foukouda/OPEN_WEIGHT/kibot_resources/templates/readme.txt

<p align="center" width="100%">
  
</p>

<h1 align="center">${PROJECT_NAME} – ${BOARD_NAME}</h1>

<p align="center">
  High-precision load-cell / force measurement PCB based on the AD7190
</p>

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

<p align="center">
  3D Top Angled
&nbsp; &nbsp; &nbsp; &nbsp;
  3D Bottom Angled
</p>

<p align="center">
  OPEN_WEIGHT 3D spin
  <br><sub>Full-resolution video: <a href="Images/OPEN_WEIGHT.mp4">Images/OPEN_WEIGHT.mp4</a> (rendered with SpinRender)</sub>
</p>

***

## OVERVIEW

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

***

## PROJECT CONTEXT

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

***

## DESIGN GOALS

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

***

## SPECIFICATIONS

### Electrical specifications

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

### Power budget

Power chain: **+3.3 V (host) → TPS61086 → +6 V → LT3042 → +5VA → AD7190**

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

> **Note:** Load cell excitation current depends on bridge resistance. The estimate above assumes a 350 Ω full bridge at 5 V excitation (~14 mA). A 1000 Ω bridge draws ~5 mA instead, reducing total board consumption significantly. TPS61086 efficiency is estimated from the datasheet curve at Vin=3.3 V, Vout=6 V. Always measure at your specific operating point using the **+3.3V_IN** test point on Page 6.

### Physical specifications

| Parameter | Value |
| --- | --- |
| Project name | OPEN_WEIGHT |
| Board name | AD7190 |
| Parent project | OPEN THRUST LAB |
| CAD tool | KiCad 10 |
| Automation tooling | KiBot + GitHub Actions |
| Dimensions | ${bb_w_mm} × ${bb_h_mm} mm |
| Mounting holes | 4× M3, connected to GND |
| Fiducials | Not fitted on this revision (FID1–FID6 excluded from board) |
| Fabrication target | JLCPCB 4-layer, JLC04161H-7628, 1.6 mm (rules in `OPEN_WEIGHT.kicad_dru`) |
| Repository status | In active development |
| Hardware licence | CERN-OHL-P v2 |

***

## SCHEMATIC ARCHITECTURE

The project is organized into five functional hierarchical sheets (under `Project Architecture`), plus the documentation sheets (Revision History, Block Diagram, Power - Sequencing):

| Page | Sheet (file) | Description |
| --- | --- | --- |
| 4 | `AD7190_Weight_Sensor` (`AD7190 - Weight Sensor.kicad_sch`) | AD7190 24-bit sigma-delta ADC front-end for Wheatstone bridge acquisition. Differential inputs on SENSE± and OUT± lines with RC input filtering. SPI interface (CS, DIN, DOUT, SCLK, SYNC). 4.9152 MHz ceramic resonator (Y2). Ratiometric reference REFIN1 = SENSE± (bridge excitation). Dual-supply decoupling (+5VA analog / +3.3V digital). Q1 P-MOS excitation switch driven by AD7190 P3. Test points on all critical analog and digital nodes. |
| 5 | `LT3042_6V_to_5VA` (`LT3042 - LDO 6V to 5VA.kicad_sch`) | Low-noise 5 V analog supply for ADC front-end (AVDD). LT3042 ultralow-noise LDO (PSRR > 75 dB). Input: +6V from boost stage. Output: +5VA regulated via RSET = 50 kΩ (ISET = 100 µA). Solid tantalum capacitor on SET pin (C14 = 2.2 µF) for noise suppression — soft-start time constant RSET·CSET = 110 ms. Power-Good monitoring via PGFB divider. Test points: VIN, VOUT, SET, PGFB, PG. |
| 6 | `TPS61086_3.3V_to_6V` (`TPS61086 - Boost 3V3 to 6V.kicad_sch`) | 3.3 V to 6.04 V boost converter (external Schottky D3) supplying the LT3042 stage. TPS61086 switching at 1.2 MHz fixed frequency (PWM/PFM selectable via MODE pin). Integrated 2.0 A / 0.13 Ω power switch. Output voltage set via FB divider R17/R15 (1.238 V × (1 + 69.8k/18k) = 6.04 V). Input/output decoupling, soft-start, and loop compensation network. Test points: +3.3V_IN, +6V_OUT, FB, COMP. |
| 7 | `Holes, Fiducials` (`Holes - Fiducials.kicad_sch`) | Mechanical references for PCB fabrication and assembly. Four GND-connected mounting holes (H1–H4, M3). Fiducial symbols FID1–FID6 are kept in the schematic but excluded from the board on this revision. |
| 8 | `Connectors` (`Connectors.kicad_sch`) | External interface connectors for load cell and host communication. Two 5-pin load-cell connectors J2/J4 (21033213501: OUT, OUT, EXC+, EXC−, GND). 7-pin JST-XH host header J1 (+3.3V, CS, DIN, DOUT/RDY, SYNC, SCLK, GND). WE-SHC shielding frame H5 over the analog front-end. |

***

## SIMULATION (LTspice)

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

**Models**

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

**Results**

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

**Re-run the simulations** (Windows, LTspice installed in the default location):

```bash
cd Simulation/LTspice
python run_simulations.py              # runs LTspice in batch mode, redraws Images/Simulation/*.png and results.md
python run_simulations.py --only 03 04 # runs only these simulations, then redraws
python run_simulations.py --no-run     # only redraw from the existing .raw files
```

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

***

## LAYOUT COUPLING (openEMS)

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

**Results**

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

The complete tables are in [`Simulation/openEMS/results.md`](Simulation/openEMS/results.md).

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

**Re-run the simulation** (Windows, openEMS and its Python 3.11 environment installed in `C:\openEMS`):

```bash
cd Simulation/openEMS
"C:\Program Files\KiCad\10.0\bin\python.exe" export_kicad_geometry.py   # copper of the board -> geometry.json
C:\openEMS\venv\Scripts\python.exe sw_coupling.py --check               # mesh the board and verify the nets
C:\openEMS\venv\Scripts\python.exe sw_coupling.py --case open           # the four drives on the bare board
C:\openEMS\venv\Scripts\python.exe sw_coupling.py --case shield         # the same with the cover
C:\openEMS\venv\Scripts\python.exe measurement_quality.py               # results.md and the figure
```

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

***

## LOAD CELL CONNECTION

The board accepts any standard **4-wire Wheatstone bridge** load cell.

### Load-cell connectors J2 / J4 (21033213501, 5 pins)

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

### Compatible load cell characteristics

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

### Host header J1 (JST-XH B7B-XH-AM, 7 pins)

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

***

## STARTUP SEQUENCE

After 3.3 V is applied, allow the following stages to complete before issuing any SPI command
(see schematic page 9, *Power - Sequencing*; values from the [LTspice simulations](#simulation-ltspice)):

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

After the delay, the recommended initialization sequence is:

```
1. Issue AD7190 serial reset: assert CS̄, write 40+ bytes of 0xFF on DIN
2. Write CONF register (gain, reference, chop settings)
3. Write MODE register (filter, ODR)
4. Run internal zero-scale calibration — wait for DRDȲ
5. Run internal full-scale calibration — wait for DRDȲ
6. Enable load cell excitation: GPOCON GP32EN=1, P3DAT=0 (Q1 on)
7. Run system calibration with known reference weight
8. Enter continuous conversion mode
```

***

## CALIBRATION

Two levels of calibration are required. Both must be repeated after every power cycle.

### 1. Internal calibration

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

```
Write MODE register: MD[2:0] = 0b001  (internal zero-scale)
→ Wait for DRDȲ to go low

Write MODE register: MD[2:0] = 0b010  (internal full-scale)
→ Wait for DRDȲ to go low

Results are saved in the ZERO and FULLSCALE registers.
Read them back to cache for faster subsequent startups.
```

### 2. System calibration

Maps ADC output codes to physical units. Repeat any time the mechanical setup changes.

```
1. Remove all load → average ≥16 samples → raw_zero
2. Apply known weight W_ref → average ≥16 samples → raw_full
3. scale_factor = W_ref / (raw_full − raw_zero)
4. weight = (raw_code − raw_zero) × scale_factor
```

### Recommended register configuration

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

***

## HOW TO USE

### Prerequisites

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

### Generate outputs locally

```bash
# Default configuration
./kibot_launch.sh

# Specific variant
./kibot_launch.sh -v CHECKED
```

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

### Use a manufactured board

```c
// --- After >= 600 ms from 3.3V power-on (LT3042 soft-start, see page 9) ---

// 1. Reset
ad7190_reset();                            // 40× 0xFF on DIN

// 2. Configure
ad7190_write_reg(REG_CONF,
    CONF_GAIN_128 | CONF_CHOP | CONF_REFSEL_REFIN1);
ad7190_write_reg(REG_MODE,
    MODE_SINC4 | MODE_FS_10HZ);

// 3. Internal calibration
ad7190_write_reg(REG_MODE, MODE_INT_ZERO_CAL);
while (drdy_is_high());
ad7190_write_reg(REG_MODE, MODE_INT_FULL_CAL);
while (drdy_is_high());

// 4. Enable load cell excitation
ad7190_write_reg(REG_GPOCON, GPOCON_GP32EN); // P3 = 0 -> Q1 on

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

// 6. Continuous measurement
ad7190_write_reg(REG_MODE, MODE_CONTINUOUS);
while (1) {
    while (drdy_is_high());
    uint32_t raw = ad7190_read_data();
    float weight = (raw - raw_zero) * scale;
}
```

***

## REPOSITORY CONTENT

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

***

## DIRECTORY STRUCTURE

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

***

## DEVELOPMENT WORKFLOW

This project uses a reproducible hardware workflow based on **KiCad 10**, **KiBot**, and **GitHub Actions**.

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

**Release a new hardware revision:**

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

***

## TROUBLESHOOTING

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

***

## CONTRIBUTING

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

### Requirements

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

### Workflow

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

### Reporting issues

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

***

## CHANGELOG

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

***

## LICENSE

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

See [LICENSE](LICENSE) for the full licence text.

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

> For more on CERN-OHL licences: [ohwr.org/cern_ohl](https://ohwr.org/cern_ohl)
