foukouda/OPEN_WEIGHT/Schematic/OPEN_WEIGHT-schematic-5.pdf

1 | 2 | 3 | 4 | 5 | 6 | 7 | 8

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
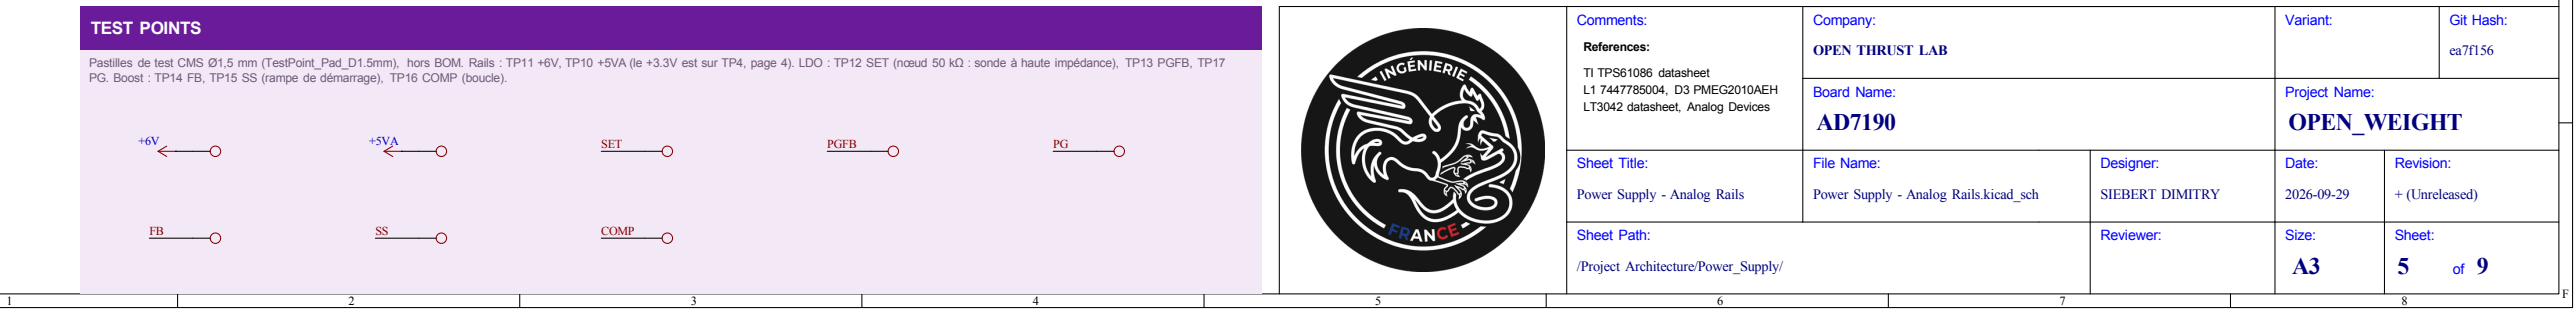
[picture p14: figure]
Sheet: of 9; Size: A3; Sheet Title:; File Name:; COMP; SET; PGFB; TEST POINTS; L1 7447785004, D3 PMEG2010AEH

Revision: + (Unreleased) Date: Project Name: 2026-09-29 Reviewer: Designer: Power Supply - Analog Rails.kicad_sch | SIEBERT DIMITRY
Board Name: Company: | Variant: OPEN THRUST LAB AD7190 | OPEN_WEIGHT
/Project Architecture/Power_Supply/ Sheet Path: Power Supply - Analog Rails Comments: | Git Hash: ea7f156 D¹ LED

D3 PMEG2010AEH

+6V R¹⁴ ²⁰⁰kΩ | C17 | 2.2nF R¹⁸ ³⁷.4kΩ C18 | 0.1uF | R¹⁵¹⁸kΩ | C1910µF R¹⁷ ⁶⁹.8kΩ C221µF
PWR_FLAG R³¹⁰⁰Ω | C2110µF | R¹⁶ 620Ω C134.7µF | C1510µF | D⁴ LED R¹³ ⁵⁰kΩ
IN 1 EN/UV 3 | PG 4
ILIM 5 | PGFB 6 SET 7 | GND

8 OUTS 9 OUT 10 U2 LT3042IMSE

+5VA

GND

+3.3V

+6V | R⁹⁵⁰kΩ
1 | 2 L1
7447785004 R¹² 715kΩ | C2010µF

1 2 C14

TAJA225K016RNJ C164.7µF | COMP | 1 FB
EN | 2
3 | AGND 4 | PGND 5 | SW_1 | 6
IN 8 | MODE 9 | SS 10 EP 11

IC2 TPS61086DRCR

GND

+6V

SET

SS

PG

PGFB

COMP

FB | DESCRIPTION

# [5] Power Supply - Analog Rails

- EN = +3.3V : démarre avec l'hôte. MODE = GND : Power Save à faible charge, raies sous 1.2 MHz quand les ponts sont coupés ; MODE à IN forcerait le PWM à fréquence fixe. • COMP : R18 37.4 kΩ + C17 2.2 nF vers AGND. SS : C18 0.1 µF chargé par 10 µA, limite le courant d'appel. • L1 Würth 7447785004 : 4.7 µH, blindée, Isat 2.5 A. D3 PMEG2010AEH : Schottky 20 V / 1 A. • Entrée C21 10 µF + C22 1 µF, sortie C19 + C20 10 µF. D1 par R3 100 Ω : ≈ 15 mA, presque un quart du courant pris à l'hôte. Boost VOUT = 1.238 V × (1 + 69.8 kΩ / 18 kΩ) = 6.04 V (sim 01 : 6.037 V) D = (6.04 + 0.35 − 3.3) / 6.39 = 0.48 ; Iout ≈ 23 mA → conduction discontinue, Ipk ≈ 0.16 A (sim 03 : 0.17 A)

Démarrage : 90 % en 1.1 ms, dépassement 6.35 V, appel 1.13 A < Isat 2.5 A
LDO
VOUT = 100 µA × 50 kΩ = 5.00 V ; VPG = 0.3 V × (1 + 715 kΩ / 50 kΩ) = 4.59 V
τ = RSET × CSET = 110 ms : 99 % en 241 ms, 99.9 % en 494 ms Marge 1.04 V × ≈ 23 mA ≈ 24 mW (+ 12 mW de courant de repos) Bruit et consommation +6V : 0.7 mV crête-crête (bande 20 MHz) ; PSRR 92 dB à 1.2 MHz ; +5VA < 1 µV crête-crête +3.3V pris à l'hôte : 66.5 mA, dont D1 ≈ 15 mA et D4 ≈ 5 mA

Chaîne : +3.3V (hôte, J1) → IC2 TPS61086, boost 1.2 MHz → +6V → U2 LT3042, LDO très bas bruit → +5VA. Le boost laisse ≈ 1 V de marge au LDO ; le +5VA alimente AVDD de l'AD7190 et l'excitation des ponts (page 4).

IC2 : interrupteur intégré 2.0 A / 0.13 Ω, L1 4.7 µH, D3 Schottky, régulation par R17 / R15 sur FB. U2 : source de courant 100 µA dans R9 (SET), suiveur de gain unitaire, 0.8 µV rms de 10 Hz à 100 kHz. Témoins : D1 sur +3.3V, D4 sur +5VA. Simulé dans Simulation/LTspice (modèle comportemental du TPS61086).

## DESIGN NOTE · BOOST

- IN et EN/UV sur +6V, ILIM à GND (limite interne). C16 4.7 µF en entrée, C13 4.7 µF + C15 10 µF en sortie (4.7 µF minimum pour la stabilité). • SET : R9 50 kΩ + C14 2.2 µF tantale solide KYOCERA AVX TAJA225K016RNJ (16 V, boîtier A, ESR 6.5 Ω) : pas d'effet piézo comme une céramique, important avec les vibrations du banc (datasheet p.16). • PGFB : R12 715 kΩ / R13 50 kΩ. PG (drain ouvert) tiré à +6V par R14 200 kΩ, sur TP17 seulement. D4 par R16 620 Ω. LAYOUT NOTE
- Boucle SW → D3 → C19 / C20 → PGND la plus courte : source principale du couplage magnétique vers les entrées de l'AD7190 (openEMS). Boucle d'entrée C21 / C22 → L1 → IC2 compacte, L1 loin des voies AIN. • Nœud SW minimal, réseau COMP / FB / SS sur AGND à l'écart de SW ; pads exposés de IC2 et U2 au plan GND par vias. • C14 et R9 au ras de SET (nœud 50 kΩ), OUTS en Kelvin sur les condensateurs de sortie, U2 loin de SW. CALCULS & BUDGET

Pastilles de test CMS Ø1,5 mm (TestPoint_Pad_D1.5mm), hors BOM. Rails : TP11 +6V, TP10 +5VA (le +3.3V est sur TP4, page 4). LDO : TP12 SET (nœud 50 kΩ : sonde à haute impédance), TP13 PGFB, TP17 PG. Boost : TP14 FB, TP15 SS (rampe de démarrage), TP16 COMP (boucle).

## DESIGN NOTE · LDO

## BOOST · IC2 TPS61086, +3.3V → +6V, 1.2 MHz

## LDO TRÈS BAS BRUIT · U2 LT3042, +6V → +5VA

FB : R17 69.8 kΩ / R15 18 kΩ → 6.04 V · COMP : R18 37.4 kΩ + C17 2.2 nF · SS : C18 0.1 µF · MODE = GND (Power Save)

TI TPS61086 datasheet References: LT3042 datasheet, Analog Devices Typical Applications de la datasheet LT3042 : topologie seulement

Figure 26 de la datasheet TPS61086 : placement recommandé RSET = R9 50 kΩ, CSET = C14 2.2 µF tantale, PG à 4.59 V (R12 / R13)

IC2 TPS61086DRCR

COMP | 1 FB
EN | 2
3 | AGND 4 | PGND 5 | SW_1 | 6
IN 8 | MODE 9 | SS 10 EP 11 | R¹² 715kΩ | D3 PMEG2010AEH
C17 | 2.2nF R¹⁸ ³⁷.4kΩ C18 | 0.1uF | R¹⁵¹⁸kΩ | C1910µF R¹⁷ ⁶⁹.8kΩ C134.7µF | C1510µFR¹³ ⁵⁰kΩ R¹⁴ ²⁰⁰kΩ

+6V

C2010µF | +6V

PWR_FLAG
