foukouda/OPEN_WEIGHT/Schematic/OPEN_WEIGHT-schematic-6.pdf

1 | 2 | 3 | 4 | 5 | 6 | 7 | 8
1 | 2 | 3 | 4 | 5 | 6 | 7 | 8

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
### Sheet: of 9 Size: A3

Revision: + (Unreleased) Date: Project Name: 2026-09-29 Reviewer: Designer: Holes - Fiducials.kicad_sch | SIEBERT DIMITRY
Board Name: Company: | Variant: OPEN THRUST LAB AD7190 | OPEN_WEIGHT
Sheet Title: | File Name:
/Project Architecture/Holes, Fiducials/ Sheet Path: Holes, Fiducials Comments: | Git Hash: ea7f156
H3 | H4 GND
H1 | H2 | FID5 Fiducial FID6 Fiducial FID3 Fiducial FID1 Fiducial FID2 Fiducial | FID4 Fiducial | CALCULS & BUDGET
[6] Holes,

# Fiducials

TROUS DE FIXATION · H1 À H4, M3, RELIÉS AU GND | FIDUCIALS · FID1 À FID6, NON MONTÉS
- Empreinte MountingHole_3.2mm_M3_Pad_Via : perçage 3.2 mm, pastille Ø6.4 mm, 8 vias Ø0.5 mm autour pour relier toutes les couches. • Reliés au GND : la vis met la masse de la carte au potentiel du support (banc moteur). Pour garder une masse flottante, utiliser des entretoises isolantes. • Fiducials Fiducial_1.5mm_Mask3mm (cuivre Ø1.5 mm, ouverture de vernis Ø3 mm) : à remettre sur le PCB si l'assembleur en demande (3 par face, en coin).

## DESIGN NOTE · FIXATION

Vis M3 Tête bombée ISO 7380 : Ø5.7 mm ; tête cylindrique ISO 4762 : Ø5.5 mm

Rondelle M3 (ISO 7089) : Ø7 mm → anneau libre de Ø7 mm autour de chaque trou Pastille Ø6.4 mm : la rondelle appuie sur le cuivre GND Quatre trous de fixation M3 (H1 à H4), métallisés et reliés au GND : ils tiennent la carte et ramènent sa masse au support

quand celui-ci est conducteur. Six fiducials (FID1 à FID3 face avant, FID4 à FID6 face arrière) restent au schéma mais sont exclus du PCB sur cette révision. DESCRIPTION

- Garder libre l'appui de la tête de vis et de la rondelle autour de chaque trou. • Pas de composant sensible aux contraintes mécaniques près des trous (résonateur Y2, condensateurs céramiques des

filtres, page 4).

## TEST POINTS

Pas de test point sur cette page. Les pastilles GND des trous H1 à H4 servent de point de masse pour la pince de la sonde.

## LAYOUT NOTE

Face avant (TOP) | Face arrière (BOT)

FID1-FID6 not fitted on this revision (https://jpieper.com/2022/06/28/flexible-i-o-source-configuration/)

4 x M3 (3.2 mm) plated holes to GND (https://jpieper.com/2022/06/30/flexible-i-o-worked-examples/)

References:

Exclus du PCB sur cette révision H1 | H2 | H3 | H4
