foukouda/OPEN_WEIGHT/Schematic/OPEN_WEIGHT-schematic-7.pdf

1 | 2 | 3 | 4 | 5 | 6 | 7 | 8

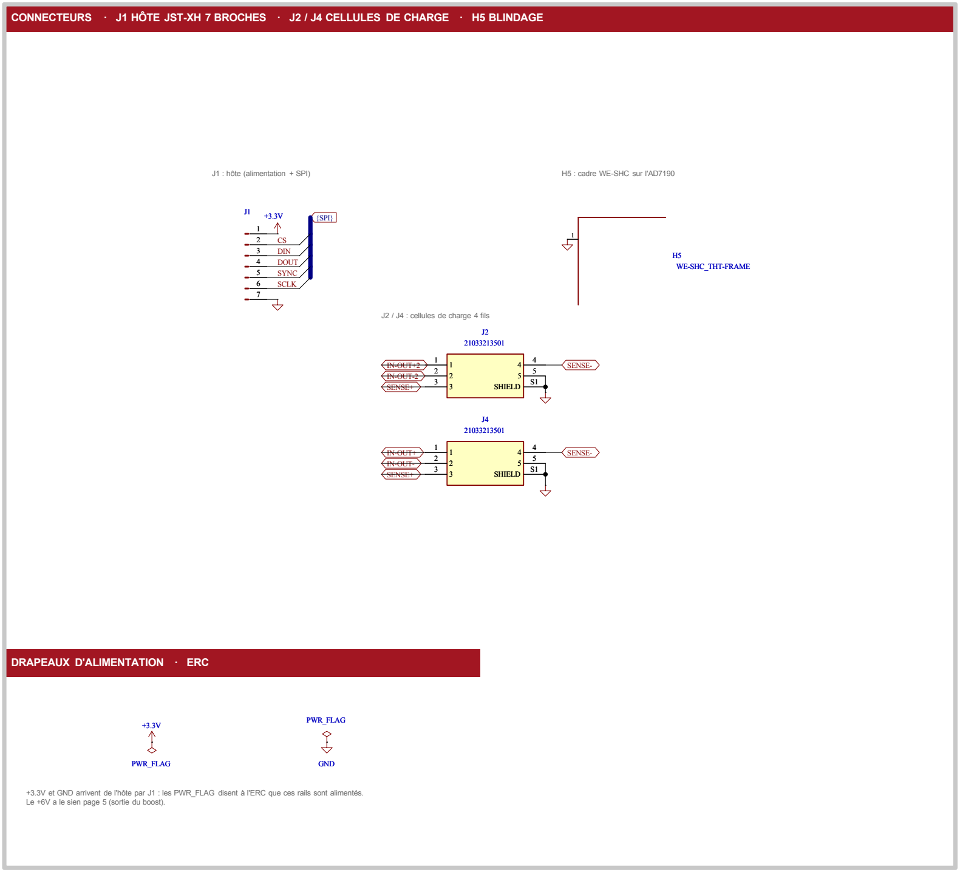
[picture p15: figure]
PWR_FLAG; 5 SHIELD; H5WE-SHC_THT-FRAME; GND; SENSE- SENSE+; IN-OUT+ IN-OUT-; {SPI}; IN-OUT-2; IN-OUT+2 CSDIN; SYNC SCLK; DRAPEAUX D'ALIMENTATION · ERC

1 | 2 | 3 | 4 | 5 | 6 | 7 | 8

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
### Sheet: of 9 Size: A3

### Revision: + (Unreleased) Date: Project Name: 2026-09-29 Reviewer: Designer:

Connectors.kicad_sch | SIEBERT DIMITRY
Board Name: Company: | Variant: OPEN THRUST LAB AD7190 | OPEN_WEIGHT
Sheet Title: | File Name:
/Project Architecture/Connectors/ Sheet Path: Connectors Comments: | Git Hash: ea7f156

## DOUT CONNECTEURS · J1 HÔTE JST-XH 7 BROCHES · J2 / J4 CELLULES DE CHARGE · H5 BLINDAGE

# [7] Connectors

Pas de test point sur cette page. Signaux des connecteurs : TP4 +3.3V, TP3 GND, TP9 / TP8 SENSE±, TP7 / TP6 voie 1 après filtre (page 4).

## TEST POINTS

## LAYOUT NOTE

## CALCULS & BUDGET

Courant pris sur J1 (+3.3V, sim 03) : 66.5 mA avec un pont 350 Ω alimenté Excitation : 5 V / 350 Ω = 14.3 mA par cellule (deux cellules : 28.6 mA)

Signal : cellule 2 mV/V sous 5 V → 10 mV à pleine charge, pour ±39 mV de pleine échelle (gain 128) Câble 4 fils : la chute dans les fils d'excitation n'est pas vue par la référence (prise au connecteur) → erreur de gain fixe, corrigée par l'étalonnage système.

## DESCRIPTION

- H5 couvre U1, les filtres RC et Y2 ; le monter avec son couvercle (openEMS, voie 2 : 15 nV au lieu de 38 nV). • Blindage (S1) et broche 5 de J2 / J4 au GND, au plus court. • Paire signal de chaque voie routée ensemble jusqu'aux résistances 100 Ω du filtre (page 4). J1 : embase JST-XH 7 broches (B7B-XH-AM) vers l'hôte : alimentation +3.3V et bus SPI de l'AD7190. J2 / J4 : embases circulaires HARTING 21033213501 (5 broches + blindage) pour deux cellules de charge 4 fils : J4 = voie 1

(AIN1/AIN2), J2 = voie 2 (AIN3/AIN4). Les deux embases partagent l'excitation SENSE± (commutée par Q1 et BPDSW, page 4) ; seuls les fils signal sont séparés. H5 : cadre de blindage Würth WE-SHC 36503205 (20 × 20 × 3 mm, fer blanc) relié au GND, au-dessus du front-end. J1 (hôte) : 1 +3.3V · 2 CS · 3 DIN · 4 DOUT/RDY · 5 SYNC · 6 SCLK · 7 GND

J2 / J4 (cellule) : 1 signal (IN-OUT+), 2 signal (IN-OUT−), 3 EXC+ (SENSE+), 4 EXC− (SENSE− / BPDSW), 5 et blindage : GND

- Les deux voies lisent V(broche 2) − V(broche 1) : charge lue négative → inverser les fils signal ou le signe dans le firmware. • SPI mode 3 uniquement (CPOL = 1, CPHA = 1), SCLK ≤ 5 MHz. Pas de broche DRDY séparée : lire DOUT/RDY avec CS bas. • Les couleurs de câble varient selon le fabricant : vérifier EXC± et SIG± au multimètre avant la mise sous tension. DESIGN NOTE · BROCHAGE
J1 : hôte (alimentation + SPI) | J2 / J4 : cellules de charge 4 fils | H5 : cadre WE-SHC sur l'AD7190

J2/J4 21033213501, H5 WE-SHC (https://jpieper.com/2022/06/28/flexible-i-o-source-configuration/)

JST XH B7B-XH-AM (J1) (https://jpieper.com/2022/06/30/flexible-i-o-worked-examples/) +3.3V et GND arrivent de l'hôte par J1 : les PWR_FLAG disent à l'ERC que ces rails sont alimentés. Le +6V a le sien page 5 (sortie du boost). | References:
