foukouda/OPEN_WEIGHT/Schematic/OPEN_WEIGHT-schematic-8.pdf

1 | 2 | 3 | 4 | 5 | 6 | 7 | 8

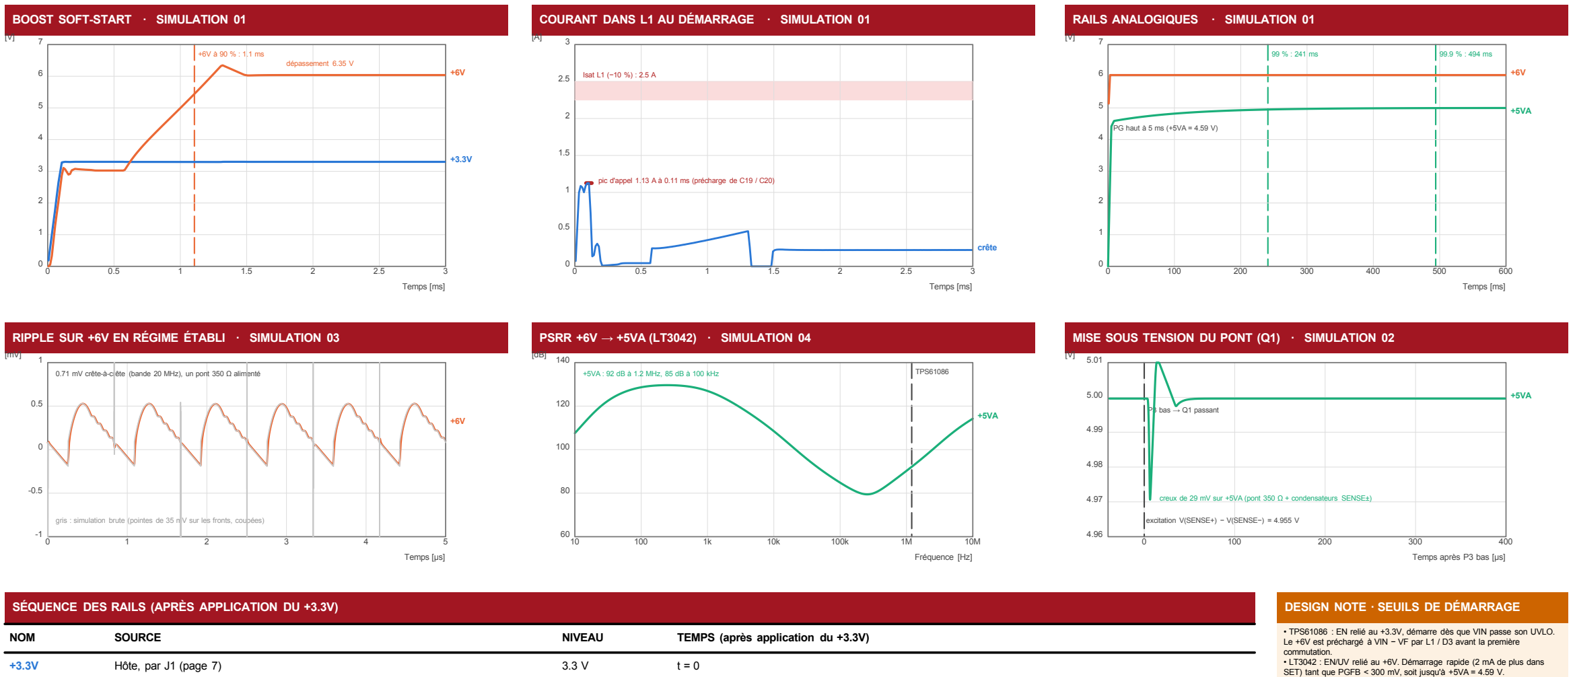
[picture p16: figure]
BOOST SOFT-START · SIMULATION 01; RAILS ANALOGIQUES · SIMULATION 01; 400 Temps après P3 bas [µs] 120; Isat L1 (−10 %) : 2.5 A; crête; P3 bas → Q1 passant; Hôte, par J1 (page 7); Temps [µs] 3; dépassement 6.35 V NOM; Fréquence [Hz]; TPS61086; 5.00 Temps [ms] 100; NIVEAU; 4.97 TEMPS (après application du +3.3V)

1 | 2 | 3 | 4 | 5 | 6 | 7 | 8

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
### Sheet: of 9 Size: A3

Revision: + (Unreleased) Date: Project Name: 2026-09-29 Reviewer: Designer: Power - Sequencing.kicad_sch | SIEBERT DIMITRY
Board Name: Company: | Variant: OPEN THRUST LAB AD7190 | OPEN_WEIGHT
Sheet Title: | File Name:
/Power - Sequencing/ Sheet Path: Power - Sequencing Comments: | Git Hash: ea7f156 DESCRIPTION

# [8] Power - Sequencing

## DESIGN NOTE · DÉMARRAGE PLUS RAPIDE

Ordre et temps d'établissement des rails après l'arrivée du +3.3V (simulations LTspice 01 à 03, modèle comportemental du TPS61086). Le boost monte en premier, le LT3042 suit le +6V puis finit de monter avec la constante RSET × CSET = 110 ms. Aucun Power-Good n'est transmis à l'hôte : c'est l'hôte qui attend.

## COURANT DANS L1 AU DÉMARRAGE · SIMULATION 01

- TPS61086 : EN relié au +3.3V, démarre dès que VIN passe son UVLO. Le +6V est préchargé à VIN − VF par L1 / D3 avant la première

commutation. • LT3042 : EN/UV relié au +6V. Démarrage rapide (2 mA de plus dans SET) tant que PGFB < 300 mV, soit jusqu'à +5VA = 4.59 V. • PG ne signale que la fin du démarrage rapide, pas un +5VA établi ; il n'est pas relié à l'hôte. τ = RSET × CSET = 50 kΩ × 2.2 µF = 110 ms +5VA(t) = 5 V − 0.41 V × e^(−(t − 5 ms) / τ) après PG

99.9 % : t = 5 ms + τ × ln(0.41 V / 5 mV) = 5 + 110 × 4.41 = 490 ms (sim : 494 ms) Appel : 1.13 A dans L1 à 0.11 ms, < Isat 2.5 A CHRONOLOGIE DU DÉMARRAGE (ÉCHELLE LOG)

## DESIGN NOTE · ATTENTE ≥ 600 MS

+5VA à 99.9 % après 494 ms. L'hôte attend au moins 600 ms après la mise sous tension avant le reset et l'étalonnage de l'AD7190. PG passe à 1 dès 5 ms : ne pas s'en servir comme signal de départ.

## SÉQUENCE CÔTÉ HÔTE (RECOMMANDÉE)

RIPPLE SUR +6V EN RÉGIME ÉTABLI · SIMULATION 03 | PSRR +6V → +5VA (LT3042) · SIMULATION 04

## CALCULS & BUDGET

SÉQUENCE DES RAILS (APRÈS APPLICATION DU +3.3V) | DESIGN NOTE · SEUILS DE DÉMARRAGE
1. Appliquer le +3.3V : le boost démarre seul (EN = VIN). 2. Attendre ≥ 600 ms : +5VA à 99.9 %. 3. Reset série de l'AD7190 : CS bas, ≥ 40 bits à 1 sur DIN. 4. CONF : gain 128, REFIN1, chop. MODE : SINC4, FS = 480. 5. Excitation : GPOCON BPDSW = 1, GP32EN = 1, P3DAT = 0. REFIN1 = SENSE± n'existe que pont alimenté. 6. Étalonnages internes zéro puis pleine échelle (attendre RDY). 7. Étalonnage système (masse connue), puis conversion continue.

## MISE SOUS TENSION DU PONT (Q1) · SIMULATION 02

C14 fixe à la fois le démarrage et le filtrage du bruit de la référence du LT3042. Avec 0.47 µF : τ = 50 kΩ × 0.47 µF = 23.5 ms, +5VA à 99.9 % vers 110 ms, au prix d'un peu plus de bruit basse fréquence.

Temps [ms] PG haut à 5 ms (+5VA = 4.59 V) | 99 % : 241 | ms | +5VA

## 99 % après 241 ms, 99.9 % après 494 ms (τ = 110 ms)

+5VA : 92 dB à 1.2 MHz, 85 dB à 100 | kHz | +5VA

pic d'appel 1.13 A à 0.11 ms (précharge de C19 / C20)

excitation V(SENSE+) − V(SENSE−) = 4.955 V creux de 29 mV sur +5VA (pont 350 Ω + condensateurs SENSE±) SOURCE

2 | 2.5 | Temps [ms]3 U2 LT3042, RSET = R9 50 kΩ, CSET = C14 2.2 µF

## U2 LT3042, PGFB = R12 / R13, drain ouvert tiré à +6V

## IC2 TPS61086, boost 1.2 MHz, soft-start C18

gris : simulation brute | (pointes de 35 mV sur les fronts, coupées)

+6V

PG

0.1 ms | 1 ms | 10 ms | 100 ms | 1 s | README : Startup sequence References: Simulation/LTspice : 01, 02, 03, 04 +5VA
10 µs | après l'attente de l'hôte (≥ 600 ms)

4.955 V

4.59 V

6.04 V

5.00 V

0.71 mV crête-à-crête (bande 20 MHz), un pont 350 Ω alimenté

90 % à 1.1 ms attente ≥ 600 ms PG

+5VA

+6V

Hôte SENSE± | Q1 (grille sur P3) + BPDSW, commande du firmware

RESET + étalonnage AD7190

99 % : 241 ms, 99.9 % : 494 ms haut à 5 ms | 90 % après 1.1 ms, dépassement 6.35 V
1k | 10k | 100k haut après 5 ms : fin du démarrage rapide
