foukouda/OPEN_WEIGHT/Schematic/OPEN_WEIGHT-schematic-9.pdf

1 | 2 | 3 | 4 | 5 | 6 | 7 | 8
1 | 2 | 3 | 4 | 5 | 6 | 7 | 8

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
Sheet: of 9
Size: A3
Revision: + (Unreleased) Date: Project Name: 2026-09-29 Reviewer: Designer: Revision History.kicad_sch | SIEBERT DIMITRY
Board Name: Company: | Variant: OPEN THRUST LAB AD7190 | OPEN_WEIGHT
Sheet Title: | File Name:
/Revision History/ Sheet Path: Revision History Comments: | Git Hash: ea7f156

___________________________________ Added

- AD7190 front-end, 2 load-cell inputs
- +3.3V -> TPS61086 6 V -> LT3042 +5VA
- Self-contained libs and 3D models (lib/)
- JLCPCB 4-layer rules and stackup
- LTspice simulations (Simulation/LTspice)
- openEMS layout coupling (Simulation/openEMS) ___________________________________ Changed
- Renamed to OPEN_WEIGHT, KiCad 10
- Schematic restyled like OPEN_PHASE: A3 sheets, note panels, logo in title block
- Boost and LDO sheets merged into Power Supply - Analog Rails (page 5)
- Bottom silkscreen: test point tags, J1 pinout, load-cell wiring panel - 3D animation re-rendered with kicad-cli, OPEN_PHASE

style

___________________________________ Fixed

- Connectors not linked to ADC in schematic
- AD7190 solder-mask bridges

# [9] Revision History

Version Unreleased
