foukouda/OPEN_WEIGHT/Schematic/OPEN_WEIGHT-schematic-10.pdf

1 | 2 | 3 | 4 | 5 | 6
1 | 2 | 3 | 4 | 5 | 6

A

B

CD

A

B

CD 10

Sheet: of 10
Size: A4
Revision: + (Unreleased) Date: Project Name: 2026-09-29 Reviewer: Designer: Revision History.kicad_sch | SIEBERT DIMITRY
Board Name: Company: | Variant: OPEN THRUST LAB AD7190 | OPEN_WEIGHT
Sheet Title: | File Name:
/Revision History/ Sheet Path: Revision History Comments: | Git Hash: 349b121

Version Unreleased
___________________________________ Added
- AD7190 front-end, 2 load-cell inputs
- +3.3V -> TPS61086 6 V -> LT3042 +5VA
- Self-contained libs and 3D models (lib/)
- JLCPCB 4-layer rules and stackup
- LTspice simulations (Simulation/LTspice)
- openEMS layout coupling
(Simulation/openEMS) ___________________________________ Changed
- Renamed to OPEN_WEIGHT, KiCad 10

___________________________________ Fixed

- Connectors not linked to ADC in schematic
- AD7190 solder-mask bridges

# [10] Revision History
