foukouda/OPEN_WEIGHT/HTML/images/cat_pdf_drill_map_OPEN_WEIGHT-front-in2_drill_map.png

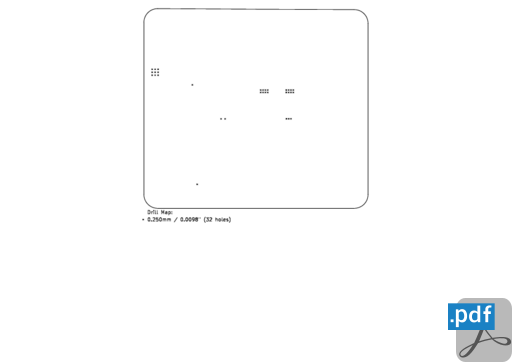
HTML/images/cat_pdf_drill_map_OPEN_WEIGHT-front-in2_drill_map.png
