foukouda/OPEN_WEIGHT/HTML/images/cat_pdf_drill_map_OPEN_WEIGHT-NPTH_drill_map.png

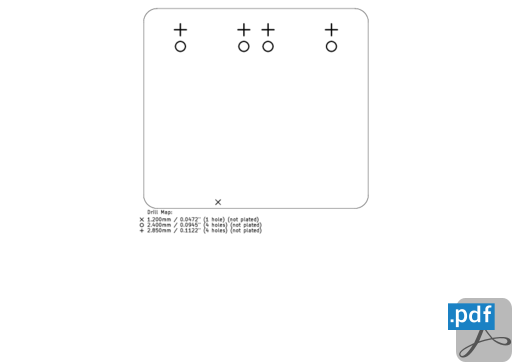
HTML/images/cat_pdf_drill_map_OPEN_WEIGHT-NPTH_drill_map.png
