foukouda/OPEN_WEIGHT/HTML/images/cat_pdf_drill_map_OPEN_WEIGHT-PTH_drill_map.png

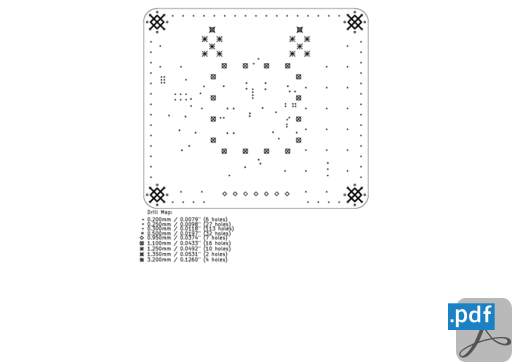
HTML/images/cat_pdf_drill_map_OPEN_WEIGHT-PTH_drill_map.png
