foukouda/OPEN_WEIGHT/HTML/images/cat_pdf_schematic_OPEN_WEIGHT-schematic.png

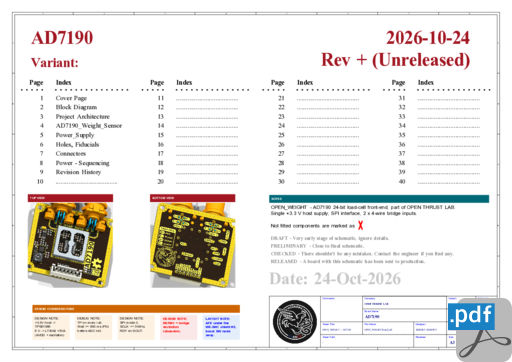
HTML/images/cat_pdf_schematic_OPEN_WEIGHT-schematic.png
