foukouda/OPEN_WEIGHT/HTML/images/cat_png_3d_viewer_bottom_OPEN_WEIGHT-bottom.png

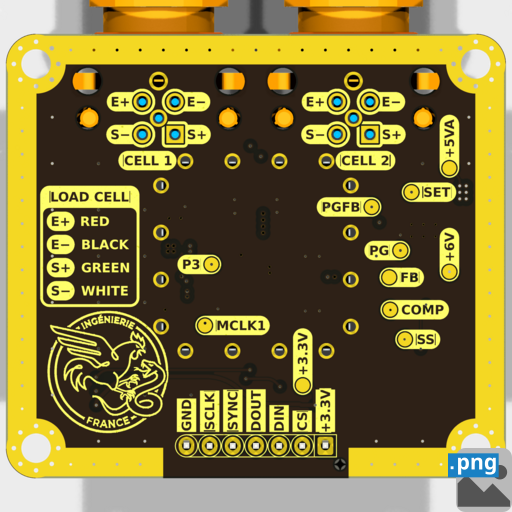
HTML/images/cat_png_3d_viewer_bottom_OPEN_WEIGHT-bottom.png
