foukouda/OPEN_WEIGHT/HTML/images/cat_png_3d_viewer_top_OPEN_WEIGHT-top.png

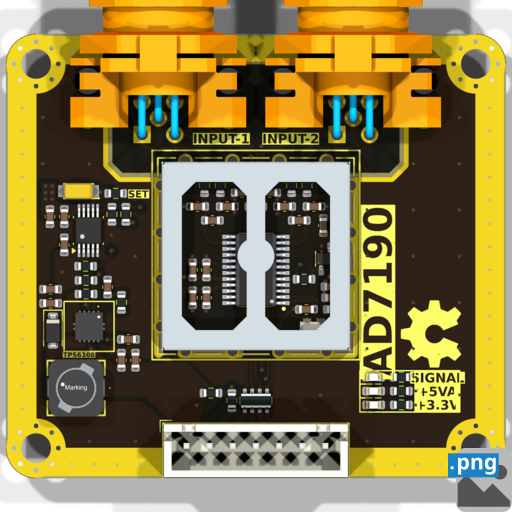
HTML/images/cat_png_3d_viewer_top_OPEN_WEIGHT-top.png
