foukouda/OPEN_WEIGHT/Testing/Testpoints/OPEN_WEIGHT-testpoints-bottom.csv

Ref. | Net | X [mm] | Y [mm]
TP2 | MCLK1 | 89.50 | 8.50
TP4 | +3.3V | 78.94 | 2.05
TP5 | +5VA | 63.10 | 25.50
TP11 | +6V | 63.10 | 14.30
TP12 | SET | 67.20 | 22.90
TP13 | PGFB | 71.50 | 21.30
TP14 | FB | 69.60 | 13.70
TP15 | SS | 67.90 | 7.00
TP16 | COMP | 69.50 | 10.20
TP17 | PG | 68.40 | 16.60
TP18 | P3 | 88.80 | 15.10
