foukouda/OPEN_WEIGHT/3D/OPEN_WEIGHT.step

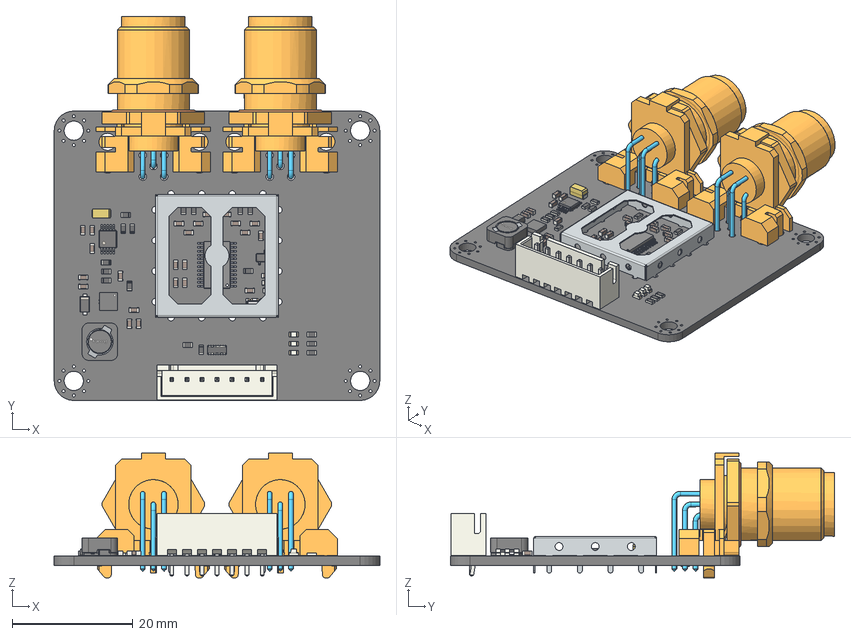
[picture p23: CAD file, 2026-10-24]
3D/OPEN_WEIGHT.step
54.0 x 63.7 x 20.7 mm
R_0603_1608Metric x 17
C_0603_1608Metric x 28
Base
Pin x 2
glue
Core
Shielding
TPS16412DRCR
SOT-23-3
AD7366BRUZ
JST_B7B_XH_A
LED_0603_1608Metric x 3
D_SOD_123F
R_Array_Concave_4x0603
1021531A
FilletPin1
FilletPin2
MSOP-10-1EP_3x3mm_P0.5mm_EP1.68x1.88mm
CSTCR4M00G55B-R0
kibot_cx0ehsvx_PCB
