foukouda/OPEN_WEIGHT/Mechanical/ad7190.step

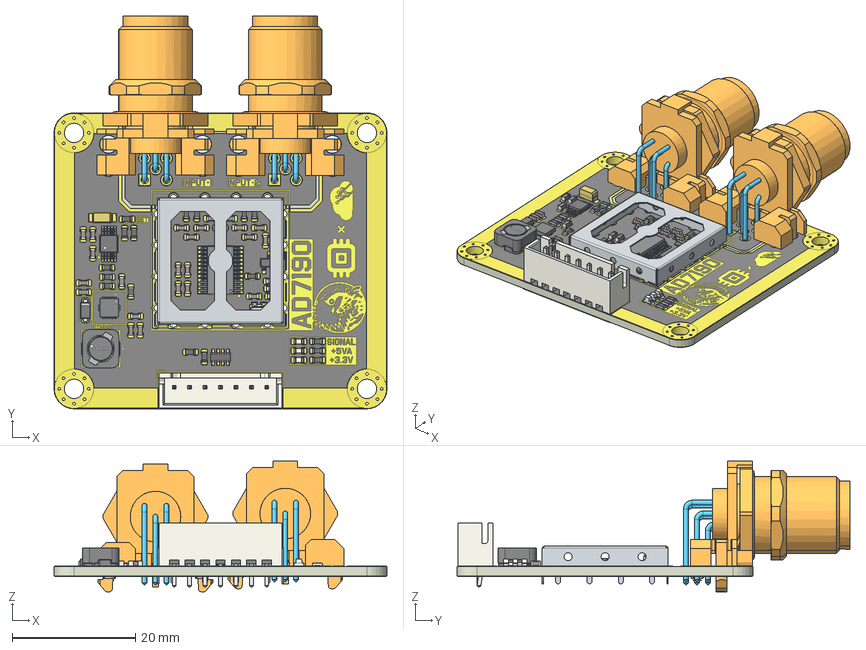
[picture p24: CAD file, 2026-09-29]
Mechanical/ad7190.step
54.0 x 63.7 x 21.2 mm
R_0603_1608Metric x 17
C_0603_1608Metric x 28
Base
Pin x 2
glue
Core
Shielding
TPS61086DRCR
SOT-23-3
AD7190WBRUZ
JST_XH_B7B-XH-A_1x07_P2.50mm_Vertical
LED_0603_1608Metric x 3
D_SOD-123F
R_Array_Concave_4x0603
Download_STP_WE-SHC-36503205S+%28rev1%29
FilletPin1
FilletPin2
MSOP-10-1EP_3x3mm_P0.5mm_EP1.68x1.88mm
CSTCR4M91G53-R0
Cellule_de_force_V2_copper
Cellule_de_force_V2_silkscreen x 2
Cellule_de_force_V2_soldermask x 2
Cellule_de_force_V2_PCB
