foukouda/OPEN_WEIGHT/Manufacturing/Assembly/OPEN_WEIGHT-assembly_notes.txt

ASSEMBLY NOTES (UNLESS OTHERWISE SPECIFIED)

1)	DO NOT POPULATE PARTS ARE MARKED WITH A RED CROSS.

2)	DO NOT POPULATE PARTS ARE NOT PRESENT IN THE BOM.

3)	IF CONFLICTING INFORMATION IS FOUND BETWEEN THE ASSEMBLY
	FILE AND BOM, BOM SHOULD BE USED AS THE MAIN SOURCE.

4)	CONFORMAL COATING IS NOT REQUIRED.

5)	DOT IDENTIFIES PIN #1 LOCATION AND DEVICE ORIENTATION
	WHEN VIEWED FROM THE TOP.
