foukouda/OPEN_WEIGHT/Manufacturing/Fabrication/OPEN_WEIGHT-fabrication.pdf

# Top Fabrication (Scale 1:1)

# AD7190 Fabrication Document

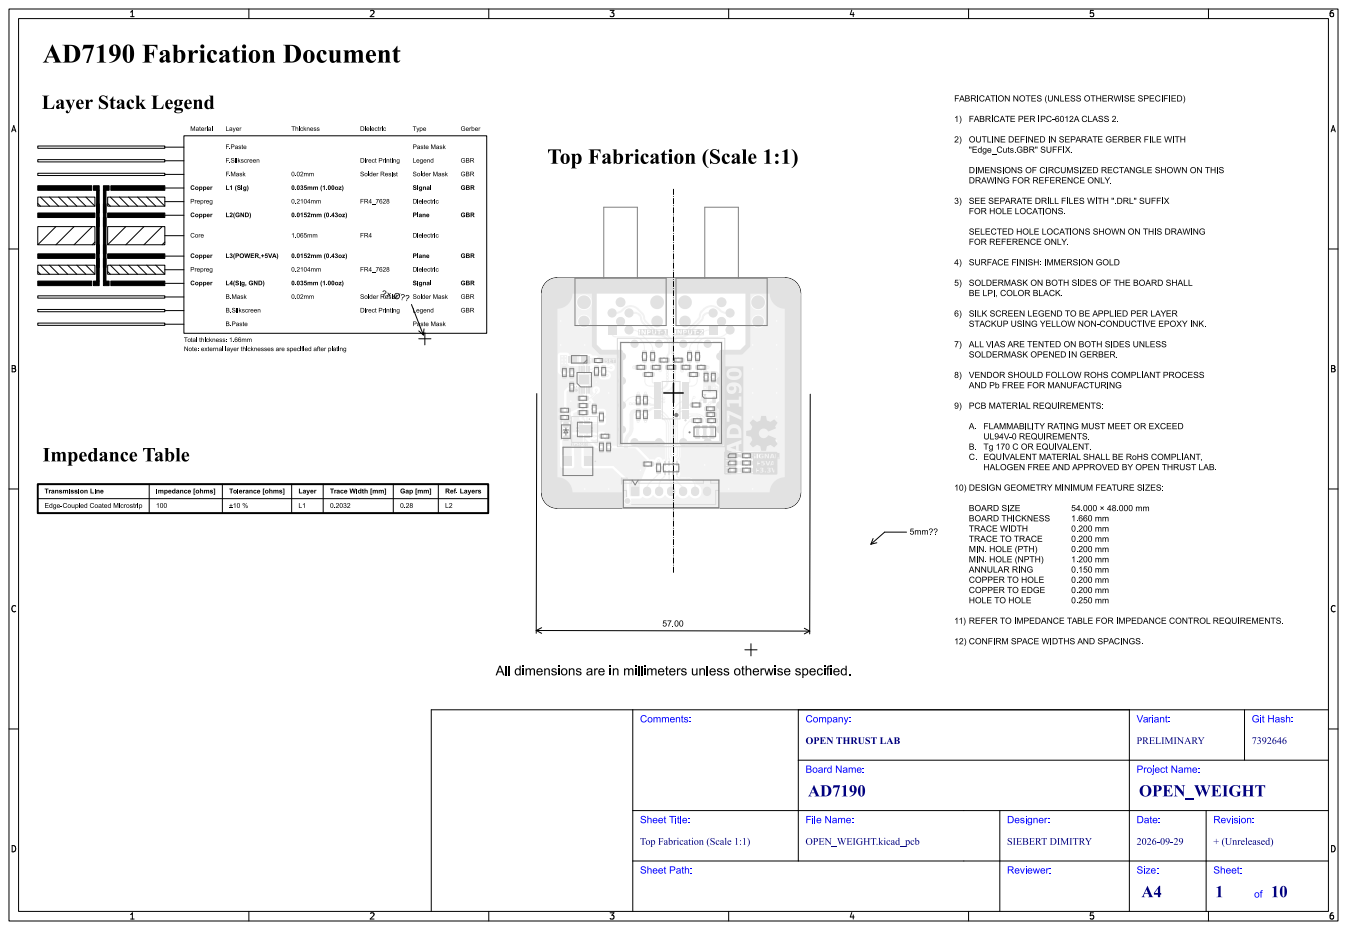
[picture p25: page 1]
Git Hash:; Comments:; Sheet Path:; Sheet Title:; File Name:; OPEN_WEIGHT; Company:; PRELIMINARY; Variant:; Board Name:; OPEN_WEIGHT.kicad_pcb; SIEBERT DIMITRY; Designer:; Reviewer:; Project Name:; Date:; + (Unreleased); Revision:; Size:; Sheet:

OPEN THRUST LAB

Top Fabrication (Scale 1:1)

# Bottom Fabrication (Scale 1:1)

# AD7190 Fabrication Document

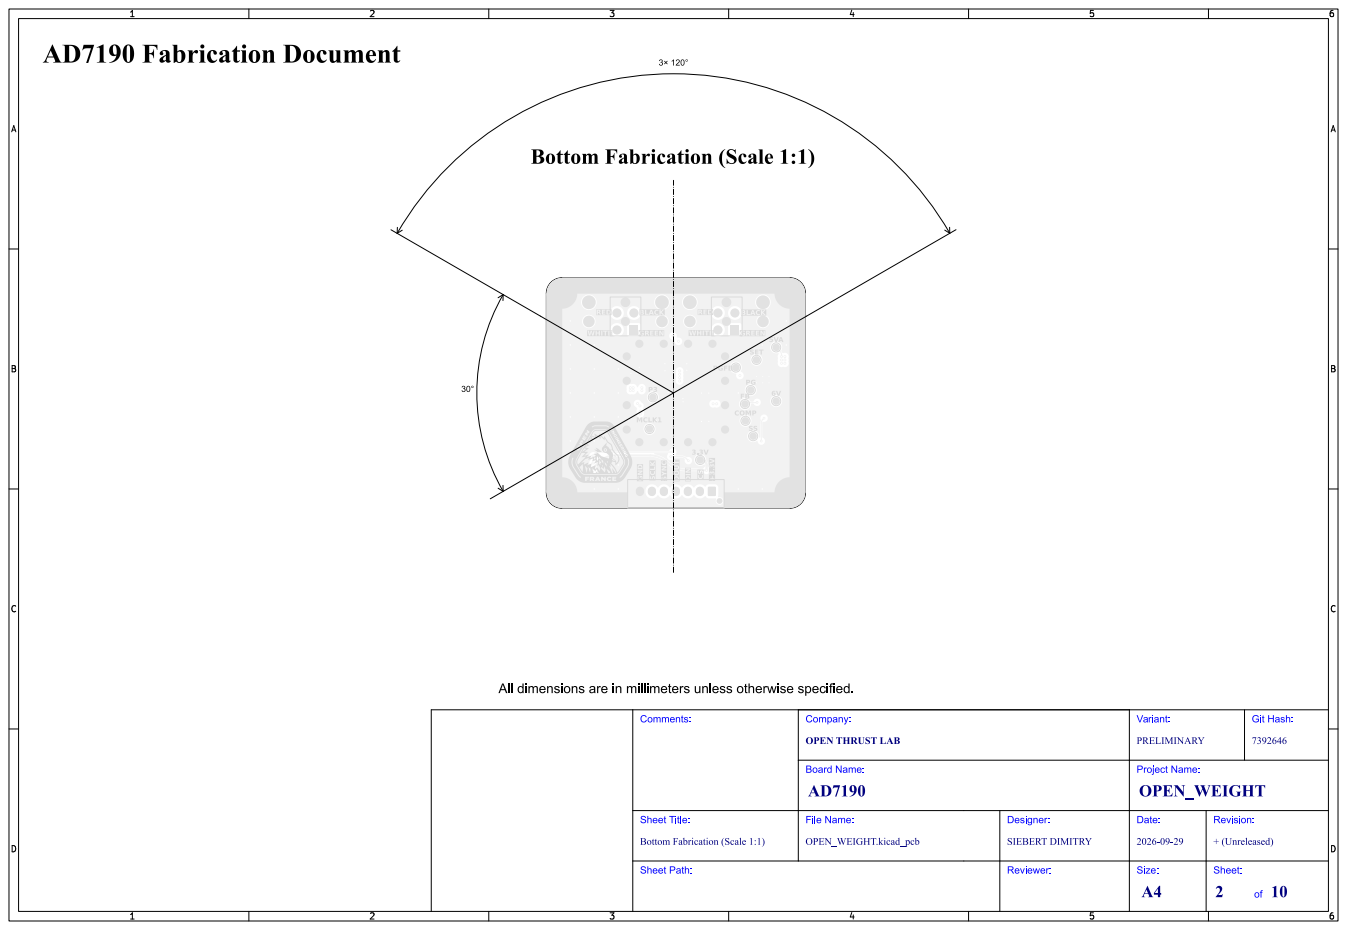
[picture p26: page 2]
Git; Hash:; Comments:; Sheet Path:; Sheet Title:; File Name:; OPEN_WEIGHT; Company:; PRELIMINARY; Variant:; Board Name:; OPEN_WEIGHT.kicad_pcb; SIEBERT DIMITRY; Designer:; Reviewer:; Project Name:; Date:; + (Unreleased); Revision:; Size:; Sheet:

OPEN THRUST LAB

Bottom Fabrication (Scale 1:1)

# Drill Drawing L1 - L4 (Scale 1:1)

# AD7190 Fabrication Document

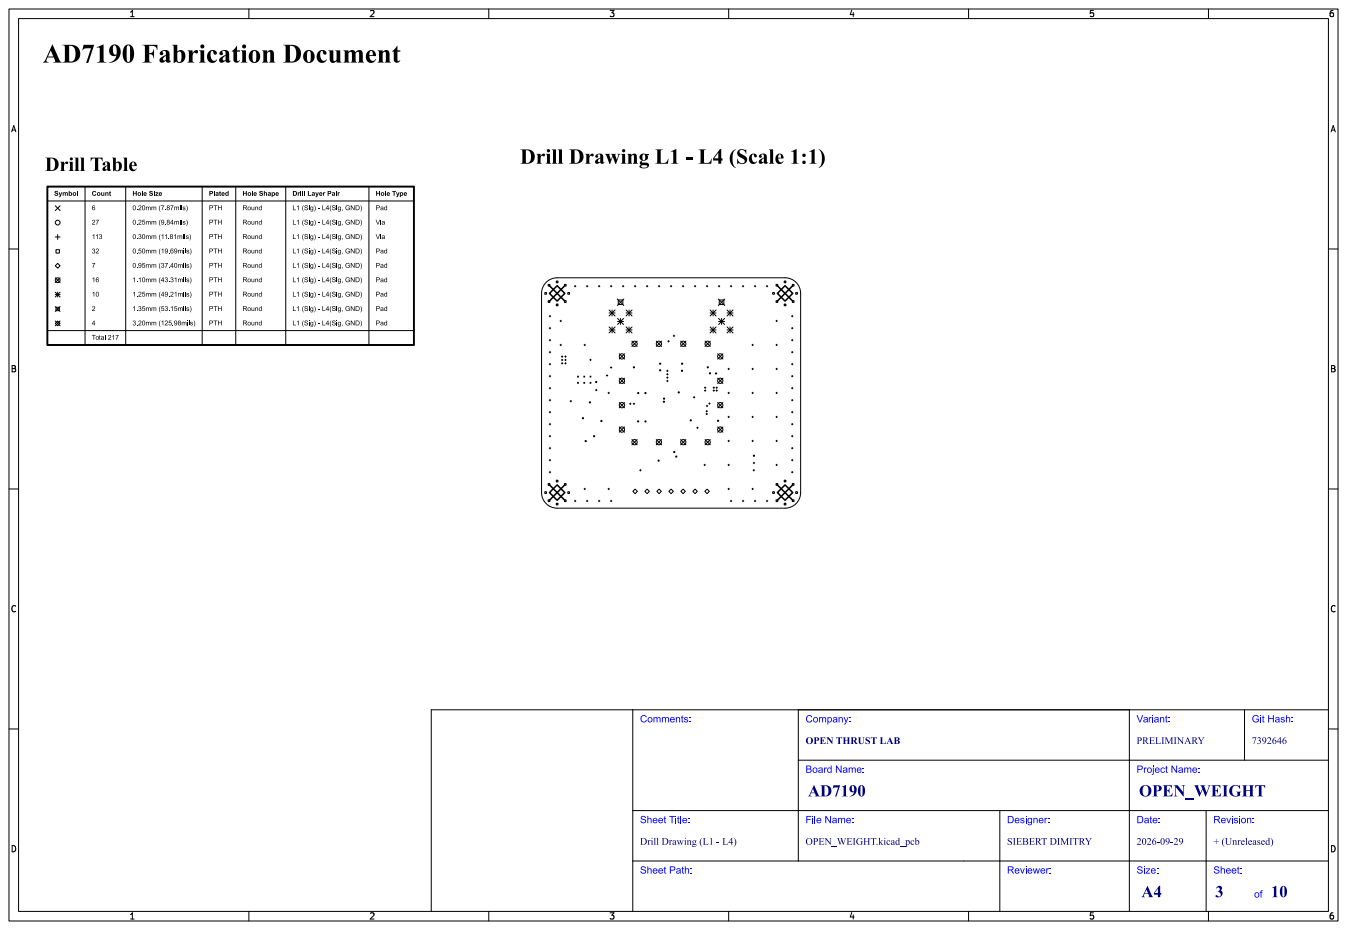
[picture p27: page 3]
Git; Hash:; Comments:; Drill Drawing (L1 - L4); Sheet Path:; Sheet Title:; File Name:; OPEN_WEIGHT; Company:; PRELIMINARY; Variant:; Board Name:; OPEN_WEIGHT.kicad_pcb; SIEBERT DIMITRY; Designer:; Reviewer:; Project Name:; Date:; + (Unreleased); Revision:; Size:; Sheet:

OPEN THRUST LAB

# Drill Drawing L1 - L4 (Scale 1:1)

# AD7190 Fabrication Document

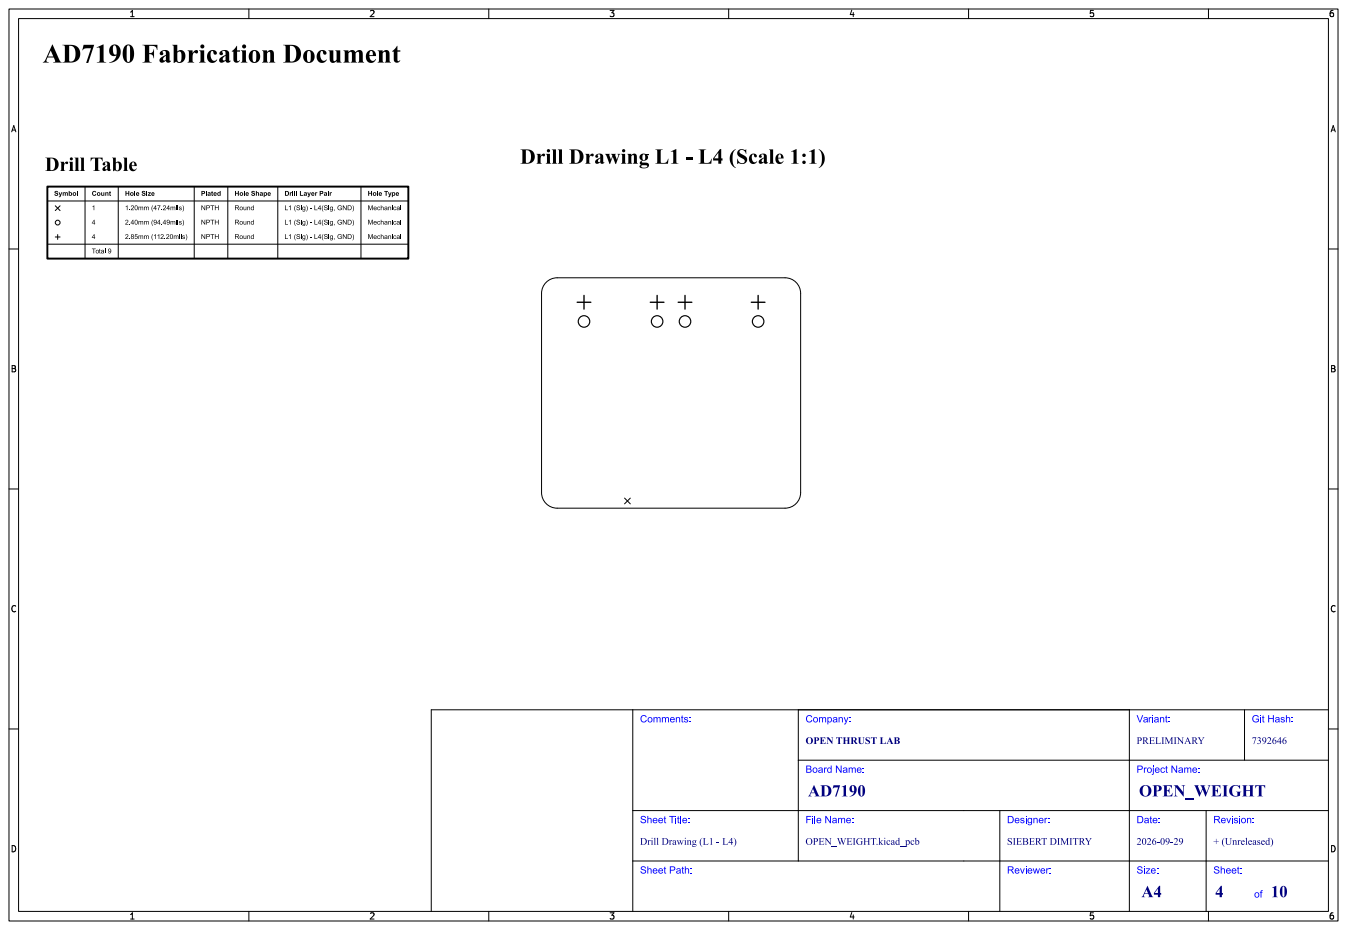
[picture p28: page 4]
Git; Hash:; Comments:; Drill Drawing (L1 - L4); Sheet Path:; Sheet Title:; File Name:; OPEN_WEIGHT; Company:; PRELIMINARY; Variant:; Board Name:; OPEN_WEIGHT.kicad_pcb; SIEBERT DIMITRY; Designer:; Reviewer:; Project Name:; Date:; + (Unreleased); Revision:; Size:; Sheet:

OPEN THRUST LAB

# Top Test Points (Scale 1:1)

# AD7190 Fabrication Document

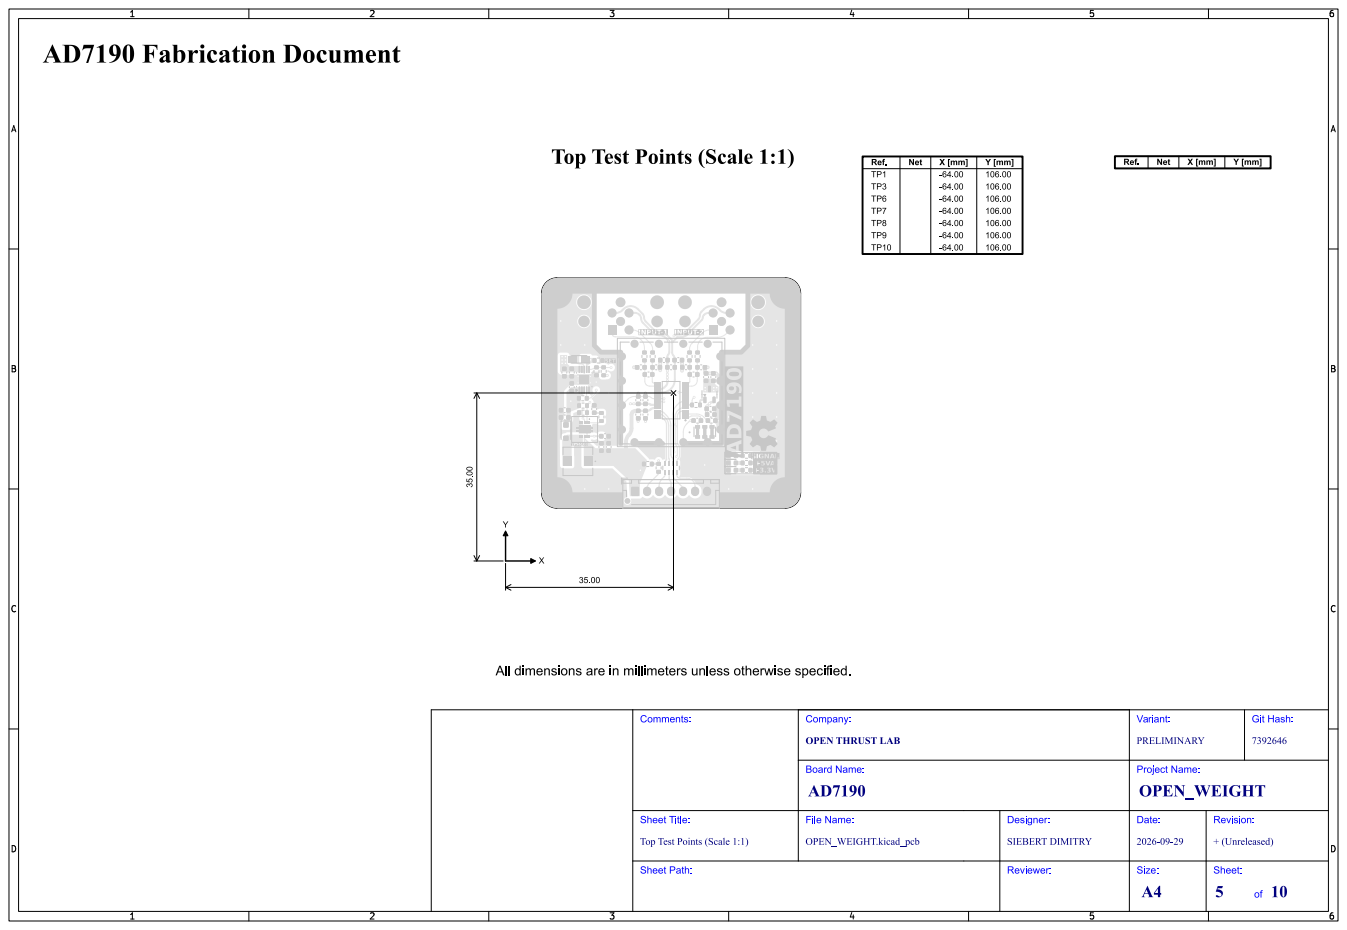
[picture p29: page 5]
Git; Hash:; Comments:; Sheet Path:; Sheet Title:; File Name:; OPEN_WEIGHT; Company:; PRELIMINARY; Variant:; Board Name:; OPEN_WEIGHT.kicad_pcb; SIEBERT DIMITRY; Designer:; Reviewer:; Project Name:; Date:; + (Unreleased); Revision:; Size:; Sheet:

OPEN THRUST LAB

Top Test Points (Scale 1:1)

# Bottom Test Points (Scale 1:1)

# AD7190 Fabrication Document

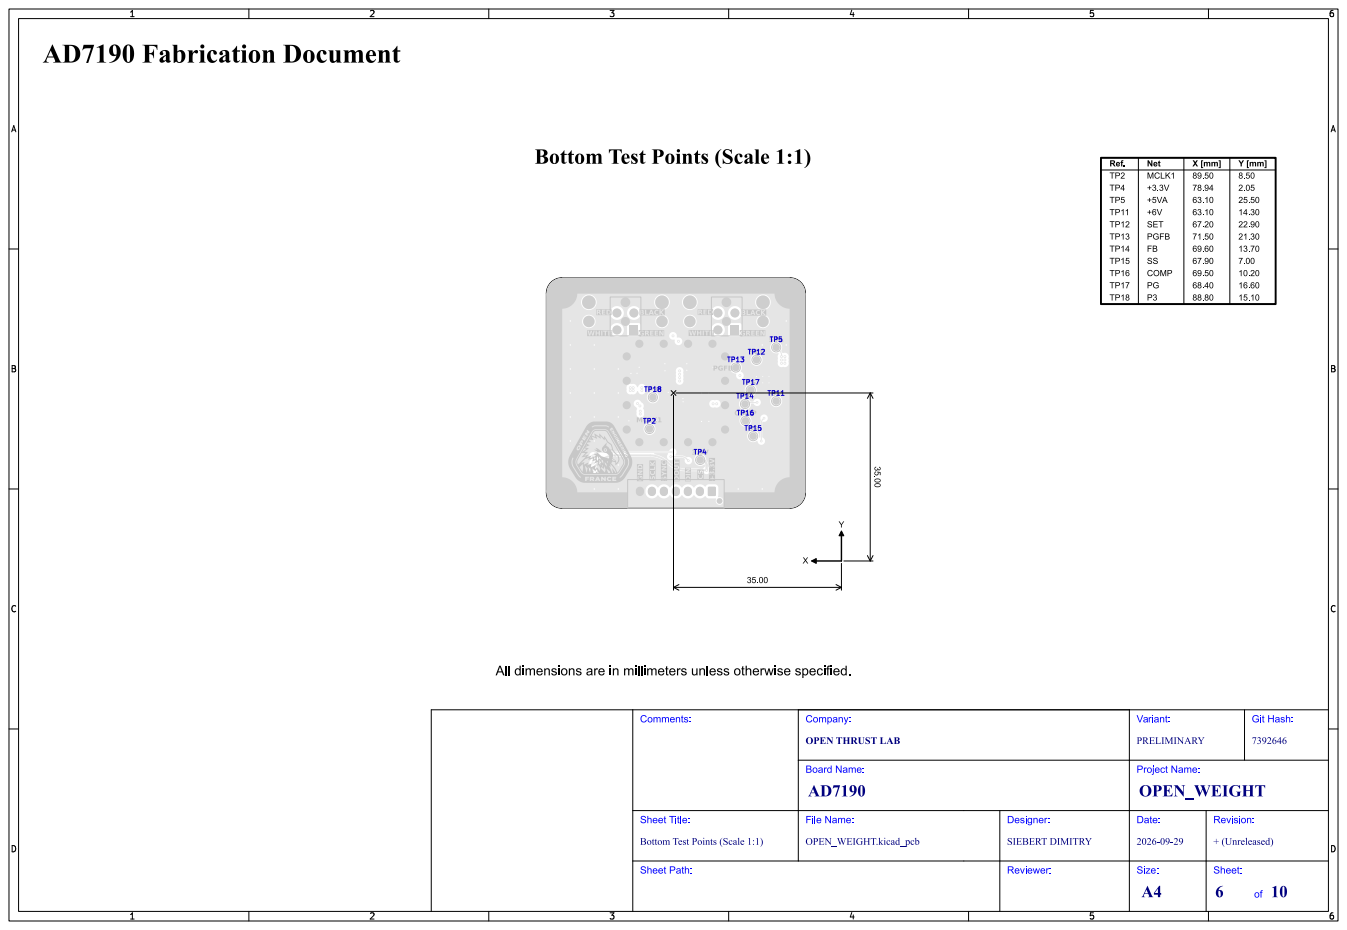
[picture p30: page 6]

Bottom Test Points (Scale 1:1)

# L1 (Sig) (Scale 1:1)

# AD7190 Fabrication Document

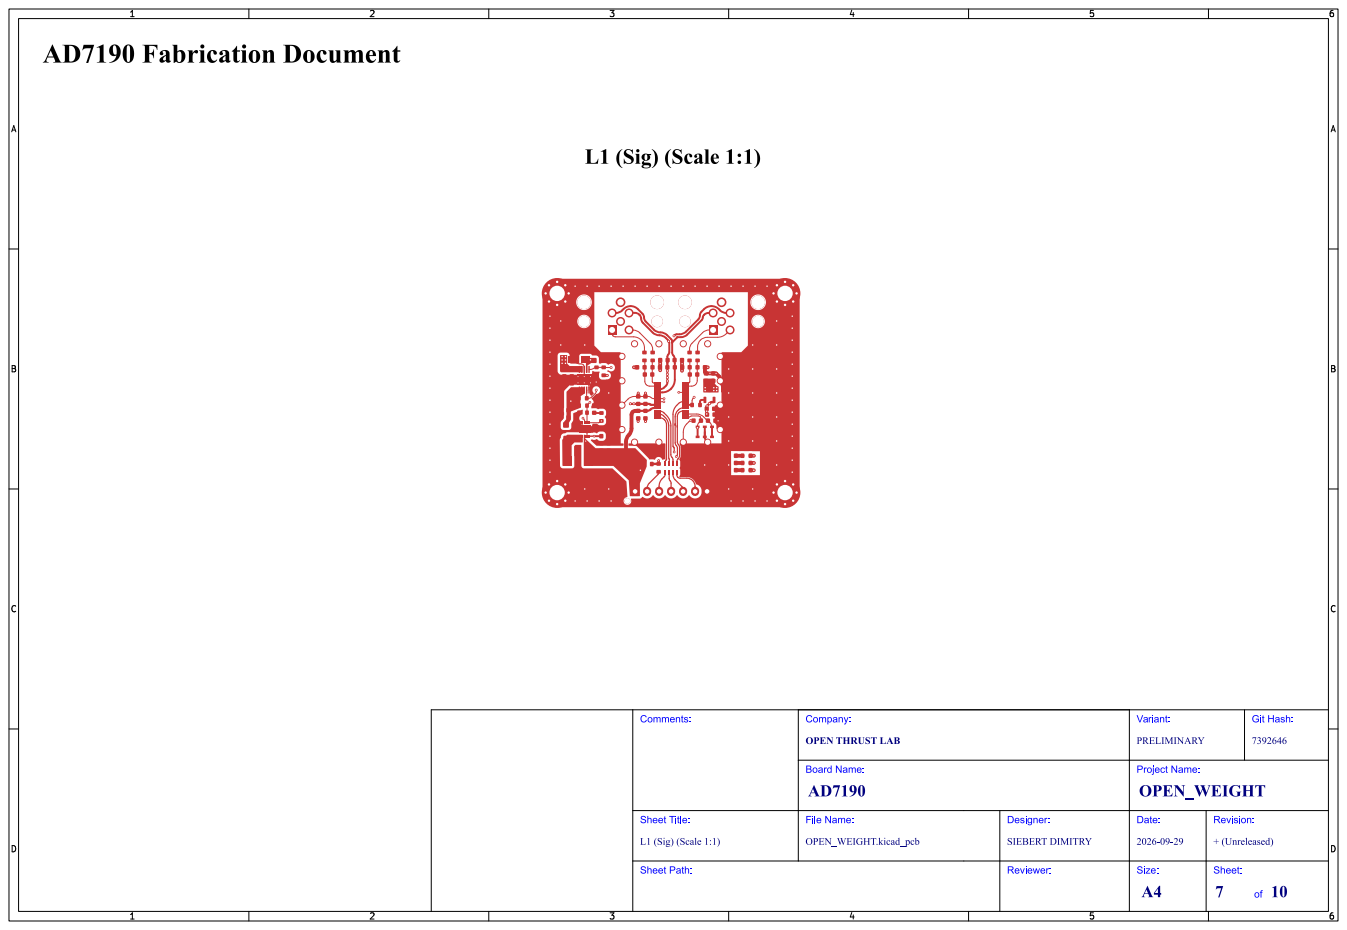
[picture p31: page 7]
Git; Hash:; Comments:; L1 (Sig) (Scale 1:1); Sheet Path:; Sheet Title:; File Name:; OPEN_WEIGHT; Company:; PRELIMINARY; Variant:; Board Name:; OPEN_WEIGHT.kicad_pcb; SIEBERT DIMITRY; Designer:; Reviewer:; Project Name:; Date:; + (Unreleased); Revision:; Size:; Sheet:

OPEN THRUST LAB

# L2(GND) (Scale 1:1)

# AD7190 Fabrication Document

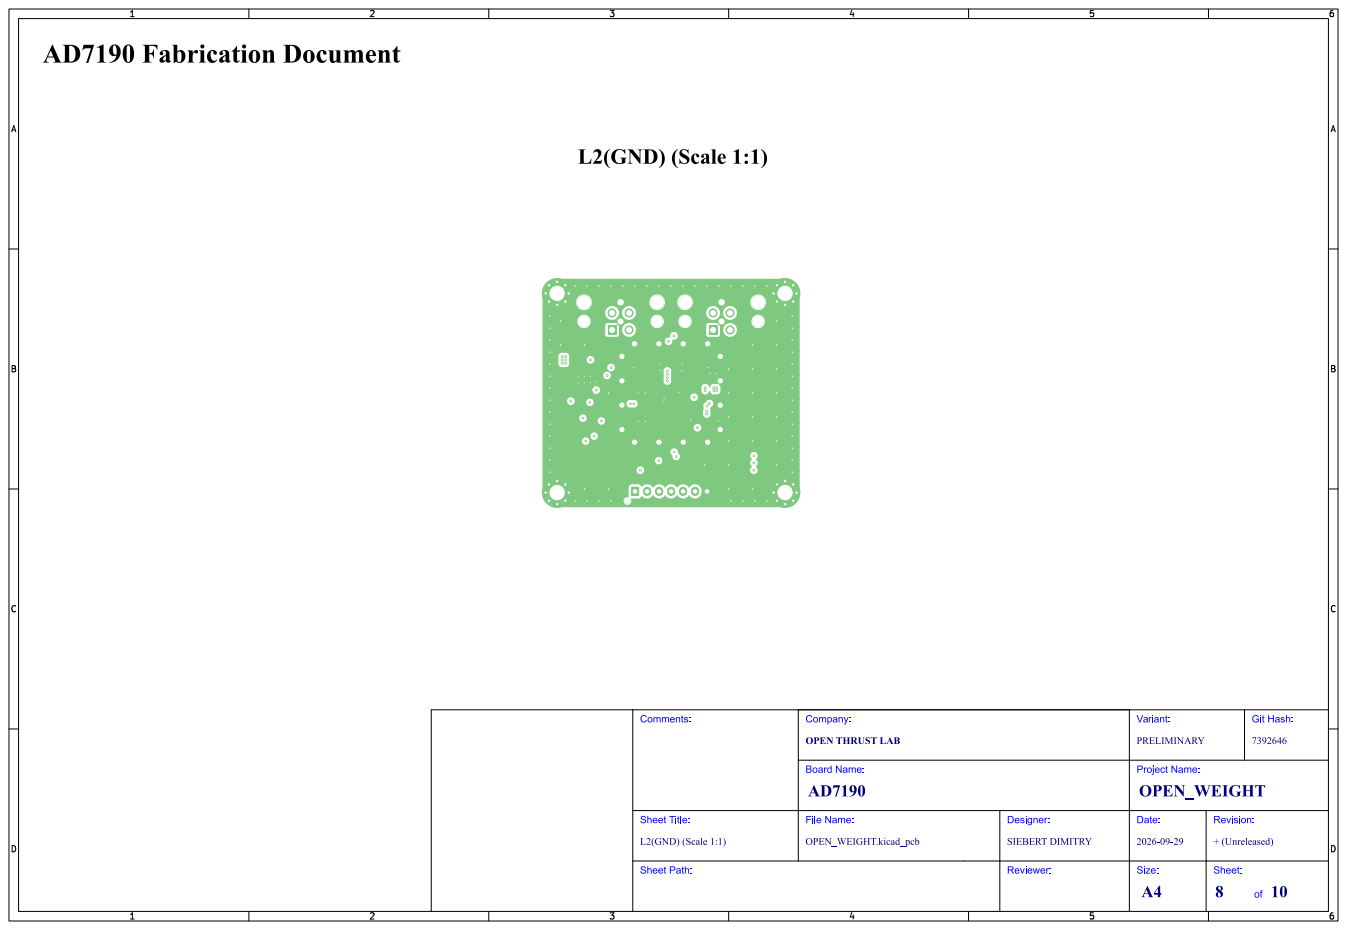
[picture p32: page 8]
Git; Hash:; Comments:; L2(GND) (Scale 1:1); Sheet Path:; Sheet Title:; File Name:; OPEN_WEIGHT; Company:; PRELIMINARY; Variant:; Board Name:; OPEN_WEIGHT.kicad_pcb; SIEBERT DIMITRY; Designer:; Reviewer:; Project Name:; Date:; + (Unreleased); Revision:; Size:; Sheet:

OPEN THRUST LAB

# L3(POWER,+5VA) (Scale 1:1)

# AD7190 Fabrication Document

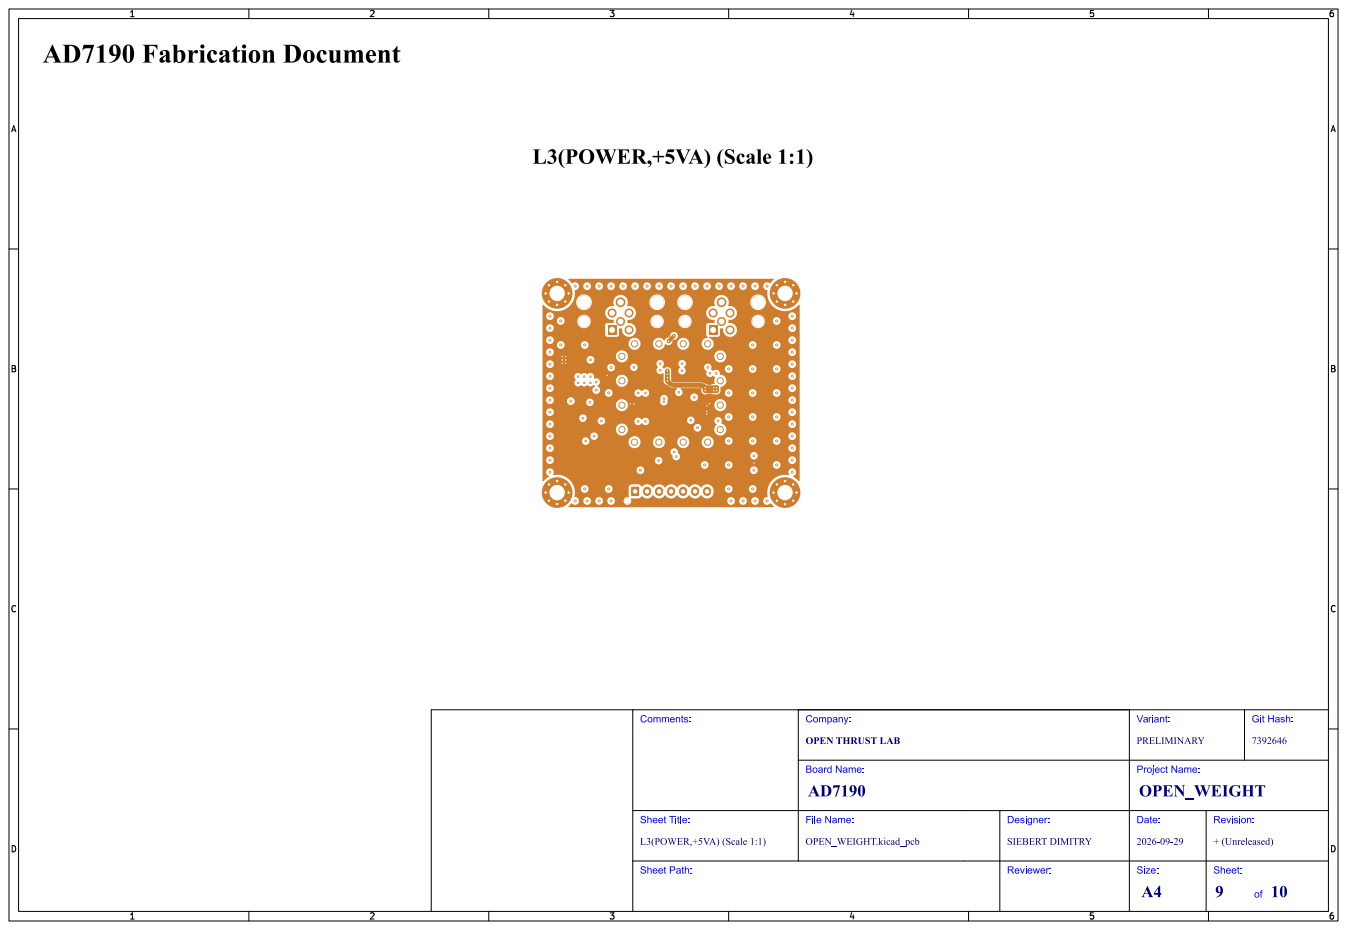
[picture p33: page 9]
Git; Hash:; Comments:; L3(POWER,+5VA) (Scale 1:1); Sheet Path:; Sheet Title:; File Name:; OPEN_WEIGHT; Company:; PRELIMINARY; Variant:; Board Name:; OPEN_WEIGHT.kicad_pcb; SIEBERT DIMITRY; Designer:; Reviewer:; Project Name:; Date:; + (Unreleased); Revision:; Size:; Sheet:

OPEN THRUST LAB

# L4(Sig, GND) (Scale 1:1)

# AD7190 Fabrication Document

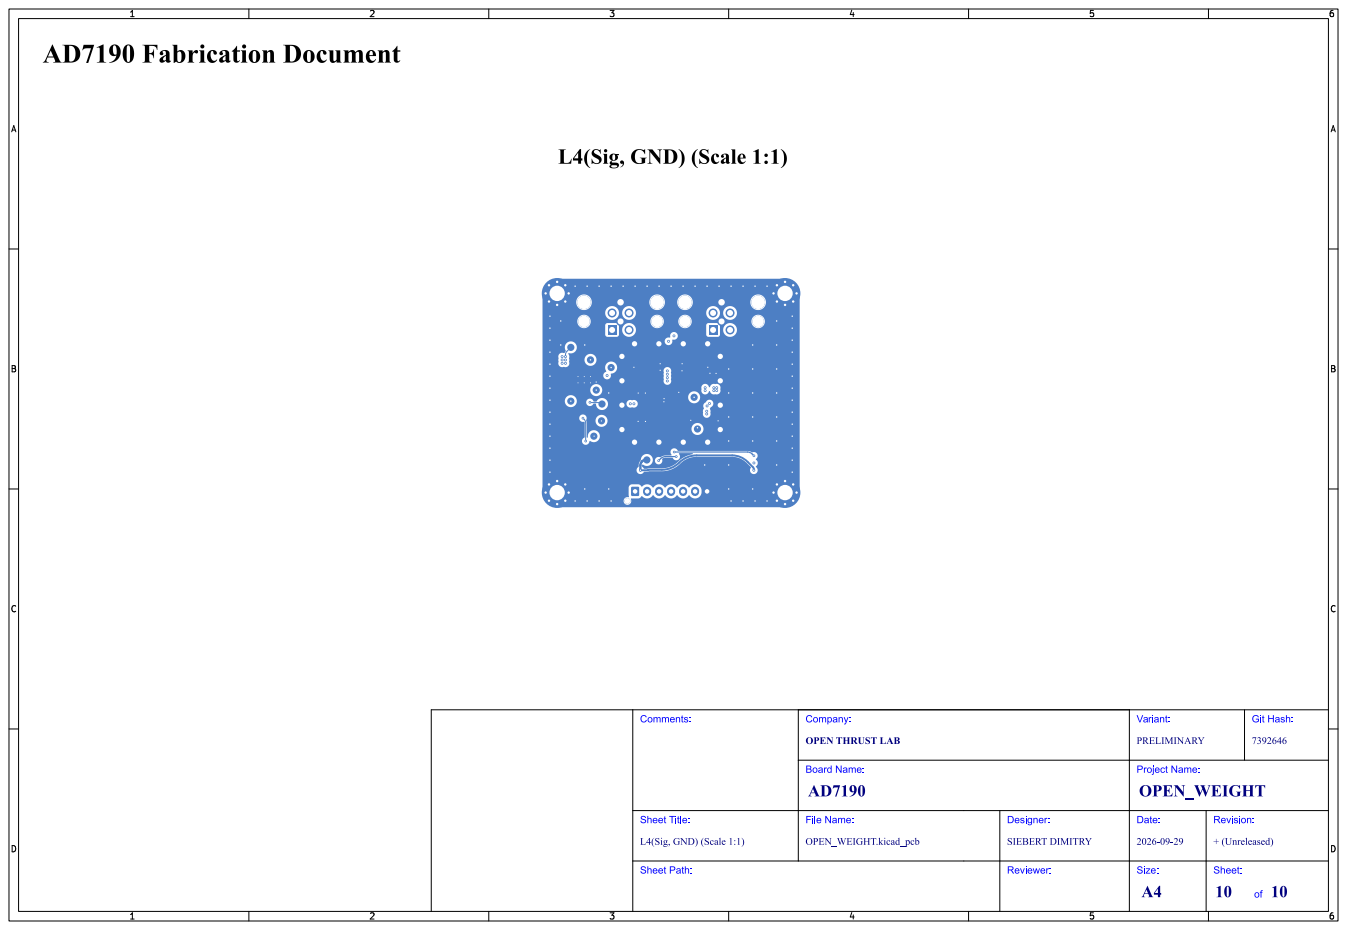
[picture p34: page 10]
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

OPEN THRUST LAB

L4(Sig, GND) (Scale 1:1)
