foukouda/OPEN_WEIGHT/HTML/images/cat_pdf_fabrication_OPEN_WEIGHT-fabrication.png

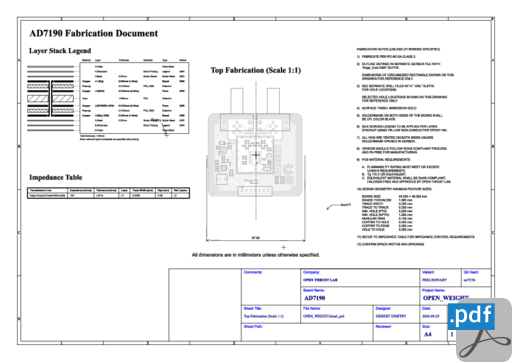
HTML/images/cat_pdf_fabrication_OPEN_WEIGHT-fabrication.png
