foukouda/OPEN_WEIGHT/Simulation/openEMS/results.md

# openEMS results (generated by measurement_quality.py)

Worst-case voltage left by the boost stage between the two pins of each AD7190 input, in nV rms, with nothing credited to the digital filter (assumptions at the top of measurement_quality.py).

Yardstick: the AD7190 itself has 8.5 nV rms of noise at its quietest setting (4.7 Hz, gain 128). A 2 mV/V load cell under 5 V gives 10 mV at full load, so 1 nV is 0.1 ppm of full scale.

The stray field of L1 is kept apart: the part is shielded and what it leaks is not published, so it only has an upper bound, all of its stored energy taken as stray field. The bound goes with the square root of the share that really leaks.

## CH1 (J4, AIN1/AIN2)

| At the switching frequency alone (1.2 MHz) | Bare board | Shield H5 with its cover |
| --- | --- | --- |
| Switch node voltage | 0.037 | 0.0041 |
| Boost current loops | 3.7 | 15 |
| Voltage and loops together | 3.8 | 15 |
| Voltage and loops together, times the noise of the AD7190 | 0.45 | 1.8 |
| Inductor stray field, upper bound | 8.8e+02 | 18 |
| The same if 1 % of the energy of L1 is stray field | 88 | 1.8 |

| Every harmonic up to 250 MHz together: a ceiling | Bare board | Shield H5 with its cover |
| --- | --- | --- |
| Switch node voltage | 0.13 | 0.015 |
| Boost current loops | 1.4e+02 | 26 |
| Voltage and loops together | 1.4e+02 | 26 |
| Voltage and loops together, times the noise of the AD7190 | 16 | 3.1 |
| Inductor stray field, upper bound | 1.5e+03 | 28 |
| The same if 1 % of the energy of L1 is stray field | 1.5e+02 | 2.8 |

Voltage and loops together, largest single harmonic: 36 nV rms at 48.0 MHz (bare board), 15 nV rms at 1.2 MHz (shield h5 with its cover).

## CH2 (J2, AIN3/AIN4)

| At the switching frequency alone (1.2 MHz) | Bare board | Shield H5 with its cover |
| --- | --- | --- |
| Switch node voltage | 0.21 | 0.063 |
| Boost current loops | 38 | 15 |
| Voltage and loops together | 38 | 15 |
| Voltage and loops together, times the noise of the AD7190 | 4.4 | 1.7 |
| Inductor stray field, upper bound | 2.7e+03 | 2.2e+02 |
| The same if 1 % of the energy of L1 is stray field | 2.7e+02 | 22 |

| Every harmonic up to 250 MHz together: a ceiling | Bare board | Shield H5 with its cover |
| --- | --- | --- |
| Switch node voltage | 0.83 | 0.27 |
| Boost current loops | 7.3e+02 | 72 |
| Voltage and loops together | 7.3e+02 | 72 |
| Voltage and loops together, times the noise of the AD7190 | 86 | 8.5 |
| Inductor stray field, upper bound | 4.7e+03 | 3.6e+02 |
| The same if 1 % of the energy of L1 is stray field | 4.7e+02 | 36 |

Voltage and loops together, largest single harmonic: 1.9e+02 nV rms at 48.0 MHz (bare board), 18 nV rms at 48.0 MHz (shield h5 with its cover).

## Reference input (REFIN1, the bridge excitation)

The reading is a ratio to this voltage: 1 nV on 5 V moves it by 0.2 ppb.

| At the switching frequency alone (1.2 MHz) | Bare board | Shield H5 with its cover |
| --- | --- | --- |
| Switch node voltage | 0.93 | 0.27 |
| Boost current loops | 94 | 28 |
| Voltage and loops together | 95 | 29 |
| Inductor stray field, upper bound | 5.5e+03 | 2.8e+02 |
| The same if 1 % of the energy of L1 is stray field | 5.5e+02 | 28 |

| Every harmonic up to 250 MHz together: a ceiling | Bare board | Shield H5 with its cover |
| --- | --- | --- |
| Switch node voltage | 3.7 | 1.1 |
| Boost current loops | 5.1e+02 | 57 |
| Voltage and loops together | 5.1e+02 | 58 |
| Inductor stray field, upper bound | 8.6e+03 | 4.4e+02 |
| The same if 1 % of the energy of L1 is stray field | 8.6e+02 | 44 |

Voltage and loops together, largest single harmonic: 95 nV rms at 1.2 MHz (bare board), 29 nV rms at 1.2 MHz (shield h5 with its cover).

## Couplings found by the field solver

Per input and per place (connector tracks, loop of the two filter capacitors to ground, pins): difference between the two legs, then their common part where both legs were probed. "<" marks a coupling lost in the solver noise, given as an upper bound.

**Mutual capacitance to the switch node (fF)**

| Nets | Bare board | Shield H5 with its cover |
| --- | --- | --- |
| CH1 connector (IN-OUT+ / IN-OUT-), difference | 0.0016 | 0.00035 |
| CH1 connector (IN-OUT+ / IN-OUT-), common | 0.0067 | < 0.0017 |
| CH1 pin (OUT+ / OUT-), difference | 0.00026 | < 2.6e-06 |
| CH1 pin (OUT+ / OUT-), common | 0.0097 | < 3e-06 |
| CH2 connector (IN-OUT-2 / IN-OUT+2), difference | 0.011 | 0.0086 |
| CH2 connector (IN-OUT-2 / IN-OUT+2), common | 0.026 | 0.011 |
| CH2 pin (OUT+2 / OUT-2), difference | 0.0077 | < 2e-05 |
| CH2 pin (OUT+2 / OUT-2), common | 0.024 | < 1.3e-05 |
| REF pin (SENSE+ / SENSE-), difference | < 0.0087 | 0.0051 |
| REF pin (SENSE+ / SENSE-), common | 0.061 | 0.016 |

**Mutual inductance to the commutation loop IC2 - D3 - C19/C20 (pH)**

| Nets | Bare board | Shield H5 with its cover |
| --- | --- | --- |
| CH1 connector (IN-OUT+ / IN-OUT-), difference | 0.015 | 0.0071 |
| CH1 connector (IN-OUT+ / IN-OUT-), common | 0.011 | 0.0062 |
| CH1 pin (OUT+ / OUT-), difference | 0.0052 | < 3.1e-05 |
| CH1 filter (C27 / C29), difference | 0.051 | 0.001 |
| CH1 filter (C27 / C29), common | < 0.0012 | < 3.9e-05 |
| CH2 connector (IN-OUT-2 / IN-OUT+2), difference | 0.13 | 0.13 |
| CH2 connector (IN-OUT-2 / IN-OUT+2), common | 0.18 | 0.13 |
| CH2 pin (OUT+2 / OUT-2), difference | 0.031 | 0.0034 |
| CH2 filter (C10 / C8), difference | 0.26 | 0.022 |
| CH2 filter (C10 / C8), common | < 0.0007 | < 0.00029 |
| REF pin (SENSE+ / SENSE-), difference | 0.11 | 0.0067 |
| REF pin (SENSE+ / SENSE-), common | 0.11 | 0.0059 |

**Mutual inductance to the input loop C21/C22 - L1 - IC2 (pH)**

| Nets | Bare board | Shield H5 with its cover |
| --- | --- | --- |
| CH1 connector (IN-OUT+ / IN-OUT-), difference | 0.016 | 0.0064 |
| CH1 connector (IN-OUT+ / IN-OUT-), common | 0.019 | 0.0053 |
| CH1 pin (OUT+ / OUT-), difference | 0.0029 | 0.032 |
| CH1 filter (C27 / C29), difference | 0.031 | 0.12 |
| CH1 filter (C27 / C29), common | < 0.006 | < 0.00037 |
| CH2 connector (IN-OUT-2 / IN-OUT+2), difference | 0.15 | 0.17 |
| CH2 connector (IN-OUT-2 / IN-OUT+2), common | 0.22 | 0.15 |
| CH2 pin (OUT+2 / OUT-2), difference | 0.046 | 0.029 |
| CH2 filter (C10 / C8), difference | 0.39 | 0.089 |
| CH2 filter (C10 / C8), common | < 0.017 | < 0.00083 |
| REF pin (SENSE+ / SENSE-), difference | 0.16 | 0.066 |
| REF pin (SENSE+ / SENSE-), common | 0.14 | 0.22 |

**Mutual inductance to a loop of the size of L1, at its place (pH)**

| Nets | Bare board | Shield H5 with its cover |
| --- | --- | --- |
| CH1 connector (IN-OUT+ / IN-OUT-), difference | 0.02 | 0.008 |
| CH1 connector (IN-OUT+ / IN-OUT-), common | < 0.00079 | 0.0034 |
| CH1 pin (OUT+ / OUT-), difference | 0.024 | 0.00055 |
| CH1 filter (C27 / C29), difference | 0.14 | 0.00099 |
| CH1 filter (C27 / C29), common | < 0.00018 | < 4.7e-05 |
| CH2 connector (IN-OUT-2 / IN-OUT+2), difference | 0.1 | 0.084 |
| CH2 connector (IN-OUT-2 / IN-OUT+2), common | 0.15 | 0.091 |
| CH2 pin (OUT+2 / OUT-2), difference | 0.071 | 0.006 |
| CH2 filter (C10 / C8), difference | 0.42 | 0.026 |
| CH2 filter (C10 / C8), common | < 0.0019 | < 0.00025 |
| REF pin (SENSE+ / SENSE-), difference | 0.19 | 0.0097 |
| REF pin (SENSE+ / SENSE-), common | 0.063 | 0.0083 |

The loop driven for L1 has 35.9 mm2. L1 is given at most 2.6 mA.m2 of dipole moment per ampere, 73 times that loop.

## Boost stage, from LTspice 03 (bridge powered)

| Harmonic | V(SW) | Diode branch current | I(L1) |
| --- | --- | --- | --- |
| 1 (1.2 MHz) | 2.67 V | 47.8 mA | 75.4 mA |
| 2 (2.4 MHz) | 1.81 V | 34.3 mA | 25.5 mA |
| 3 (3.6 MHz) | 0.172 V | 19.1 mA | 1.62 mA |
| 5 (6.0 MHz) | 0.848 V | 11.9 mA | 4.79 mA |
| 10 (12.0 MHz) | 1.07 V | 2.63 mA | 2.97 mA |
| 20 (24.0 MHz) | 0.206 V | 3.04 mA | 0.282 mA |
| 50 (60.0 MHz) | 0.0577 V | 1.11 mA | 0.0327 mA |
| 100 (120.0 MHz) | 0.0353 V | 0.52 mA | 0.00994 mA |
| 200 (240.0 MHz) | 0.00293 V | 0.272 mA | 0.0018 mA |

Amplitudes.

## Mesh sensitivity, bare board

Same chain with another step of the fine mesh, for the drives simulated again: nV rms at 1.2 MHz alone / every harmonic.

| Input, mechanism | 0.2 mm | 0.15 mm |
| --- | --- | --- |
| CH1, commutation loop | 2 / 1.3e+02 | 1.9 / 1.3e+02 |
| CH2, commutation loop | 11 / 7e+02 | 14 / 7.6e+02 |
| REF, commutation loop | 28 / 4.6e+02 | 30 / 4.9e+02 |
