foukouda/OPEN_WEIGHT/Schematic/OPEN_WEIGHT-schematic-1.pdf

# Rev + (Unreleased)

# Variant:

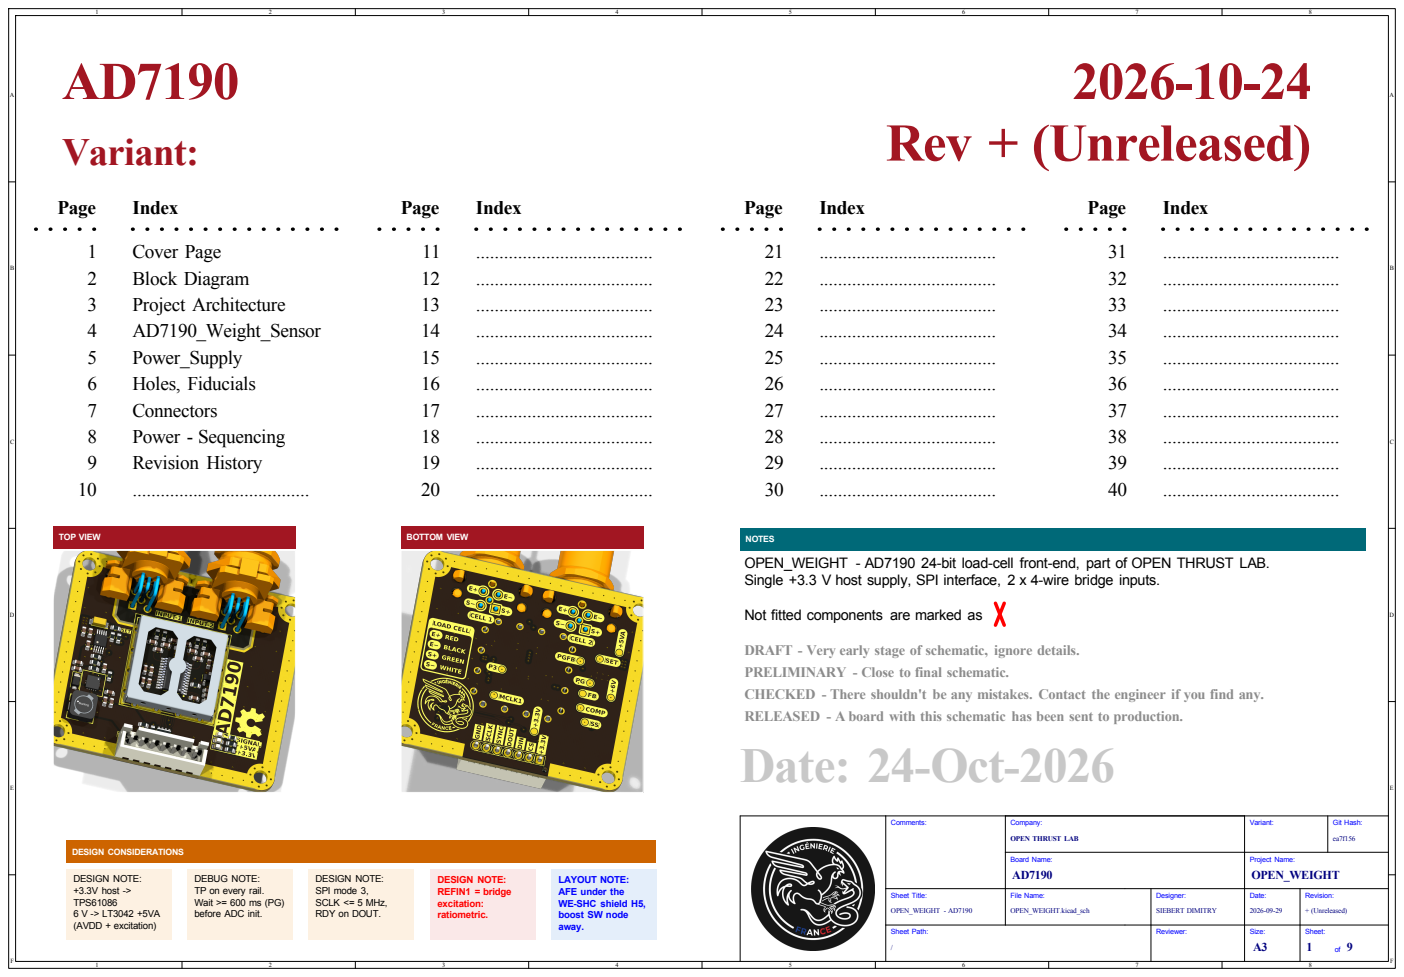
[picture p36: page 1]
Sheet: of 9; Size: A3; OPEN_WEIGHT.kicad_sch; SIEBERT DIMITRY; Board Name: Company:; Variant: OPEN THRUST LAB AD7190; OPEN_WEIGHT; Sheet Title:; File Name:; /Sheet Path: OPEN_WEIGHT - AD7190 Comments:; Git Hash: ea7f156 Block Diagram; kibot_image_png_3d_viewer_angled_topTOP VIEW; DESIGN CONSIDERATIONS; DESIGN NOTE: +3.3V host -> TPS61086; 6 V -> LT3042 +5VA (AVDD + excitation); BOTTOM VIEW; DESIGN NOTE: REFIN1 = bridge excitation: ratiometric.; kibot_image_png_3d_viewer_angled_bottom; Page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

NOTES
OPEN_WEIGHT - AD7190 24-bit load-cell front-end, part of OPEN THRUST LAB.
Single +3.3 V host supply, SPI interface, 2 x 4-wire bridge inputs.

Not fitted components are marked as

PRELIMINARY - Close to final schematic.
CHECKED - There shouldn't be any mistakes. Contact the engineer if you find any.
RELEASED - A board with this schematic has been sent to production.
Date: 24-Oct-2026

Revision: + (Unreleased) Date: Project Name: 2026-09-29 Reviewer: Designer:

DEBUG NOTE:
TP on every rail.
Wait >= 600 ms (PG)
before ADC init.

DESIGN NOTE:
SPI mode 3,
SCLK <= 5 MHz,
RDY on DOUT.

LAYOUT NOTE:
AFE under the
WE-SHC shield H5,
boost SW node
away.
