foukouda/OPEN_WEIGHT/Schematic/OPEN_WEIGHT-schematic-2.pdf

# [2] Block Diagram

## TPS61086 BOOST

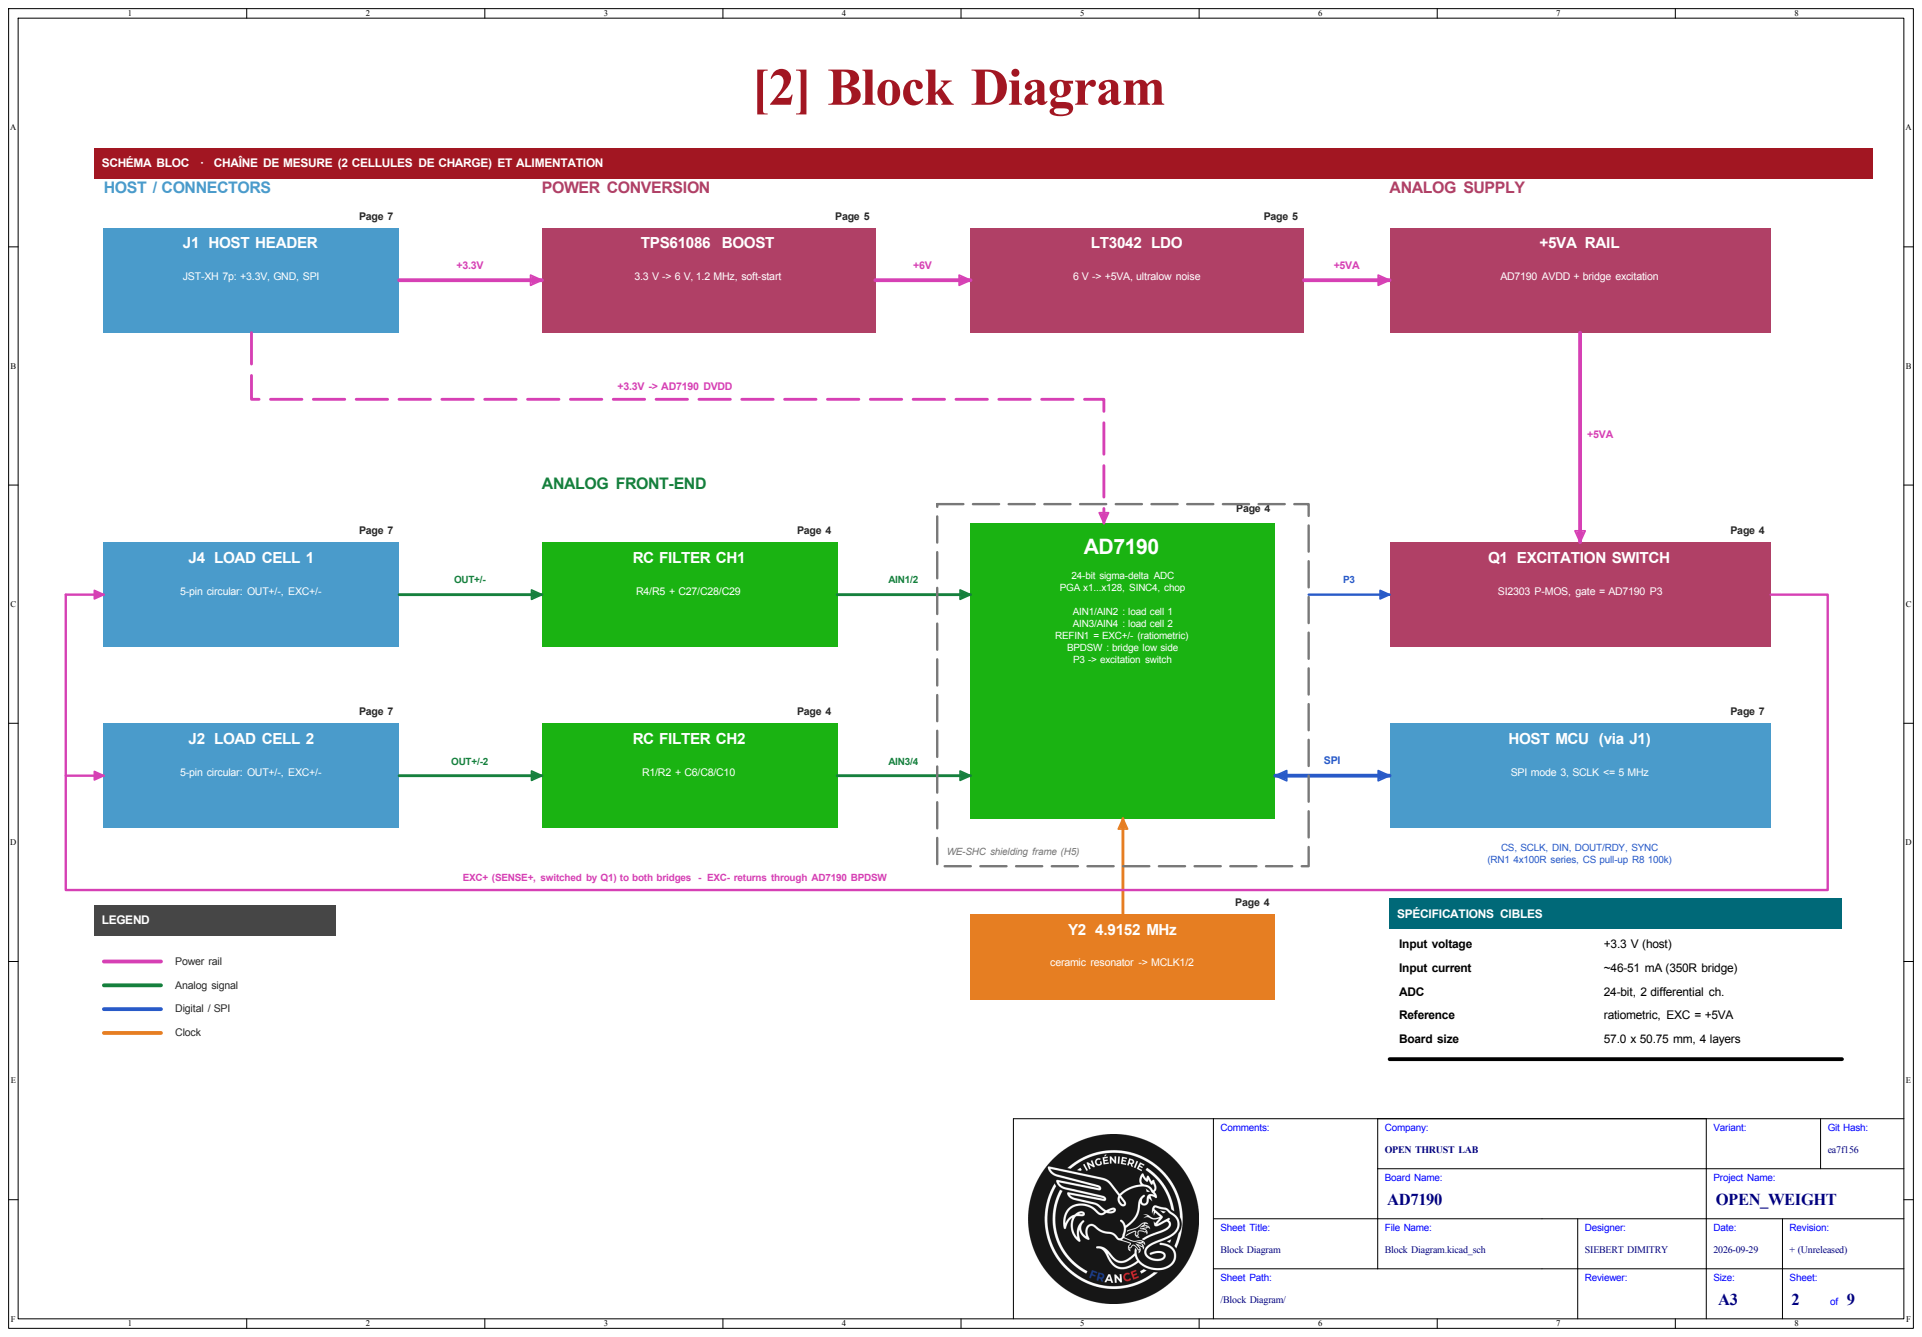
[picture p37: page 1]
Sheet: of 9; Size: A3; Revision: + (Unreleased) Date: Project Name: 2026-09-29 Reviewer: Designer: Block Diagram.kicad_sch; SIEBERT DIMITRY; Board Name: Company:; Variant: OPEN THRUST LAB AD7190; OPEN_WEIGHT; Sheet Title:; File Name:; Comments:; Git Hash: ea7f156 SPÉCIFICATIONS CIBLES LEGEND; Page 5; LT3042 LDO; 6 V -> +5VA, ultralow noise; J4 LOAD CELL 1; J2 LOAD CELL 2; OUT+/-2; ANALOG SUPPLY; +5VA RAIL; Page 7; SPI; Page 4; RC FILTER CH2; J1 HOST HEADER; POWER CONVERSION; RC FILTER CH1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

SCHÉMA BLOC · CHAÎNE DE MESURE (2 CELLULES DE CHARGE) ET ALIMENTATION
HOST / CONNECTORS

JST-XH 7p: +3.3V, GND, SPI

3.3 V -> 6 V, 1.2 MHz, soft-start

AD7190 AVDD + bridge excitation

ANALOG FRONT-END

Page 4 EXC+ (SENSE+, switched by Q1) to both bridges - EXC- returns through AD7190 BPDSW

PGA x1...x128, SINC4, chop AIN1/AIN2 : load cell 1 AIN3/AIN4 : load cell 2 REFIN1 = EXC+/- (ratiometric) BPDSW : bridge low side P3 -> excitation switch AD7190

24-bit sigma-delta ADC

5-pin circular: OUT+/-, EXC+/-

HOST MCU (via J1)

SPI mode 3, SCLK <= 5 MHz

CS, SCLK, DIN, DOUT/RDY, SYNC
(RN1 4x100R series, CS pull-up R8 100k)

+3.3 V (host)
~46-51 mA (350R bridge)
24-bit, 2 differential ch.
ratiometric, EXC = +5VA
57.0 x 50.75 mm, 4 layers

/Block Diagram/ Sheet Path: Block Diagram
