foukouda/OPEN_WEIGHT/Schematic/OPEN_WEIGHT-schematic-3.pdf

# [3] Project Architecture

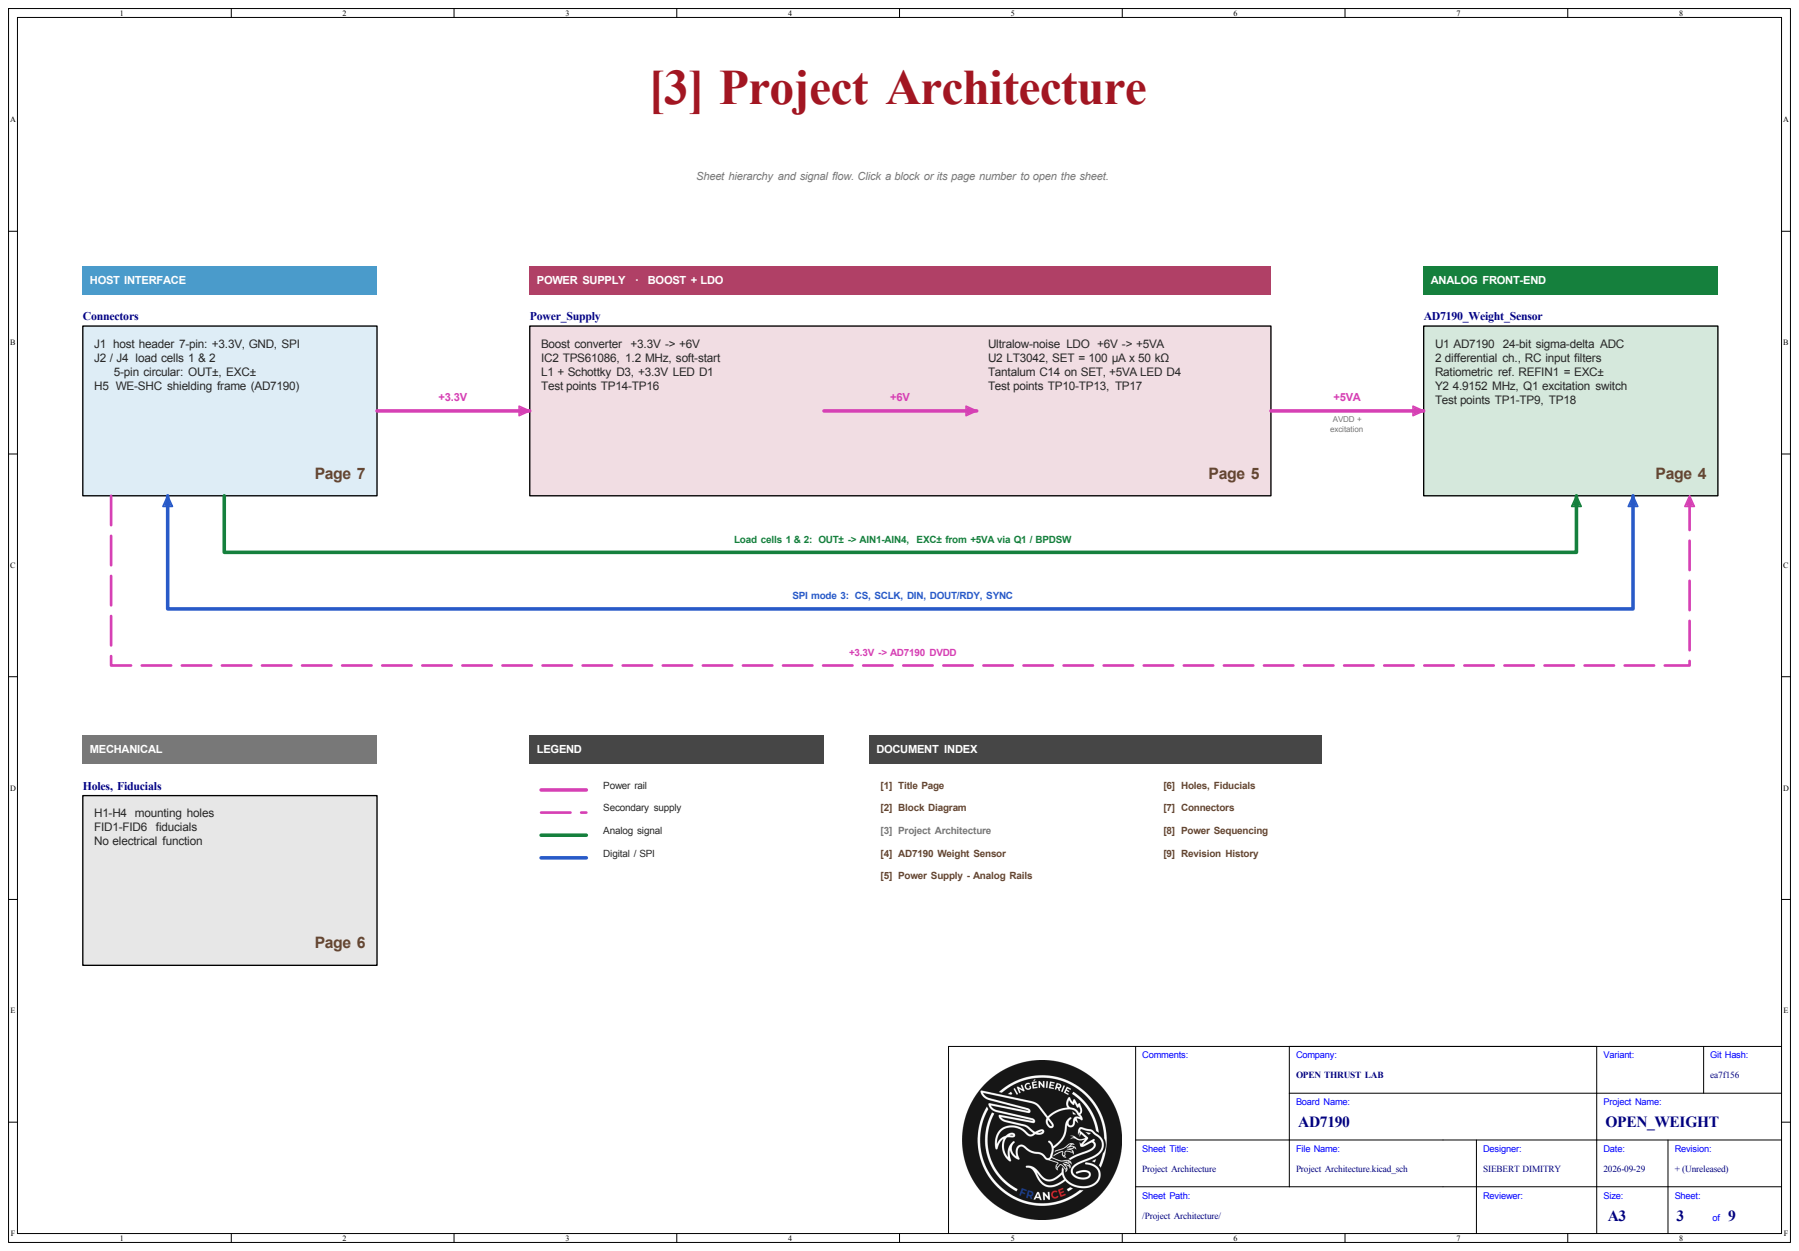
[picture p38: page 1]

Sheet hierarchy and signal flow. Click a block or its page number to open the sheet.

J1 host header 7-pin: +3.3V, GND, SPI
J2 / J4 load cells 1 & 2
5-pin circular: OUT±, EXC±
H5 WE-SHC shielding frame (AD7190)

excitation Ultralow-noise LDO +6V -> +5VA
U2 LT3042, SET = 100 µA x 50 kΩ
Tantalum C14 on SET, +5VA LED D4
Test points TP10-TP13, TP17

U1 AD7190 24-bit sigma-delta ADC
2 differential ch., RC input filters
Ratiometric ref. REFIN1 = EXC±
Y2 4.9152 MHz, Q1 excitation switch

Load cells 1 & 2: OUT± -> AIN1-AIN4, EXC± from +5VA via Q1 / BPDSW

SPI mode 3: CS, SCLK, DIN, DOUT/RDY, SYNC

[5] Power Supply - Analog Rails

Revision: + (Unreleased) Date: Project Name: 2026-09-29 Reviewer: Designer:
