foukouda/OPEN_WEIGHT/Manufacturing/Assembly/OPEN_WEIGHT-assembly-2.pdf

# Top Assembly (Scale 1:1)

# AD7190 Assembly Document

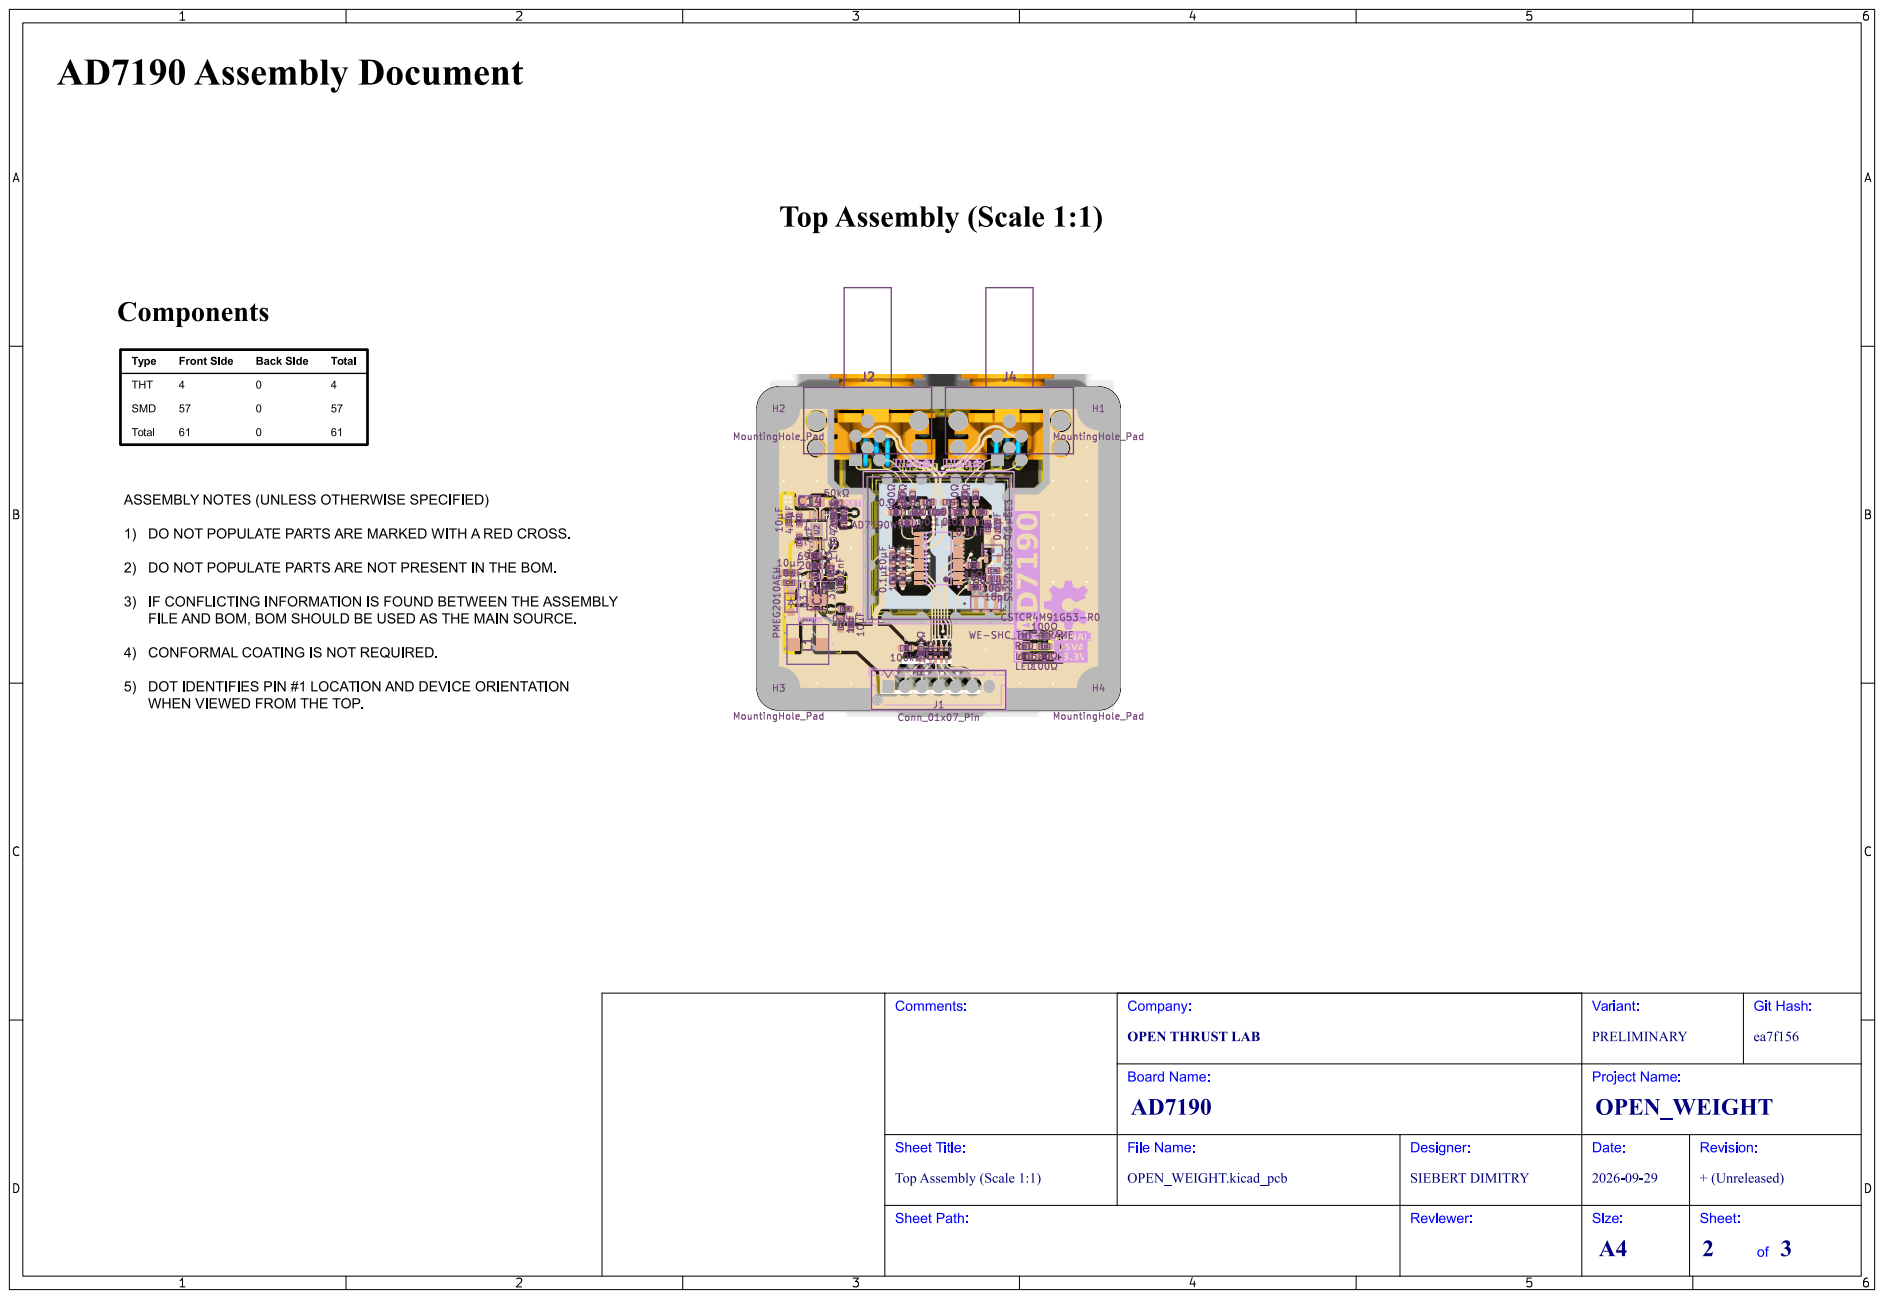
[picture p44: page 1]
