foukouda/OPEN_WEIGHT/Manufacturing/Assembly/OPEN_WEIGHT-assembly-3.pdf

# Bottom Assembly (Scale 1:1)

# AD7190 Assembly Document

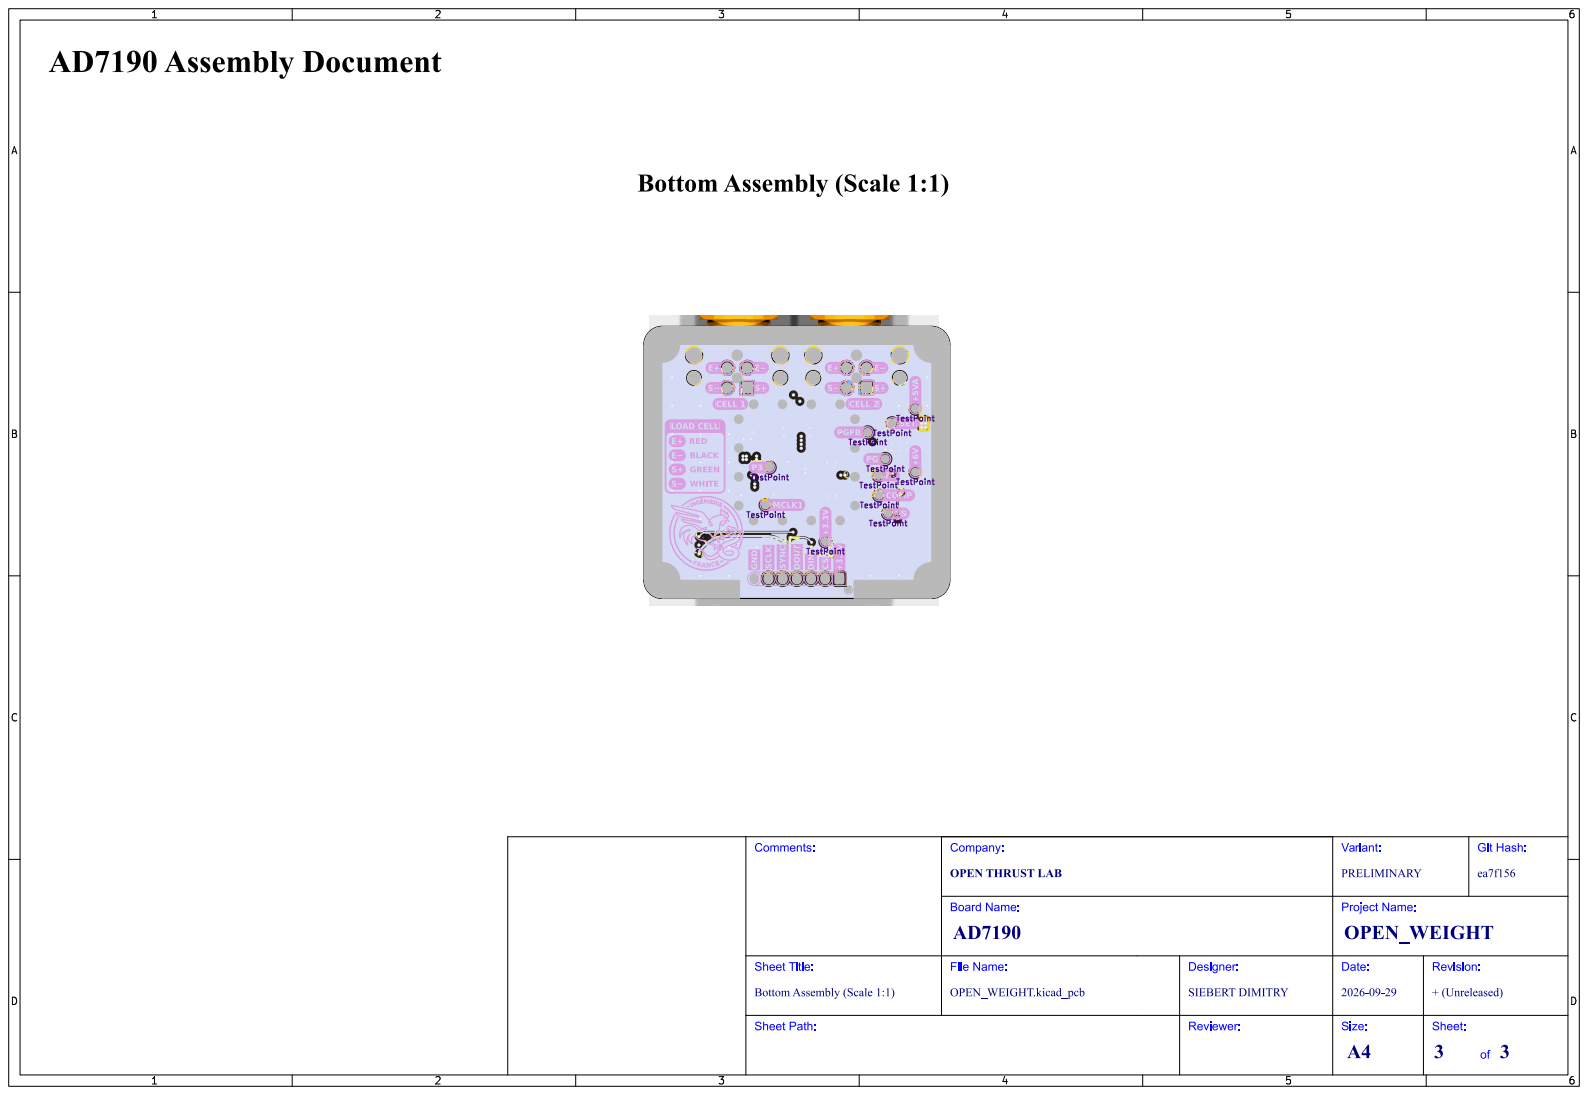
[picture p45: page 1]
Git; Hash:; Comments:; Sheet Path:; Sheet Title:; File Name:; OPEN_WEIGHT; Company:; PRELIMINARY; Variant:; Board Name:; OPEN_WEIGHT.kicad_pcb; SIEBERT DIMITRY; Designer:; Reviewer:; Project Name:; Date:; + (Unreleased); Revision:; Size:; Sheet: 3; TestPoint; TestPointTestPoint

OPEN THRUST LAB

Bottom Assembly (Scale 1:1)
