foukouda/OPEN_WEIGHT/Manufacturing/Assembly/OPEN_WEIGHT-assembly.pdf

# AD7190 Assembly Document

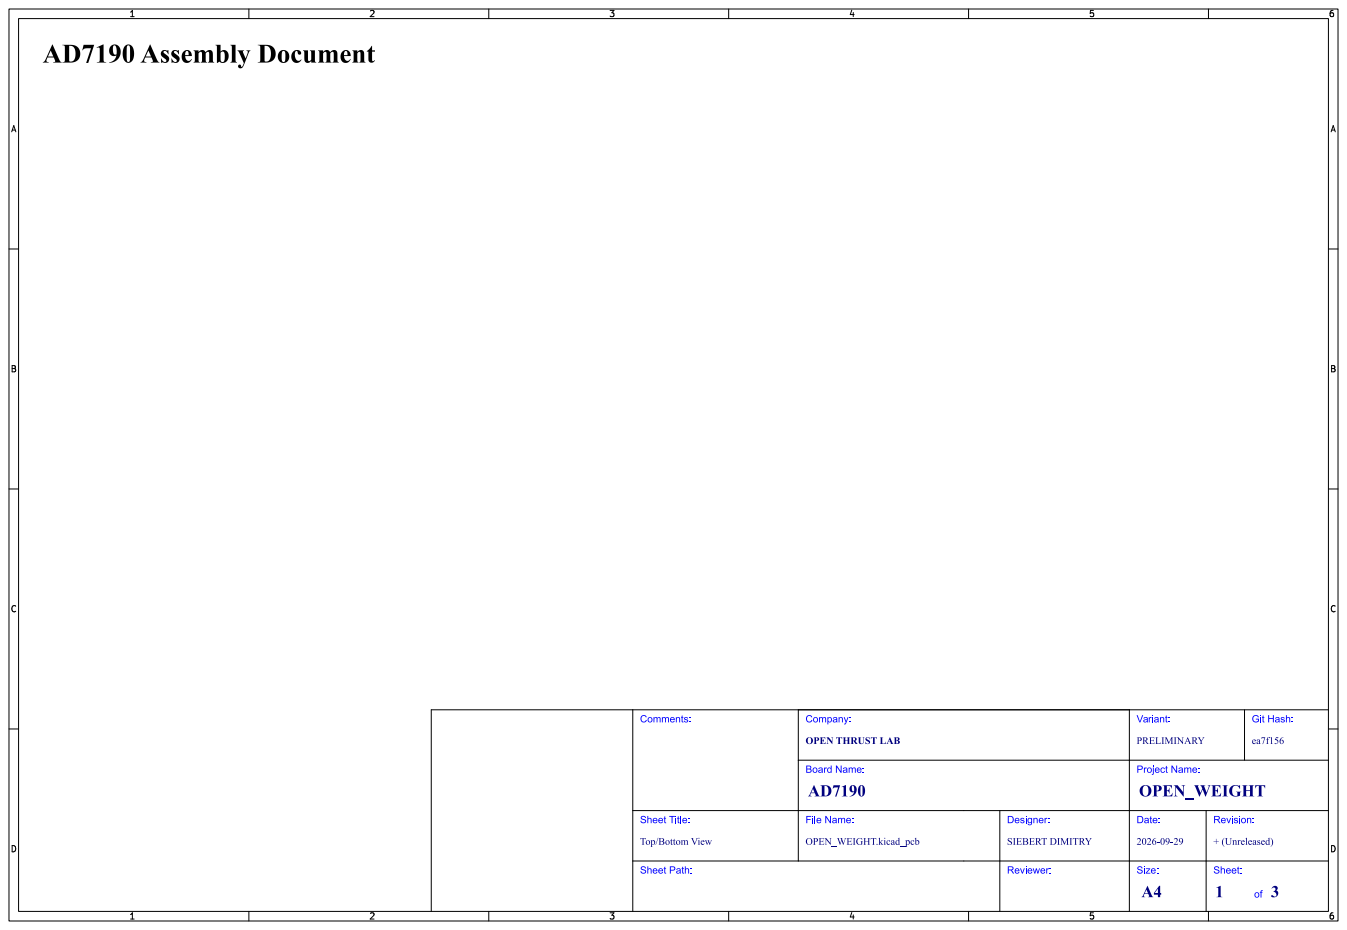
[picture p46: page 1]
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

OPEN THRUST LAB

Top/Bottom View

# Top Assembly (Scale 1:1)

# AD7190 Assembly Document


# Bottom Assembly (Scale 1:1)

# AD7190 Assembly Document

Git; Hash:; Comments:; Sheet Path:; Sheet Title:; File Name:; OPEN_WEIGHT; Company:; PRELIMINARY; Variant:; Board Name:; OPEN_WEIGHT.kicad_pcb; SIEBERT DIMITRY; Designer:; Reviewer:; Project Name:; Date:; + (Unreleased); Revision:; Size:; Sheet:; TestPoint; TestPointTestPoint

OPEN THRUST LAB

Bottom Assembly (Scale 1:1)
