foukouda/OPEN_WEIGHT/Manufacturing/Fabrication/OPEN_WEIGHT-fabrication-10.pdf

# L4(Sig, GND) (Scale 1:1)

# AD7190 Fabrication Document

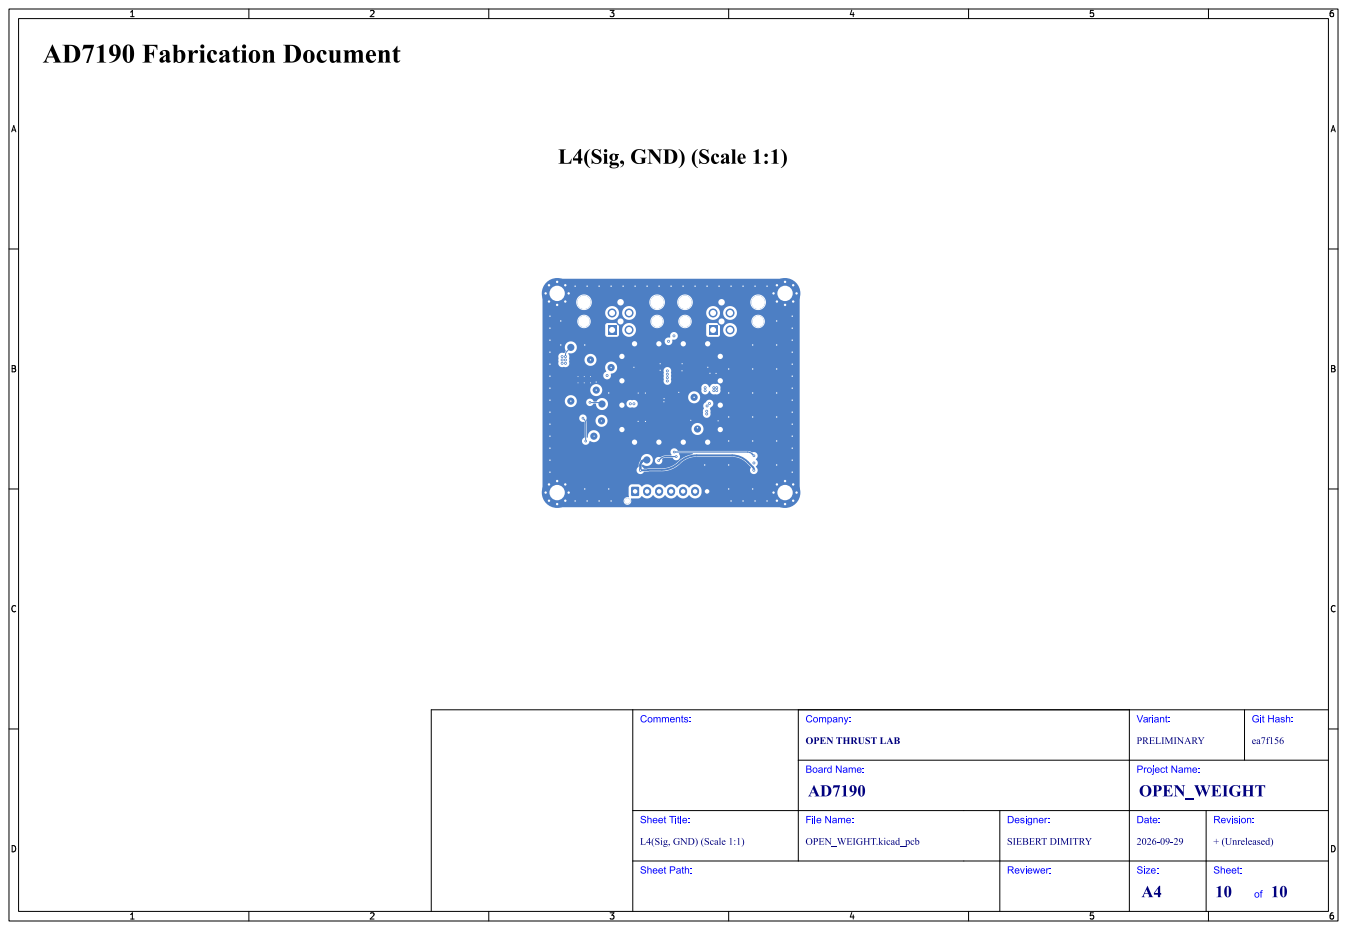
[picture p47: page 1]
Git; Hash:; Comments:; Sheet Path:; Sheet Title:; File Name:; OPEN_WEIGHT; Company:; PRELIMINARY; Variant:; Board Name:; OPEN_WEIGHT.kicad_pcb; SIEBERT DIMITRY; Designer:; Reviewer:; Project Name:; Date:; + (Unreleased); Revision:; Size:; Sheet: 10

OPEN THRUST LAB

L4(Sig, GND) (Scale 1:1)
