foukouda/OPEN_WEIGHT/Manufacturing/Fabrication/OPEN_WEIGHT-fabrication-2.pdf

# Bottom Fabrication (Scale 1:1)

# AD7190 Fabrication Document

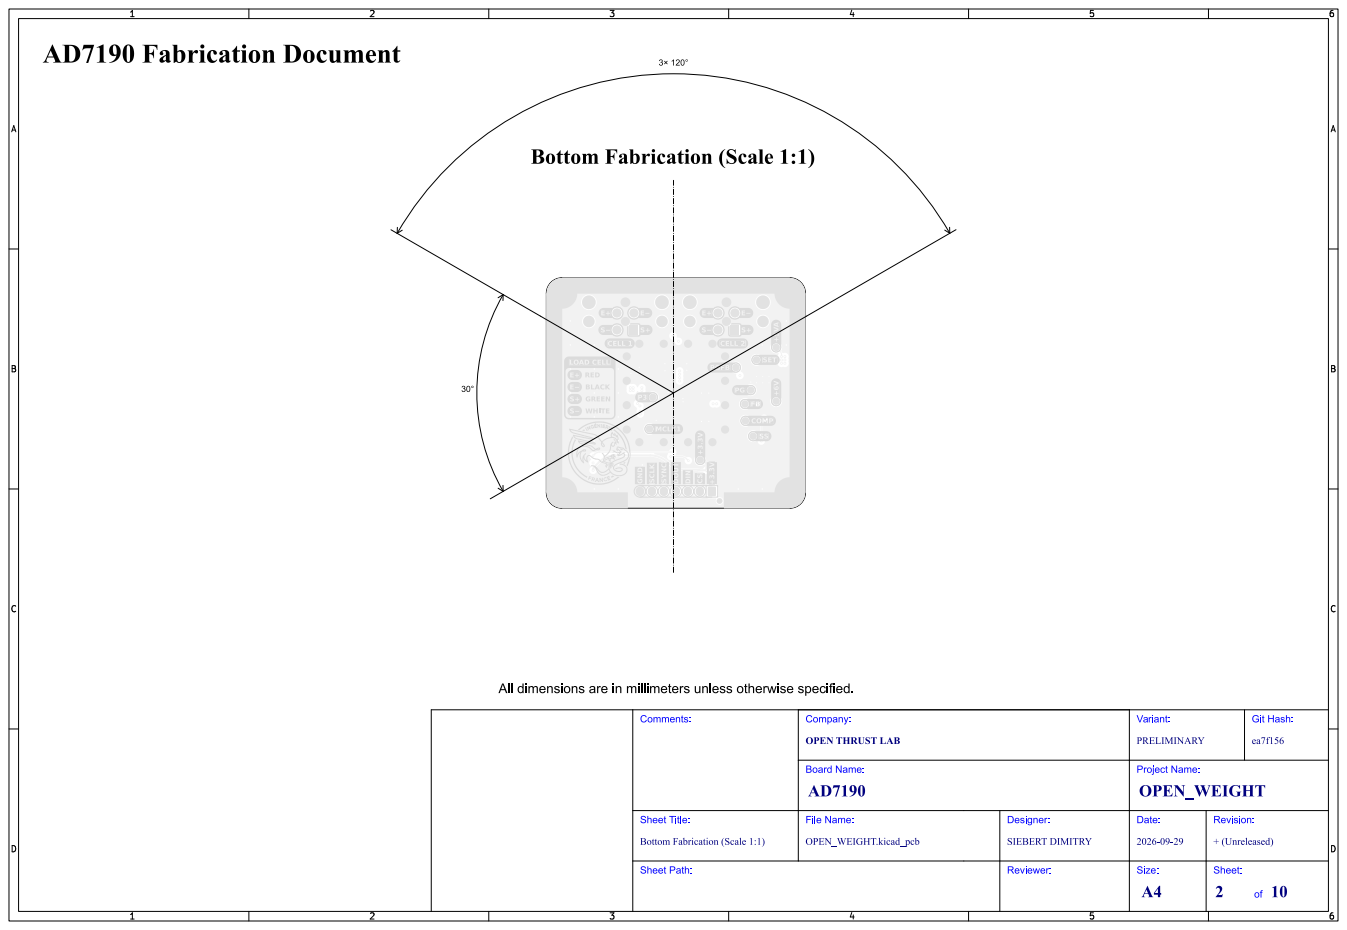
[picture p48: page 1]
Git; Hash:; Comments:; Sheet Path:; Sheet Title:; File Name:; OPEN_WEIGHT; Company:; PRELIMINARY; Variant:; Board Name:; OPEN_WEIGHT.kicad_pcb; SIEBERT DIMITRY; Designer:; Reviewer:; Project Name:; Date:; + (Unreleased); Revision:; Size:; Sheet: 2

OPEN THRUST LAB

Bottom Fabrication (Scale 1:1)
