foukouda/OPEN_WEIGHT/Manufacturing/Fabrication/OPEN_WEIGHT-fabrication-1.pdf

# Top Fabrication (Scale 1:1)

# AD7190 Fabrication Document

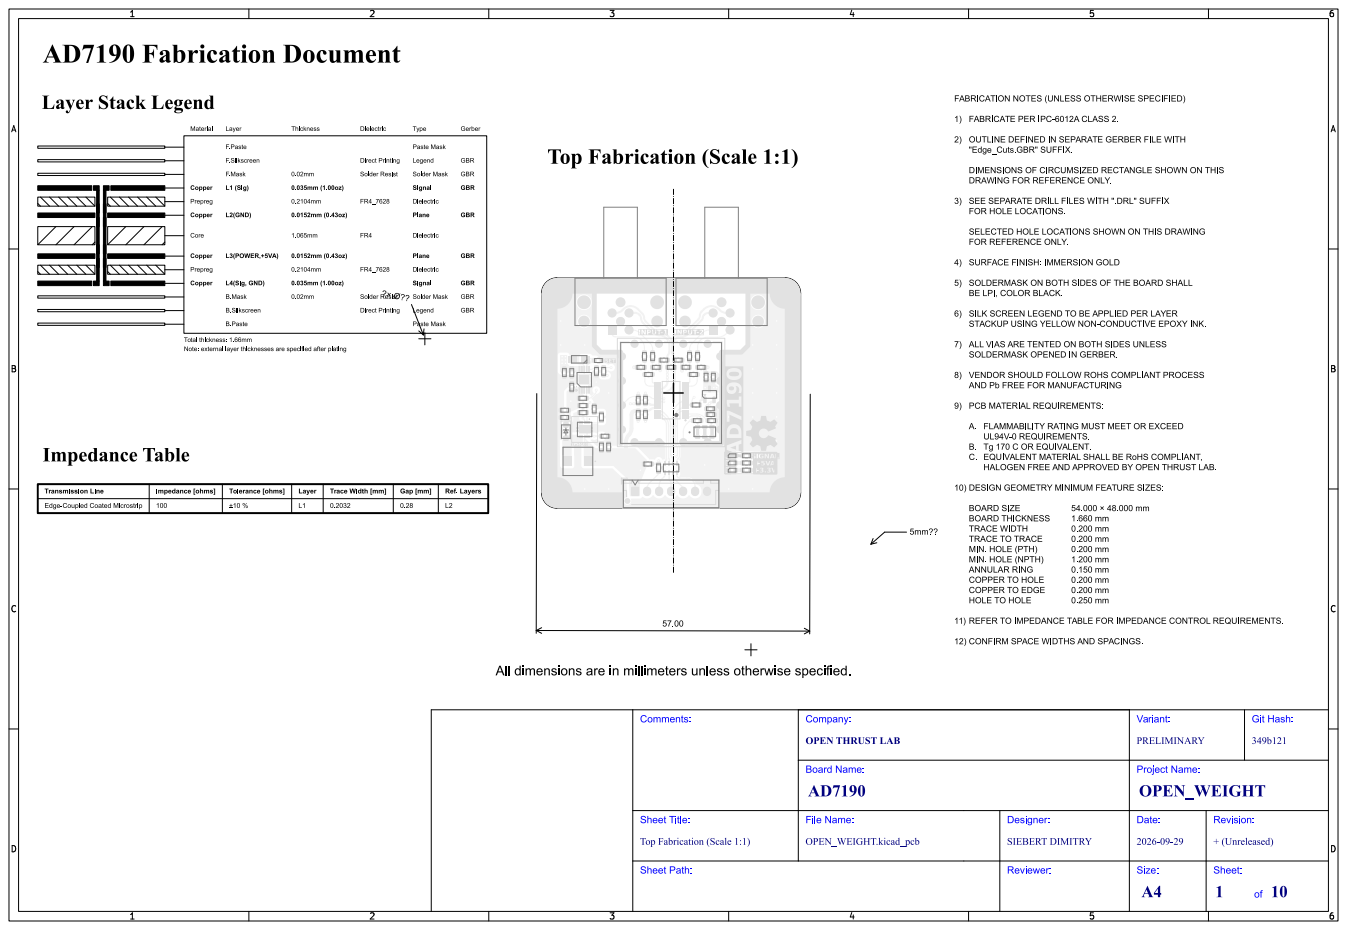
[picture p49: page 1]
Git Hash:; Comments:; Sheet Path:; Sheet Title:; File Name:; OPEN_WEIGHT; Company:; PRELIMINARY; Variant:; Board Name:; OPEN_WEIGHT.kicad_pcb; SIEBERT DIMITRY; Designer:; Reviewer:; Project Name:; Date:; + (Unreleased); Revision:; Size:; Sheet: 1

OPEN THRUST LAB

Top Fabrication (Scale 1:1)
