foukouda/OPEN_WEIGHT/Manufacturing/Fabrication/OPEN_WEIGHT-fabrication-11.pdf

# L6 (Sig, PWR) (Scale 1:1)

# AD7190 Fabrication Document

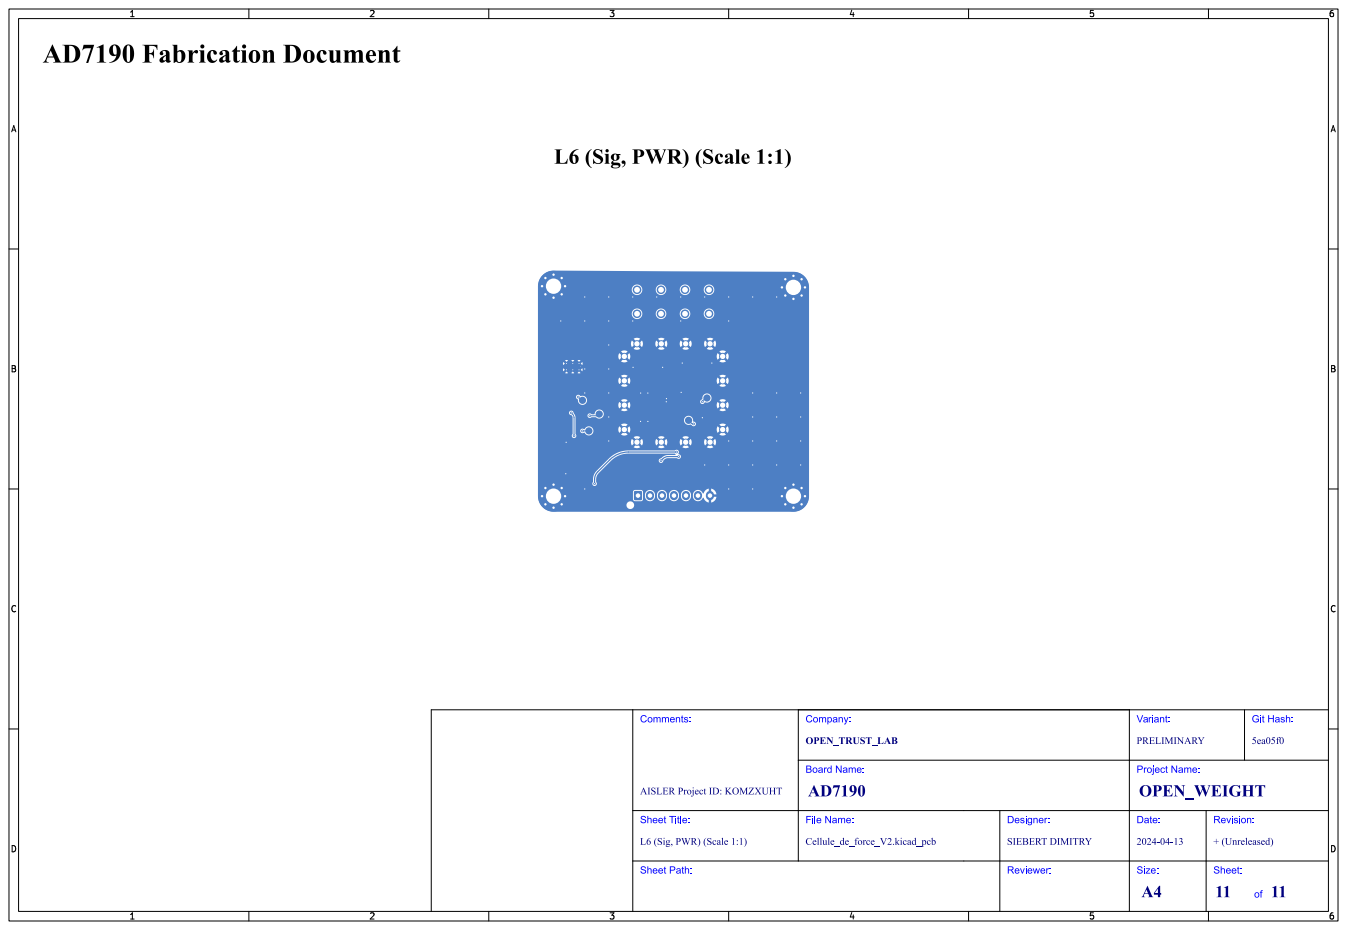
[picture p50: page 1]
Git; Hash:; Comments:; Sheet Path:; Sheet Title:; File Name:; OPEN_WEIGHT; OPEN_TRUST_LAB; Company:; PRELIMINARY; Variant:; Board Name:; Cellule_de_force_V2.kicad_pcb; SIEBERT DIMITRY; Designer:; Reviewer:; Project Name:; Date:; + (Unreleased); Revision:; Size:; Sheet: 11

AISLER Project ID: KOMZXUHT

L6 (Sig, PWR) (Scale 1:1)
