foukouda/OPEN_WEIGHT/Manufacturing/Fabrication/OPEN_WEIGHT-fabrication-6.pdf

# Bottom Test Points (Scale 1:1)

# AD7190 Fabrication Document


Bottom Test Points (Scale 1:1)
