foukouda/OPEN_WEIGHT/Manufacturing/Fabrication/Gerbers/OPEN_WEIGHT-NPTH_drill_map.pdf

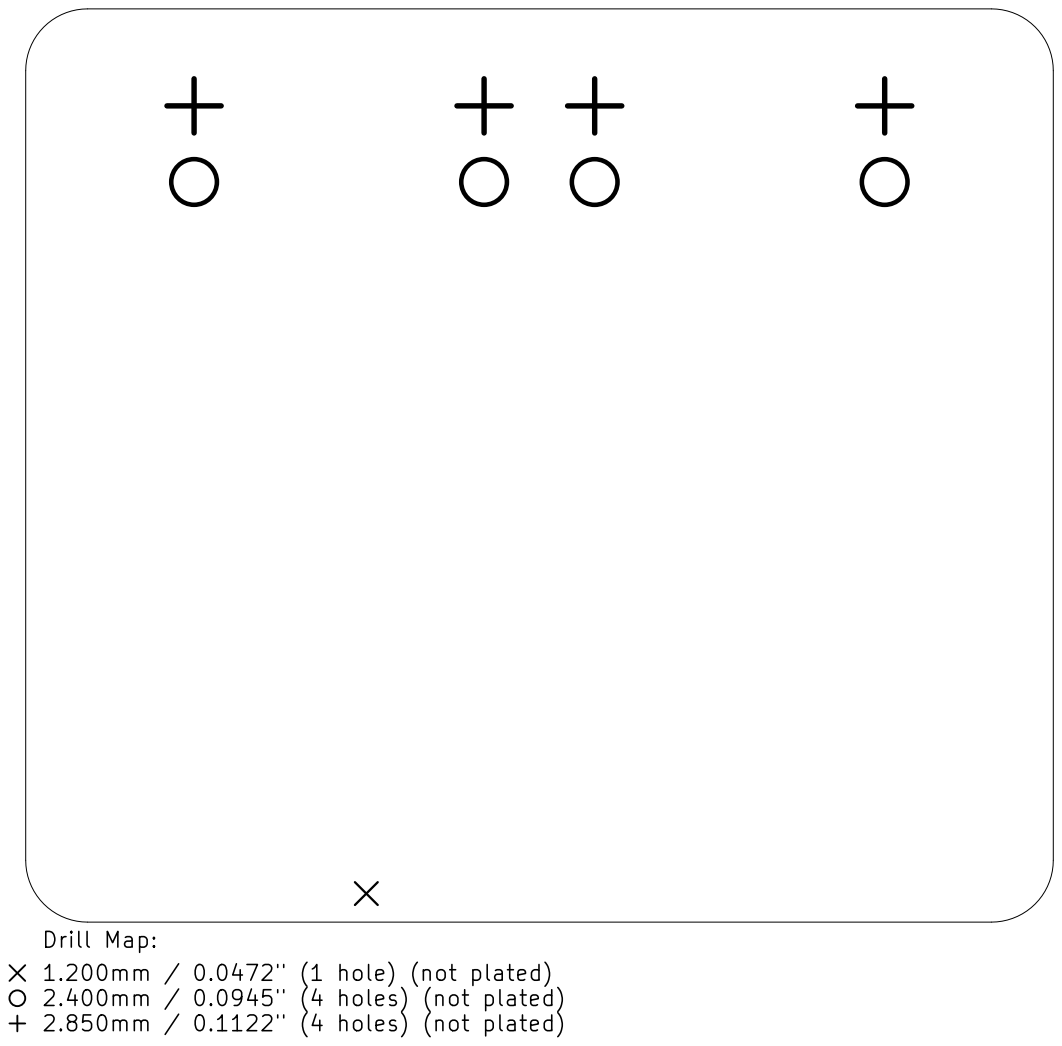
[picture p51: page 1]
