foukouda/OPEN_WEIGHT/Manufacturing/Fabrication/Gerbers/OPEN_WEIGHT-PTH_drill_map.pdf

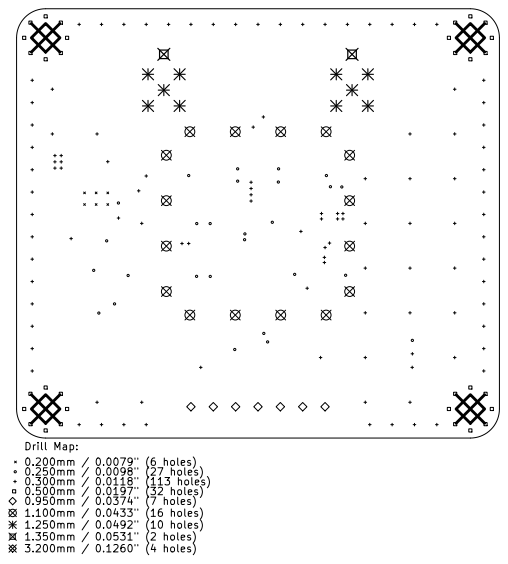
[picture p52: page 1]
