foukouda/OPEN_WEIGHT/Manufacturing/Fabrication/Gerbers/OPEN_WEIGHT-front-in2_drill_map.pdf

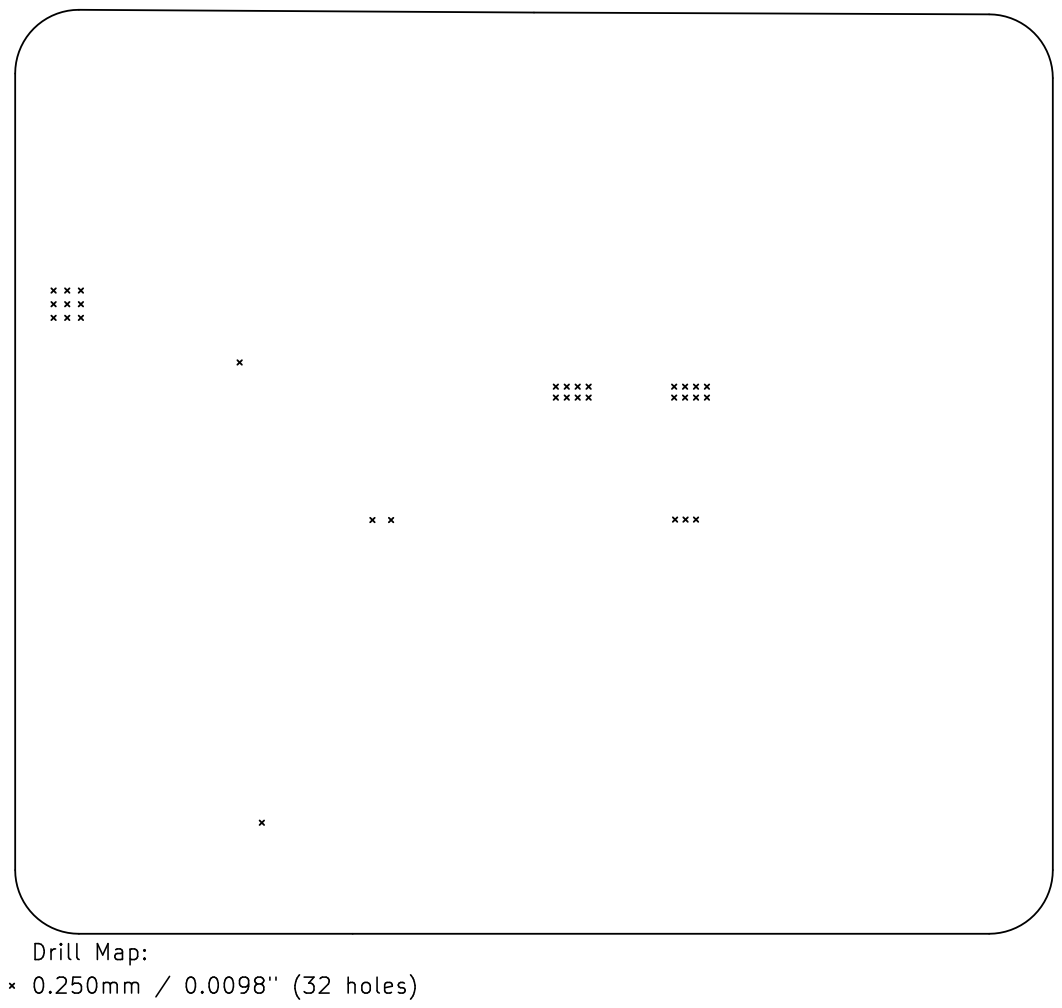
[picture p53: page 1]
