foukouda/OPEN_WEIGHT/Simulation/LTspice/01_Power_Chain_Startup.asc

C3: cap; 0.1u; Rser=20m
C4: cap; 10u; Rser=3m
C5: cap; 0.1u
C7: cap; 10n
C9: cap; 10n
C11: cap; 0.1u
C12: cap; 10u; Rser=3m
C13: cap; 4.7u; Rser=3m
C14: polcap; 2.2u; Rser=3
C15: cap; 10u; Rser=3m
C16: cap; 4.7u; Rser=5m
C17: cap; 2.2n
C18: cap; 0.1u
C19: cap; 10u; Rser=5m
C20: cap; 10u; Rser=5m
C21: cap; 10u; Rser=5m
C22: cap; 1u; Rser=10m
C23: cap; 0.1u
C26: cap; 0.1u; Rser=20m
D1: LED; QTLP690C
D3: schottky; PMEG2010EA
D4: LED; QTLP690C
I_AVDD: current; 4.5m
I_DVDD: current; 1m
IC2: TPS61086_behav
L1: ind; 4.7u; Rser=78m
Q1: pmos; SI2303_APPROX
R3: res; 100
R9: res; 50k
R10: res; 1k
R12: res; 715k
R13: res; 50k
R14: res; 200k
R15: res; 18k
R16: res; 620
R17: res; 69.8k
R18: res; 37.4k
R_BPDSW: res; 3
R_BRIDGE: res; {Rbridge}
U2: LT3042
V1: voltage; PWL(0 0 100u 3.3); Rser=20m
V_P3: voltage; 5
Named nets: 0, +3.3V, SW, COMP, CC, SS, FB, PG, +6V, SET, PGFB, +5VA, P3, SENSE+, SENSE-
OPEN_WEIGHT - 01 - Power chain start-up : +3.3V -> TPS61086 -> +6V -> LT3042 -> +5VA
Switching simulation of the complete start-up (600 ms): +5VA needs about 5 x R9 x C14 = 550 ms to settle at 5 V. Q1 kept OFF (P3 high) as after reset.
Long run (about 30 min, 2.8 GB of waveforms). Set .tran 0 25m to look at the boost soft-start only.
Host +3.3V (J1 pin 1)
AD7190 DVDD
Wurth 7447785004
PMEG2010AEH
MODE = GND
(Power Save Mode)
TPS61086 BOOST  +3.3V -> +6V   (schematic page 6)
C14 = TAJA225K016 (tantalum)
C4 C12 C3 C26 = AD7190 AVDD decoupling
AD7190 AVDD
LT3042 LDO  +6V -> +5VA   (schematic page 5)
AD7190 P3 (GPOCON)
SI2303CDS
(approx. model)
load cell
(350 ohm bridge)
AD7190 BPDSW
(low-side switch)
LOAD-CELL EXCITATION   (schematic page 4)
.tran 0 600m
.options method=gear trtol=7 reltol=0.003
.param Rbridge=350
.save V(+3.3V) V(+6V) V(+5VA) V(SS) V(SET) V(PG) I(L1)
.meas tran V6_final AVG V(+6V) FROM 590m TO 600m
.meas tran V6_max MAX V(+6V)
.meas tran T6_90 WHEN V(+6V)=5.436 RISE=1
.meas tran IL_peak MAX I(L1)
.meas tran T_PG WHEN V(PG)=3 RISE=1
.meas tran V5_25m FIND V(+5VA) AT 25m
.meas tran T5_99 WHEN V(+5VA)=4.95 RISE=1
.meas tran T5_999 WHEN V(+5VA)=4.995 RISE=1
.meas tran V5_final AVG V(+5VA) FROM 590m TO 600m
.model PMEG2010EA D(Is=1.686u Rs=.1249 N=1.015 Cjo=90.86p M=.4542 Eg=.69 Xti=2 BV=21 IBV=1u Vj=.1939 Iave=1 Vpk=20 mfg=NXP type=Schottky)
.model QTLP690C D(Is=1e-22 Rs=6 N=1.5 Cjo=50p Xti=100 Iave=160m Vpk=5 mfg=Fairchild type=LED)
.model SI2303_APPROX VDMOS(pchan Vto=-1.6 Kp=4 Rd=60m Rs=40m Rg=5 Rb=50m Cgdmax=.2n Cgdmin=.03n Cgs=.35n Cjo=.1n Is=10p ksubthres=.1 Vds=-30 Ron=190m Qg=4n)
