foukouda/OPEN_WEIGHT/Simulation/LTspice/03_Power_Ripple.asc

C3: cap; 0.1u; Rser=20m
C4: cap; 10u; Rser=3m
C5: cap; 0.1u
C7: cap; 10n
C9: cap; 10n
C11: cap; 0.1u
C12: cap; 10u; Rser=3m
C13: cap; 4.7u; Rser=3m
C14: polcap; 2.2u; Rser=3
C15: cap; 10u; Rser=3m
C16: cap; 4.7u; Rser=5m
C17: cap; 2.2n
C18: cap; 0.1u
C19: cap; 10u; Rser=5m
C20: cap; 10u; Rser=5m
C21: cap; 10u; Rser=5m
C22: cap; 1u; Rser=10m
C23: cap; 0.1u
C26: cap; 0.1u; Rser=20m
D1: LED; QTLP690C
D3: schottky; PMEG2010EA
D4: LED; QTLP690C
I_AVDD: current; 4.5m
I_DVDD: current; 1m
IC2: TPS61086_behav
L1: ind; 4.7u; Rser=78m
Q1: pmos; SI2303_APPROX
R3: res; 100
R9: res; 50k
R10: res; 1k
R12: res; 715k
R13: res; 50k
R14: res; 200k
R15: res; 18k
R16: res; 620
R17: res; 69.8k
R18: res; 37.4k
R_BPDSW: res; 3
R_BRIDGE: res; {Rbridge}
U2: LT3042
V1: voltage; PWL(0 0 100u 3.3); Rser=20m
V_P3: voltage; 0
Named nets: 0, +3.3V, SW, COMP, CC, SS, FB, PG, +6V, SET, PGFB, +5VA, P3, SENSE+, SENSE-
OPEN_WEIGHT - 03 - Steady-state ripple : boost switching noise on +6V vs. +5VA (LT3042 PSRR)
Starts from the operating point (.ic) with the excitation ON (worst-case load). Ripple measured over 3..4 ms, spectrum (FFT) over 2..6 ms.
Host +3.3V (J1 pin 1)
AD7190 DVDD
Wurth 7447785004
PMEG2010AEH
MODE = GND
(Power Save Mode)
TPS61086 BOOST  +3.3V -> +6V   (schematic page 6)
C14 = TAJA225K016 (tantalum)
C4 C12 C3 C26 = AD7190 AVDD decoupling
AD7190 AVDD
LT3042 LDO  +6V -> +5VA   (schematic page 5)
AD7190 P3 (GPOCON)
SI2303CDS
(approx. model)
load cell
(350 ohm bridge)
AD7190 BPDSW
(low-side switch)
LOAD-CELL EXCITATION   (schematic page 4)
.tran 0 6m 0 5n uic
.param Rbridge=350
.options plotwinsize=0 numdgt=15
.ic V(+6V)=6.04 V(+5VA)=5 V(SET)=5 V(SS)=1.5 V(COMP)=0.7 V(CC)=0.7 V(PG)=6 V(SENSE+)=4.9 V(SENSE-)=0.05
.save V(+6V) V(+5VA) V(SW) I(L1) I(V1) V(COMP)
.meas tran V6_avg AVG V(+6V) FROM 3m TO 4m
.meas tran V6_pp PP V(+6V) FROM 3m TO 4m
.meas tran V5_avg AVG V(+5VA) FROM 3m TO 4m
.meas tran V5_pp PP V(+5VA) FROM 3m TO 4m
.meas tran I3V3 AVG I(V1) FROM 3m TO 4m
.model PMEG2010EA D(Is=1.686u Rs=.1249 N=1.015 Cjo=90.86p M=.4542 Eg=.69 Xti=2 BV=21 IBV=1u Vj=.1939 Iave=1 Vpk=20 mfg=NXP type=Schottky)
.model QTLP690C D(Is=1e-22 Rs=6 N=1.5 Cjo=50p Xti=100 Iave=160m Vpk=5 mfg=Fairchild type=LED)
.model SI2303_APPROX VDMOS(pchan Vto=-1.6 Kp=4 Rd=60m Rs=40m Rg=5 Rb=50m Cgdmax=.2n Cgdmin=.03n Cgs=.35n Cjo=.1n Is=10p ksubthres=.1 Vds=-30 Ron=190m Qg=4n)
