foukouda/OPEN_WEIGHT/Simulation/LTspice/04_LT3042_PSRR.asc

C3: cap; 0.1u; Rser=20m
C4: cap; 10u; Rser=3m
C5: cap; 0.1u
C7: cap; 10n
C9: cap; 10n
C11: cap; 0.1u
C12: cap; 10u; Rser=3m
C13: cap; 4.7u; Rser=3m
C14: polcap; 2.2u; Rser=3
C15: cap; 10u; Rser=3m
C16: cap; 4.7u; Rser=5m
C23: cap; 0.1u
C26: cap; 0.1u; Rser=20m
D4: LED; QTLP690C
I_AVDD: current; 4.5m
Q1: pmos; SI2303_APPROX
R9: res; 50k
R10: res; 1k
R12: res; 715k
R13: res; 50k
R14: res; 200k
R16: res; 620
R_BPDSW: res; 3
R_BRIDGE: res; {Rbridge}
U2: LT3042
V_6V: voltage; 6.04; AC 1; Rser=10m
V_P3: voltage; 0
Named nets: 0, PG, +6V, SET, PGFB, +5VA, P3, SENSE+, SENSE-
OPEN_WEIGHT - 04 - LT3042 PSRR : transfer from +6V ripple to +5VA
PSRR(dB) = -20*log10|V(+5VA)/V(+6V)|.  1.2 MHz = TPS61086 switching frequency.
+6V with
1 V AC ripple
C14 = TAJA225K016 (tantalum)
C4 C12 C3 C26 = AD7190 AVDD decoupling
AD7190 AVDD
LT3042 LDO  +6V -> +5VA   (schematic page 5)
AD7190 P3 (GPOCON)
SI2303CDS
(approx. model)
load cell
(350 ohm bridge)
AD7190 BPDSW
(low-side switch)
LOAD-CELL EXCITATION   (schematic page 4)
.ac dec 50 10 10Meg
.param Rbridge=350
.meas ac PSRR_1k FIND mag(V(+5VA)) AT 1k
.meas ac PSRR_100k FIND mag(V(+5VA)) AT 100k
.meas ac PSRR_1M2 FIND mag(V(+5VA)) AT 1.2Meg
.model PMEG2010EA D(Is=1.686u Rs=.1249 N=1.015 Cjo=90.86p M=.4542 Eg=.69 Xti=2 BV=21 IBV=1u Vj=.1939 Iave=1 Vpk=20 mfg=NXP type=Schottky)
.model QTLP690C D(Is=1e-22 Rs=6 N=1.5 Cjo=50p Xti=100 Iave=160m Vpk=5 mfg=Fairchild type=LED)
.model SI2303_APPROX VDMOS(pchan Vto=-1.6 Kp=4 Rd=60m Rs=40m Rg=5 Rb=50m Cgdmax=.2n Cgdmin=.03n Cgs=.35n Cjo=.1n Is=10p ksubthres=.1 Vds=-30 Ron=190m Qg=4n)
