foukouda/OPEN_WEIGHT/Simulation/LTspice/05_AD7190_Input_Filter.asc

C27c: cap; 10n
C27d: cap; 10n
C28c: cap; 0.1u
C28d: cap; 0.1u
C29c: cap; 10n
C29d: cap; 10n
R4c: res; 100
R4d: res; 100
R5c: res; 100
R5d: res; 100
Rs_nc: res; 175
Rs_nd: res; 175
Rs_pc: res; 175
Rs_pd: res; 175
Vnc: voltage; 2.5; AC 1
Vnd: voltage; 2.5; AC 0.5 180
Vpc: voltage; 2.5; AC 1
Vpd: voltage; 2.5; AC 0.5
Named nets: 0, INPd, OUTPd, INNd, OUTNd, INPc, OUTPc, INNc, OUTNc
OPEN_WEIGHT - 05 - AD7190 analog input RC filter (J4 channel)
R4/R5 = 100 ohm, C27/C29 = 10 nF, C28 = 100 nF. Same topology on J2 (R1/R2, C6, C8, C10).
-> AIN2
-> AIN1
load-cell output: 350 ohm bridge = 175 ohm per leg
DIFFERENTIAL signal
-> AIN2
-> AIN1
load-cell output: 350 ohm bridge = 175 ohm per leg
COMMON-MODE disturbance
.ac dec 100 10 100Meg
.meas ac F3dB_diff WHEN mag(V(OUTPd,OUTNd))=0.7071
.meas ac F3dB_cm WHEN mag(V(OUTPc))=0.7071
.meas ac ATT_diff_1M2 FIND mag(V(OUTPd,OUTNd)) AT 1.2Meg
