foukouda/OPEN_WEIGHT/OPEN_WEIGHT.kicad_pcb

## KiCad design OPEN_WEIGHT.kicad_pcb (2026-09-29)

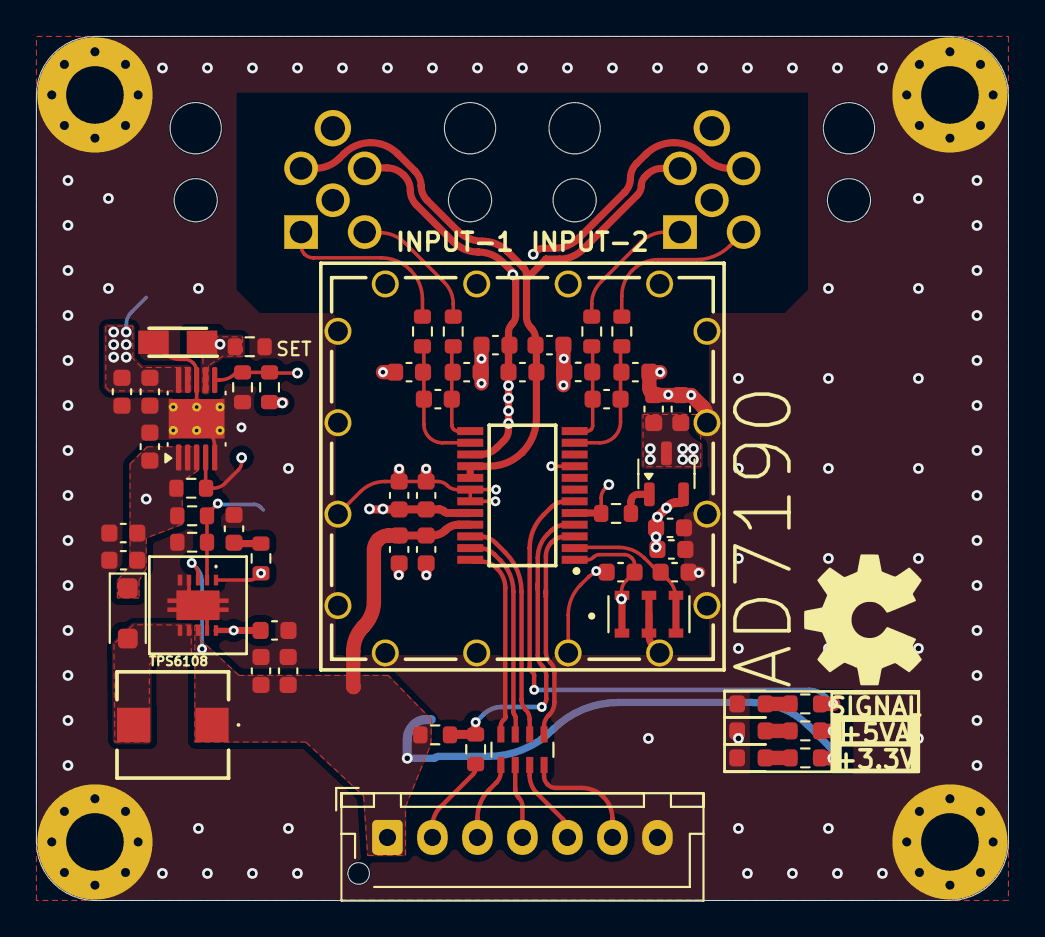
[picture p54: board OPEN_WEIGHT.kicad_pcb from above]

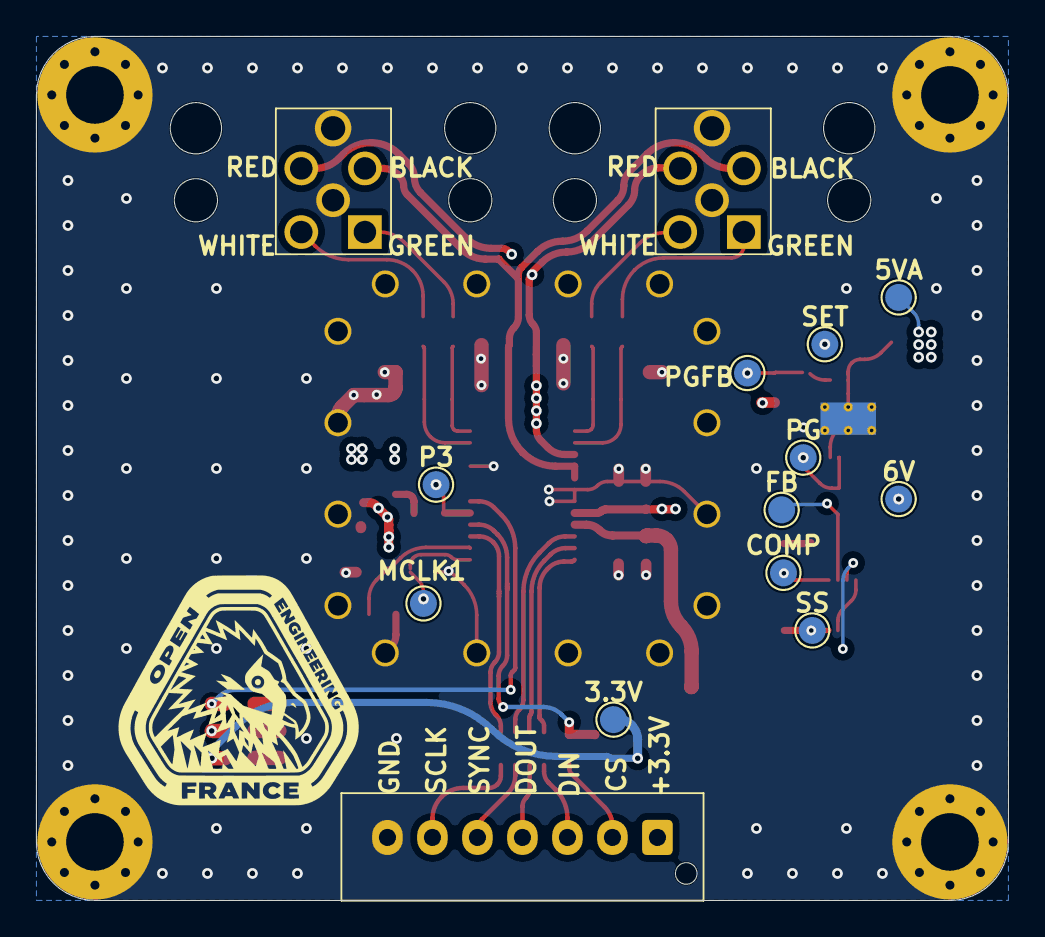
[picture p55: board OPEN_WEIGHT.kicad_pcb from below]

Board: 4 copper layers, 54.0 x 48.0 mm, 76 parts (11 on the bottom side), 40 nets.

Parts:
C1, C3, C5, C6, C11, C23, C26, C28: 0.1µF; C_0603_1608Metric
C2, C4, C12, C15, C19, C20, C21: 10µF; C_0603_1608Metric
C7, C8, C9, C10, C27, C29: 0.01µF; C_0603_1608Metric
C13, C16: 4.7µF; C_0603_1608Metric
C14: TAJA225K016RNJ; CAPPM3216X180N
C17: 2.2nF; C_0603_1608Metric
C18: 0.1uF; C_0603_1608Metric
C22: 1µF; C_0603_1608Metric
C24, C25: 18pf; C_0603_1608Metric
D1, D4: LED; LED_0603_1608Metric
D2: RED; LED_0603_1608Metric
D3: PMEG2010AEH; D_SOD-123F
H1, H2, H3, H4: MountingHole_Pad; MountingHole_3.2mm_M3_Pad_Via
H5: WE-SHC_THT-FRAME; WE-SHC_THT-FRAME_36503205
IC2: TPS61086DRCR; TPS16412DRCR
J1: Conn_01x07_Pin; JST_XH_B7B-XH-AM_1x07_P2.50mm_Vertical
J2, J4: 21033213501
L1: 7447785004
Q1: SI2303CDS-T1-GE3; SOT-23-3
R1, R2, R3, R4, R5, R6, R11: 100Ω; R_0603_1608Metric
R8: 100kΩ; R_0603_1608Metric
R9, R13: 50kΩ; R_0603_1608Metric
R10: 1kΩ; R_0603_1608Metric
R12: 715kΩ; R_0603_1608Metric
R14: 200kΩ; R_0603_1608Metric
R15: 18kΩ; R_0603_1608Metric
R16: 620Ω; R_0603_1608Metric
R17: 69.8kΩ; R_0603_1608Metric
R18: 37.4kΩ; R_0603_1608Metric
RN1: RP_100Ω; R_Array_Concave_4x0603
TP2, TP4, TP5, TP11, TP12, TP13, TP14, TP15, TP16, TP17, TP18: TestPoint; TestPoint_Pad_D1.5mm
U1: AD7190WBRUZ; SOP65P640X120-24N
U2: LT3042IMSE; MSOP-10-1EP_3x3mm_P0.5mm_EP2.2x3.1mm_Mask1.83x1.89mm_Therma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
Y2: CSTCR4M91G53-R0; OSC_CSTCR4M91G53-R0

Connections:
+3.3V: C1.1, C2.1, C21.1, C22.1, IC2.3 (EN), IC2.8 (IN), J1.1, L1.1, R3.2, R8.1, TP4.1, U1.21 (DVDD)
+5VA: C3.2, C4.2, C12.1, C13.1, C15.1, C26.1, Q1.2 (S), R12.2, R16.2, TP5.1, U1.20 (AVDD), U2.9 (OUTS), U2.10 (OUT)
+6V: C16.1, C19.1, C20.1, D3.1 (K), R14.1, R17.2, TP11.1, U2.1 (IN), U2.2 (IN), U2.3 (EN/UV)
/Project Architecture/LT3042_6V_to_5VA/PG: R14.2, TP17.1, U2.4 (PG)
/Project Architecture/LT3042_6V_to_5VA/PGFB: R12.1, R13.2, TP13.1, U2.6 (PGFB)
/Project Architecture/LT3042_6V_to_5VA/SET: C14.1 (+), R9.2, TP12.1, U2.7 (SET)
/Project Architecture/TPS61086_3.3V_to_6V/COMP: IC2.1 (COMP), R18.2, TP16.1
/Project Architecture/TPS61086_3.3V_to_6V/FB: IC2.2 (FB), R15.2, R17.1, TP14.1
/Project Architecture/TPS61086_3.3V_to_6V/SS: C18.1, IC2.10 (SS), TP15.1
CS: J1.2, R6.1
DIN: J1.3, RN1.5 (R4.2)
DOUT: J1.4, RN1.6 (R3.2)
GND: C1.2, C2.2, C3.1, C4.1, C7.1, C8.2, C9.2, C10.1, C11.2, C12.2, C13.2, C14.2 (-), C15.2, C16.2, C17.2, C18.2, C19.2, C20.2, C21.2, C22.2, C23.2, C24.2, C25.2, C26.2, C27.1, C29.2, D1.1 (K), D2.1 (K), D4.1 (K), H1.1, H2.1, H3.1, H4.1, H5.1, H5.2, H5.3, H5.4, H5.5, H5.6, H5.7, H5.9, H5.10, H5.11, H5.12, H5.13, H5.14, H5.15, H5.16, H5.17, IC2.4 (AGND), IC2.5 (PGND), IC2.9 (MODE), IC2.11 (EP), IC2.12 (EP_2), IC2.13 (EP_3), IC2.14 (EP_4), IC2.15 (EP_5), J1.7, J2.5, J2.S1 (SHIELD), J4.5, J4.S1 (SHIELD), R9.1, R13.1, R15.1, U1.9 (NC), U1.18 (AGND), U1.19 (DGND), U2.5 (ILIM), U2.8 (GND), U2.11 (GND), Y2.2
IN-OUT+: J4.1, R4.1
IN-OUT+2: J2.1, R2.1
IN-OUT-: J4.2, R5.1
IN-OUT-2: J2.2, R1.1
MCLK1: C25.1, TP2.1, U1.1 (MCLK1), Y2.1
MCLK2: C24.1, U1.2 (MCLK2), Y2.3
unnamed: C17.1, R18.1
unnamed: D1.2 (A), R3.1
unnamed: D2.2 (A), R11.2
unnamed: D3.2 (A), IC2.6 (SW_1), IC2.7 (SW_2), L1.2
unnamed: D4.2 (A), R16.1
unnamed: Q1.1 (G), R10.2
unnamed: RN1.1 (R1.1), U1.3 (SCLK)
unnamed: RN1.2 (R2.1), U1.22 (~SYNC)
unnamed: RN1.3 (R3.1), U1.23 (DOUT/~RDY)
unnamed: RN1.4 (R4.1), U1.24 (DIN)
unnamed: R11.1, U1.6 (P2)
unnamed: R6.2, R8.2, U1.4 (~CS)
OUT+: C27.2, C28.1, R4.2, U1.12 (AIN2)
OUT+2: C6.1, C10.2, R1.2, U1.13 (AIN3)
OUT-: C28.2, C29.1, R5.2, U1.11 (AIN1)
OUT-2: C6.2, C8.1, R2.2, U1.14 (AIN4)
P3: R10.1, TP18.1, U1.5 (P3)
SCLK: J1.6, RN1.8 (R1.2)
SENSE+: C5.1, C7.2, C11.1, C23.1, J2.3, J4.3, Q1.3 (D), U1.15 (REFIN1(+))
SENSE-: C5.2, C9.1, J2.4, J4.4, U1.16 (REFIN1(-)), U1.17 (BPDSW)
SYNC: J1.5, RN1.7 (R2.2)
