foukouda/OPEN_WEIGHT/(commit log)

2026-02-22 Update Outputs
    [Cellule_de_force_V2-bom.csv]
2026-02-23 [Schématique test]
    [Project Architecture.kicad_sch, Section C - TItle C.kicad_sch]
2026-02-24 [FINISH LT3042 and ad TPS6108]
    [Project Architecture.kicad_sch, Section A - Title A.kicad_sch, Section C - TItle C.kicad_sch, Section D - TItle D.kicad_sch]
2026-02-24 [ADD TPS6108]
    [Project Architecture.kicad_sch, Section B - TItle B.kicad_sch, Section C - TItle C.kicad_sch, Section E - TItle E.kicad_sch]
2026-02-25 [Finish schématique]
    [Section B - TItle B.kicad_sch, Section C - TItle C.kicad_sch, Section D - TItle D.kicad_sch]
2026-02-25 [Finish schématiq]
    [Project Architecture.kicad_sch, Section A - Title A.kicad_sch, Section B - TItle B.kicad_sch, Section C - TItle C.kicad_sch, Section D - TItle D.kicad_sch, Section E - TItle E.kicad_sch]
2026-02-27 [PCB fini]
    [Cellule_de_force_V2.kicad_pcb, Section A - Title A.kicad_sch, Section B - TItle B.kicad_sch, Section D - TItle D.kicad_sch]
2026-02-27 [PCB 2]
    [Cellule_de_force_V2.kicad_pcb]
2026-02-27 [PCB 3]
2026-02-27 [PCB 4]
    [Cellule_de_force_V2.kicad_pcb]
2026-02-27 [PCB 5]
2026-02-27 [PCB 6]
2026-03-10 [PCB 4 layer]
    [Cellule_de_force_V2.kicad_pcb, Section A - Title A.kicad_sch, Section B - TItle B.kicad_sch, Section C - TItle C.kicad_sch, Section D - TItle D.kicad_sch]
2026-03-12 [PCB V1]
    [Cellule_de_force_V2.kicad_pcb, Section A - Title A.kicad_sch, Section B - TItle B.kicad_sch, Section C - TItle C.kicad_sch, Section D - TItle D.kicad_sch]
2026-03-13 [PCB V2]
    [Cellule_de_force_V2.kicad_pcb, Section A - Title A.kicad_sch]
2026-03-13 Enhance README.md for better project documentation
    Update README.md with improved clarity and detail on project specifications, calibration, and usage instructions.
2026-03-14 [PCB V3]
    [Cellule_de_force_V2.kicad_pcb, Project Architecture.kicad_sch, Section A - Title A.kicad_sch, Section B - TItle B.kicad_sch, Section C - TItle C.kicad_sch, Section D - TItle D.kicad_sch, Section E - TItle E.kicad_sch]
2026-03-16 [PCB V4]
    [Block Diagram.kicad_sch, Cellule_de_force_V2.kicad_pcb, Cellule_de_force_V2.kicad_sch, Power - Sequencing.kicad_sch, Project Architecture.kicad_sch, Section A - Title A.kicad_sch, Section B - TItle B.kicad_sch, Section C - TItle C.kicad_sch]
2026-03-18 [PCB FINAL]
    [Cellule_de_force_V2.kicad_pcb]
2026-03-18 [PCB FINA]
2026-03-21 [PCB FIN]
    [Cellule_de_force_V2.kicad_pcb]
2026-03-21 [PCB FI]
2026-09-29 Save KiCad 10 design work (schematic + PCB) since March
    [Block Diagram.kicad_sch, Cellule_de_force_V2.kicad_pcb, Cellule_de_force_V2.kicad_sch, Power - Sequencing.kicad_sch, Project Architecture.kicad_sch, Revision History.kicad_sch, Section A - Title A.kicad_sch, Section B - TItle B.kicad_sch]
2026-09-29 Clean up project for KDT template: rename, metadata, KiCad 10 CI
    - Rename project Cellule_de_force_V2 -> OPEN_WEIGHT and sheets after their function
    (fix AD7910 -> AD7190 typo), update all sheet/project references in sch/pcb/pro
    - Real title-block titles, sheet headers use ${TITLE}, restore KDT drawing sheets,
    remove template leftovers from PCB title block
    - kibot_main.yaml: COMPANY = OPEN THRUST LAB, GIT_URL = foukouda/OPEN_WEIGHT
    - CI: add KiCad 10 (KiBot v2_dk10), PRELIMINARY variant on dev
    - README now generated from kibot_resources/templates/readme.txt; fill CHANGELOG
    - Move mechanical CAD to Mechanical/, extend .gitignore, untrack 3Dx logs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
    [AD7190 - Weight Sensor.kicad_sch, Connectors.kicad_sch, Holes - Fiducials.kicad_sch, LT3042 - LDO 6V to 5VA.kicad_sch, OPEN_WEIGHT-(L1-L2)_drill_table.csv, OPEN_WEIGHT-(L1-L3)_drill_table.csv, OPEN_WEIGHT-(L1-L4)_NPTH_drill_table.csv, OPEN_WEIGHT-(L1-L4)_drill_table.csv]
2026-09-29 Fix load-cell connectivity between Connectors and AD7190 sheets
    IN-OUT/IN-SENSE were local labels on two sheets, so the connectors were not
    connected to the ADC in the schematic. Convert them to global labels (IN-SENSE
    merged into SENSE), and align label polarity on J2/J4 with the routed copper.
    [AD7190 - Weight Sensor.kicad_sch, Connectors.kicad_sch, OPEN_WEIGHT.kicad_pcb]
2026-09-29 Self-contained libraries, JLCPCB rules, ERC/DRC cleanup
    - lib/: project symbol library (19 symbols), footprint library (17 footprints)
    and all 3D models (15), referenced through ${KIPRJMOD} + project lib tables.
    A fresh clone now opens with every symbol, footprint and 3D model.
    - Remove duplicated / absolute 3D model paths (C:/Users/..., ${KICAD_FOOTPRINT})
    - OPEN_WEIGHT.kicad_dru: JLCPCB 4-layer rules; stackup JLC04161H-7628; board minimums
    - AD7190 footprint: drop per-pad 0.102 mm mask margin (mask bridges at 0.65 mm pitch)
    - Exclude unplaced TP/FID symbols from board; PWR_FLAGs; decorative wires -> lines
    - Local text variables in .kicad_pro; Revision History wired to [Unreleased]
    - ge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
    [AD7190 - Weight Sensor.kicad_sch, Connectors.kicad_sch, Holes - Fiducials.kicad_sch, LT3042 - LDO 6V to 5VA.kicad_sch, OPEN_WEIGHT.kicad_pcb, OPEN_WEIGHT.kicad_sch, Project Architecture.kicad_sch, Revision History.kicad_sch]
2026-09-29 Fill template pages: block diagram, power sequencing, notes, revision history
    Block Diagram and Power - Sequencing rebuilt from the real design (values computed
    from the schematic); cover-page design notes, connector pinout notes, title-block
    references; kicad-mcp-pro MCP config (.mcp.json).
    [Block Diagram.kicad_sch, Connectors.kicad_sch, Holes - Fiducials.kicad_sch, OPEN_WEIGHT.kicad_sch, Power - Sequencing.kicad_sch, TPS61086 - Boost 3V3 to 6V.kicad_sch]
2026-09-29 README/CHANGELOG: correct design facts from the netlist, document lib/ and JLCPCB
    Ratiometric reference (REFIN1 = bridge excitation), J1 7-pin pinout, excitation via
    AD7190 P3/GPOCON, LT3042 soft-start (tau 110 ms -> wait >= 600 ms), FS register value.
2026-09-29 Redesign Project Architecture sheet, update dates, refresh netlists
    - Project Architecture: aligned hierarchy blocks with per-sheet summaries,
    power chain (+3.3V -> +6V -> +5VA), host <-> AD7190 links, legend and
    hyperlinked document index
    - Title-block date set to 2026-09-29 on all sheets
    - Regenerate OPEN_WEIGHT.xml / OPEN_WEIGHT-netlist.net with KiCad 10
    [AD7190 - Weight Sensor.kicad_sch, Block Diagram.kicad_sch, Connectors.kicad_sch, Holes - Fiducials.kicad_sch, LT3042 - LDO 6V to 5VA.kicad_sch, OPEN_WEIGHT.kicad_sch, Power - Sequencing.kicad_sch, Project Architecture.kicad_sch]
2026-09-29 Make schematic graphics parseable by KiBot (CI fix)
    KiBot's schematic reader only accepts (polyline (pts) (stroke) (uuid)) at
    sheet level, so the notes step failed on "Wrong number of attributes for
    polyline". Drop the (fill (type none)) blocks and redraw the filled
    arrowheads as nested outlines, which render identically.
    [Block Diagram.kicad_sch, Power - Sequencing.kicad_sch, Project Architecture.kicad_sch]
2026-09-29 Add LTspice simulations of the power chain and ADC input filter
    - Simulation/LTspice: 5 wired schematics built from the KiCad netlist
    (boost start-up, LT3042 start-up/PG/excitation, ripple, PSRR, AIN filter)
    - Behavioral TPS61086 model (no vendor LTspice model exists)
    - run_simulations.py runs LTspice in batch mode and redraws Images/Simulation
    - README: new SIMULATION section; start-up table corrected from the
    simulation (PG ~5 ms, +5VA 99 % ~250 ms)
2026-10-08 Extend the start-up simulation to 600 ms and add an FFT of the rails
    01_Power_Chain_Startup stopped at 25 ms, in the middle of the LT3042
    settling (tau = R9 x C14 = 110 ms after the fast start-up), so +5VA was
    shown at 4.64 V. It now runs 600 ms: +5VA reaches 99 % at 241 ms and
    4.998 V at 600 ms. Solver options trtol=7 reltol=0.003 keep the run at
    about 30 min (same results within 0.2 %).
    03_Power_Ripple runs 6 ms in double precision so that run_simulations.py
    can compute the spectrum of +6V and +5VA (new sim03_spectrum.png, with
    the standby spectrum taken from the end of 01).
    run_simulations.py: --only to run selected simulations, .raw files are
    memory-mapped (the 01 output is 2.8 GB). ge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
2026-10-09 Add an openEMS simulation of the layout coupling to the AD7190 inputs
    The routed copper is meshed in openEMS and four sources of the boost stage
    are driven in turn: switch node voltage, commutation loop, input loop and a
    loop standing for the stray field of L1, on the bare board and with the
    shield H5 and its cover. measurement_quality.py turns the couplings into a
    voltage between the two pins of each ADC input, with the waveforms of
    LTspice simulation 03 and the input filter read from the board.
    Worst case at 1.2 MHz: 3.8 nV (J4) and 38 nV (J2) on the bare board, 15 nV
    on both with the cover, against 8.5 nV of AD7190 noise. Capacitive coupling
    is negligible, the stray field of L1 is only b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
2026-10-15 Replace the project logo with the INGÉNIERIE FRANCE badge
    - Logos/LOGO.png (README, KiBot HTML): rooster/snake badge with a
    transparent background outside the badge
    - Title-block logo replaced on every schematic sheet; Open Hardware
    logo symbol removed from the cover page
    - Back silkscreen LOGO footprint redrawn: 13.2 mm, strokes thickened to
    0.15 mm minimum, shifted 0.3 mm to clear H5 pad 4 (DRC unchanged)
2026-10-24 Restyle the schematic like OPEN_PHASE, merge the power sheets, rework the bottom silkscreen
    - Schematic: all sheets on A3 in the OPEN_PHASE look (red header bands,
    DESCRIPTION / DESIGN NOTE / LAYOUT NOTE / CALCULS & BUDGET panels in
    French, TEST POINTS panel, References in the title block)
    - Title block: INGENIERIE FRANCE logo in KDT_Template_GIT.kicad_wks,
    per-sheet logo images removed
    - Power - Sequencing rebuilt with curves from LTspice simulations 01-04
    - TPS61086 and LT3042 sheets merged into Power Supply - Analog Rails
    (page 5, keeps the TPS sheet UUID); pages renumbered to 9, local nets
    renamed to /Project Architecture/Power_Supply/*, PCB links updated
    - PCB: per-rail net co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
2026-10-24 Redo the 3D animation like OPEN_PHASE
    - Images/OPEN_WEIGHT.mp4 (1080x1080, 30 fps) and OPEN_WEIGHT-spin.gif
    (480x480, 15 fps) re-rendered with kicad-cli raytracing from the
    current board: 12 s loop (hold, 360 deg spin, hold, 360 deg tumble
    showing the bottom silkscreen), studio gradient background, blue mask
    and white silk on a scratch copy only (the board stackup is unchanged)
    - README template: video caption names kicad-cli instead of SpinRender
