foukouda/OPEN_WEIGHT/(notices)

Notices in the files:
kibot_resources/templates/readme.txt:
License: CERN-OHL-P v2
